TomiXRM/LEGEND_RCJ/MyRobots/MyRobots6.JPG

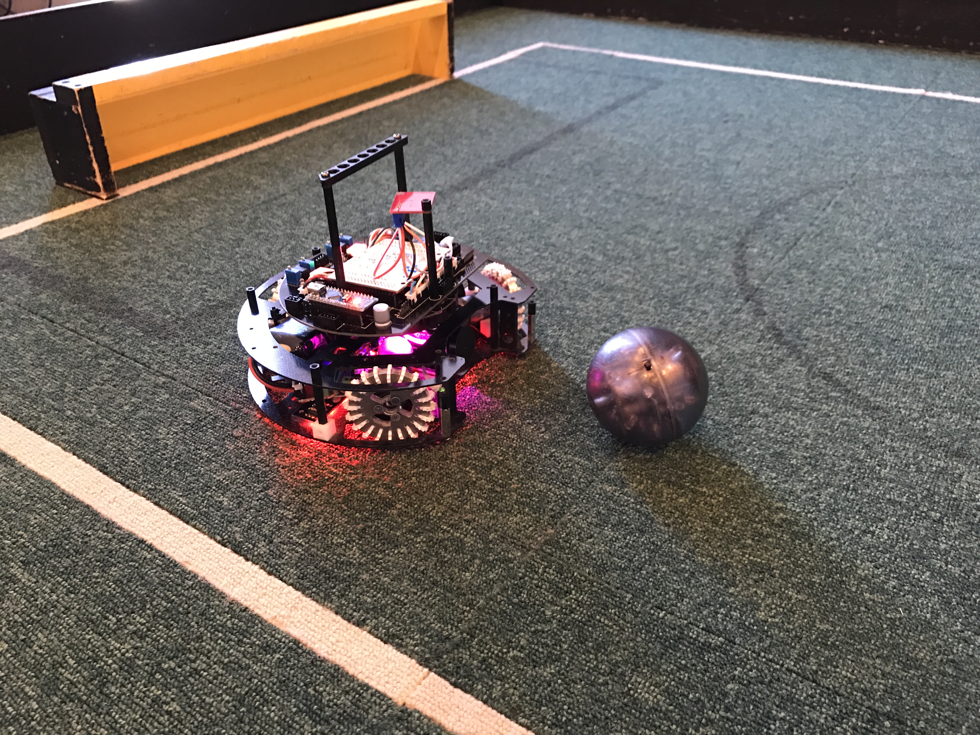
MyRobots/MyRobots6.JPG
