TomiXRM/LEGEND_RCJ/MyRobots/MyRobots5.jpg

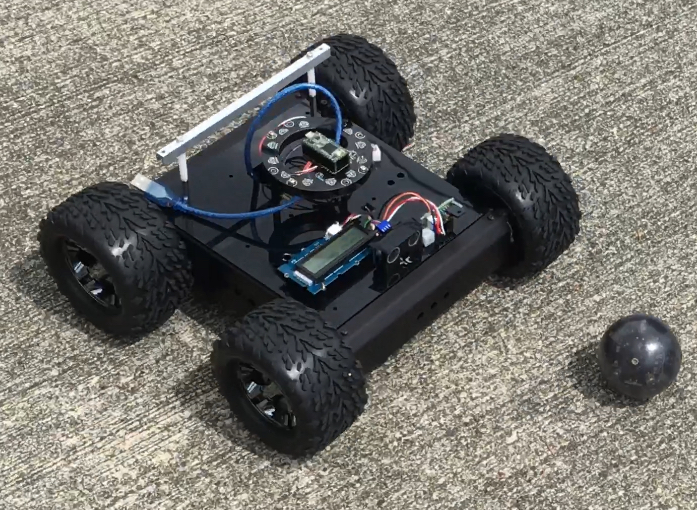
MyRobots/MyRobots5.jpg
