TomiXRM/LEGEND_RCJ/MyRobots/IMG_3049.jpg

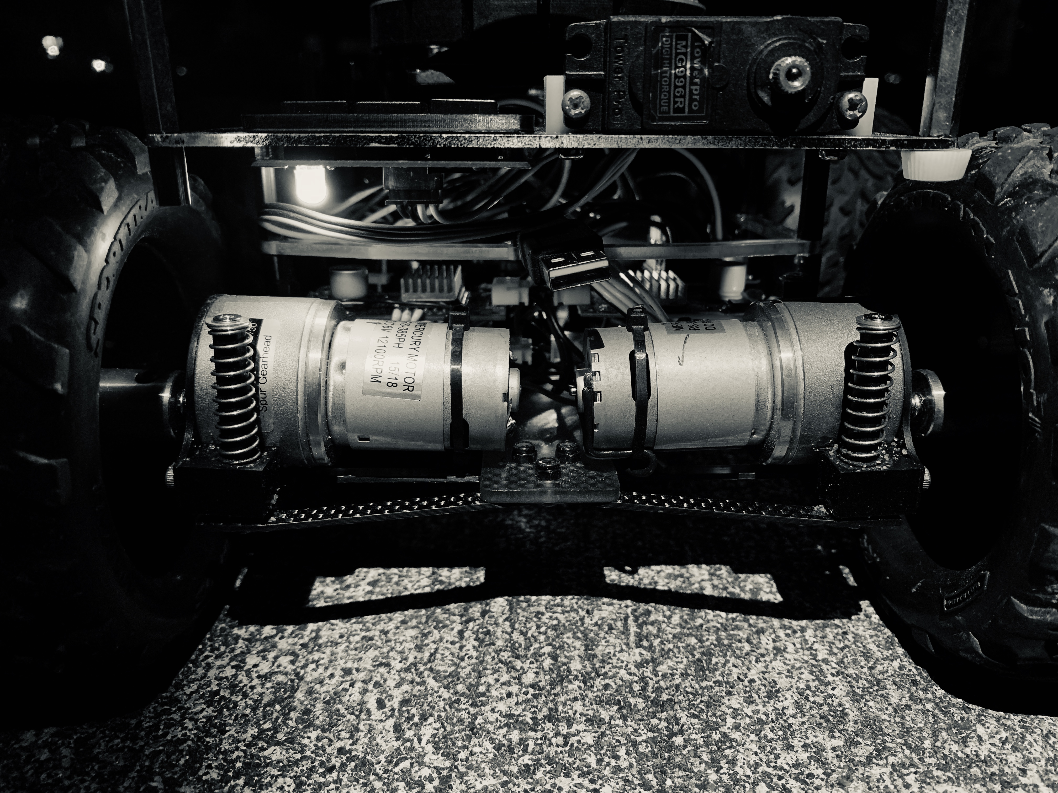
MyRobots/IMG_3049.jpg
