TomiXRM/LEGEND_RCJ/MyRobots/MyRobots3.JPG

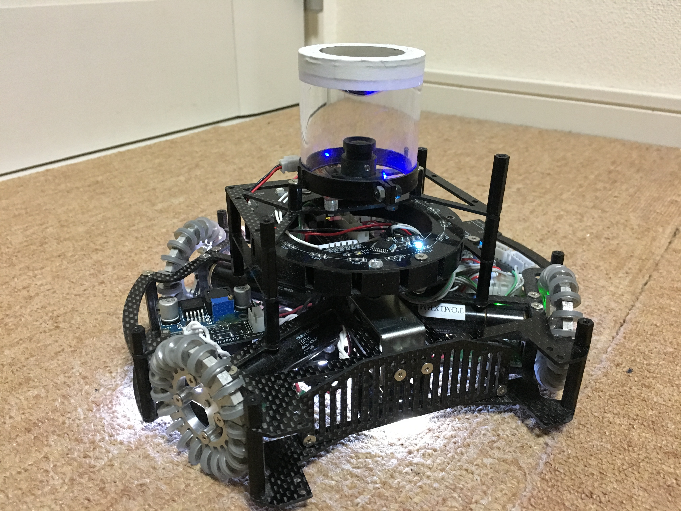
MyRobots/MyRobots3.JPG
