TomiXRM/LEGEND_RCJ/MyRobots/MyRobots7.jpg

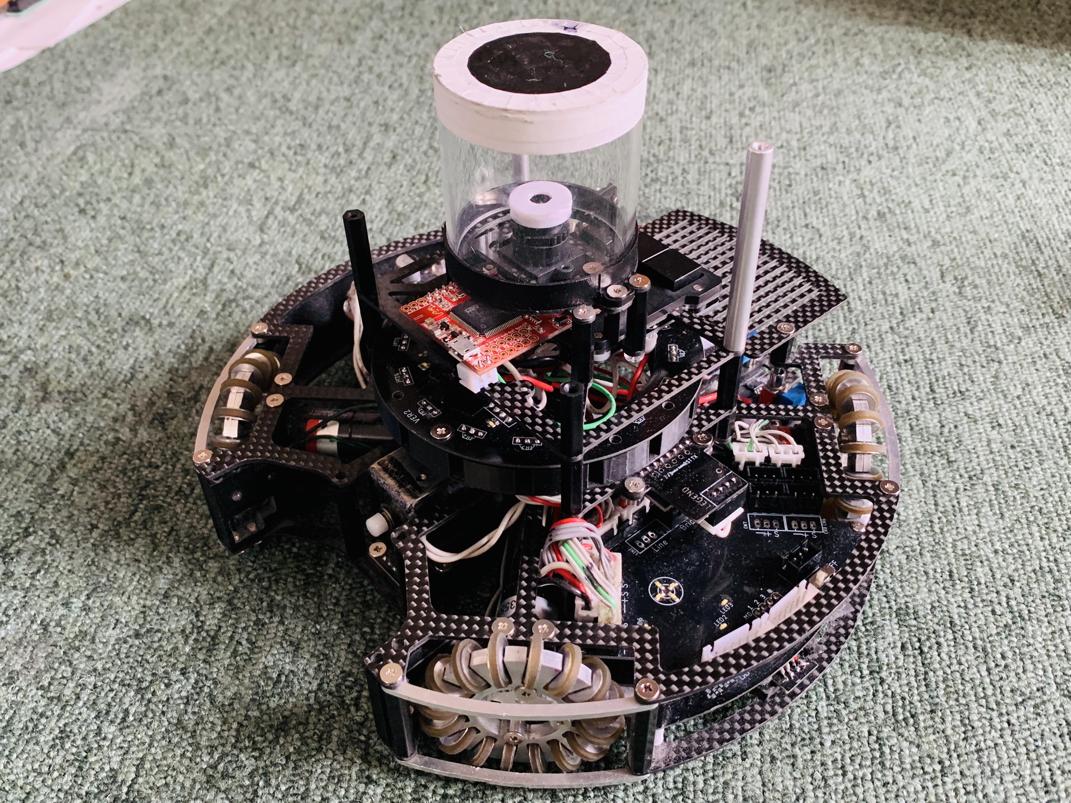
MyRobots/MyRobots7.jpg
