TomiXRM/LEGEND_RCJ/MyRobots/MyRobots9.JPG

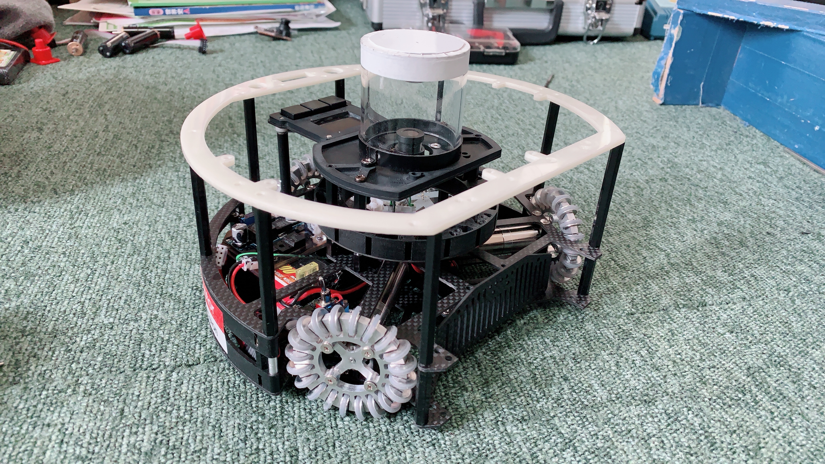
MyRobots/MyRobots9.JPG
