TomiXRM/LEGEND_RCJ/MyRobots/MyRobots10.jpg

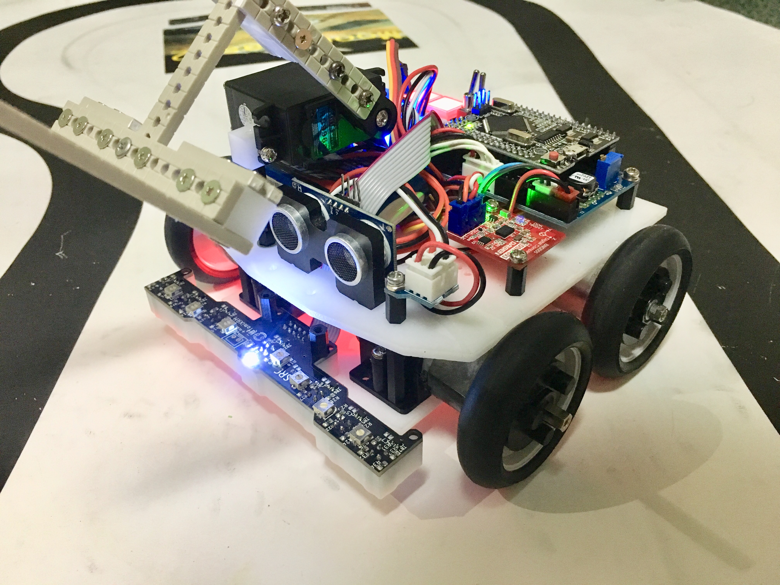
MyRobots/MyRobots10.jpg
