TomiXRM/LEGEND_RCJ/RoboCup2022 SSL/Hardware2021/うち歯車キャリア/加工経路リスト.png

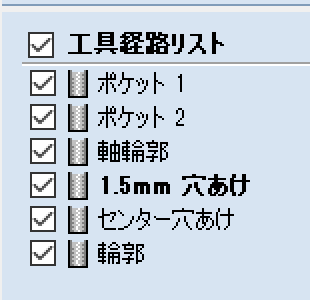
RoboCup2022 SSL/Hardware2021/うち歯車キャリア/加工経路リスト.png
