TomiXRM/LEGEND_RCJ/RoboCup-LEGEND2021/circuit/LEGEND2022/main.dxf

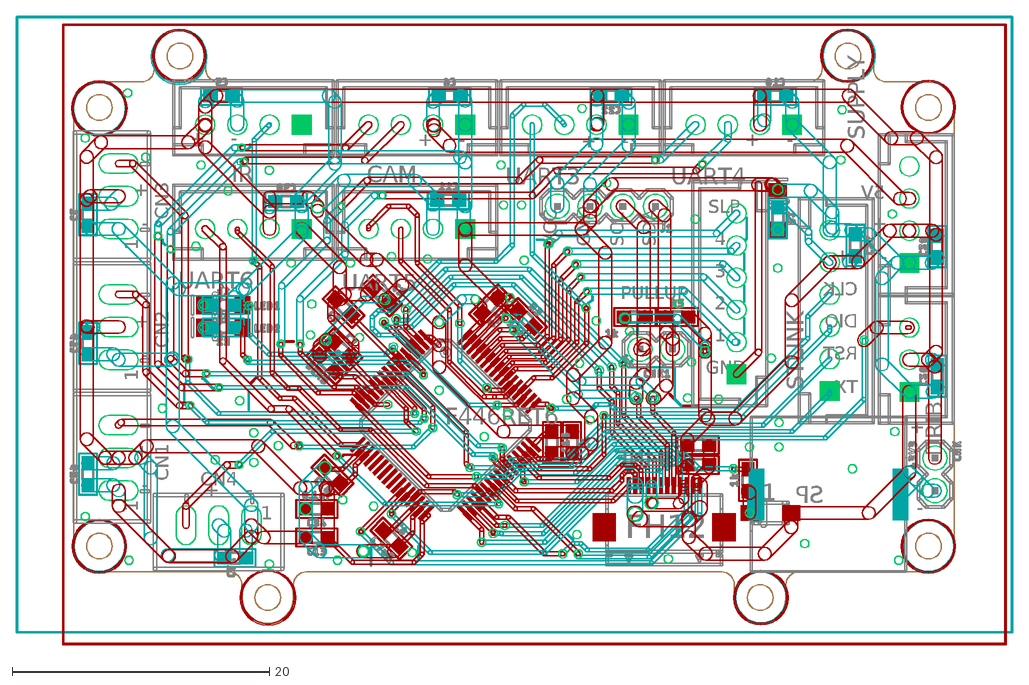
[picture p10: CAD file, 2023-12-11]
RoboCup-LEGEND2021/circuit/LEGEND2022/main.dxf
FH12
VCC
GND
SCL
SDA
+
-
5V
CLK
DIO
RST
TX
SLP
4
3
2
1
PULLUP
CAM
CN1
CN2
CN3
CN4
D1
DRIB
IR
LINE
F446RET6
SP
STLINK
SUPPLY
UART3
UART4
UART5
UART6
UI
