TomiXRM/LEGEND_RCJ/RoboCup2019_Optimized/mechanical design/MAIN2019.dxf

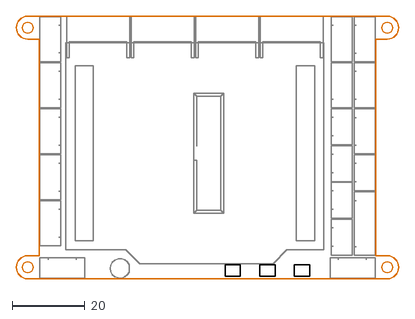
[picture p11: CAD file, 2023-12-11]
RoboCup2019_Optimized/mechanical design/MAIN2019.dxf
105.4 x 72.4
