TomiXRM/LEGEND_RCJ/RoboCup2019_Optimized/mechanical design/DCX固定台Ri-oneNano.dxf

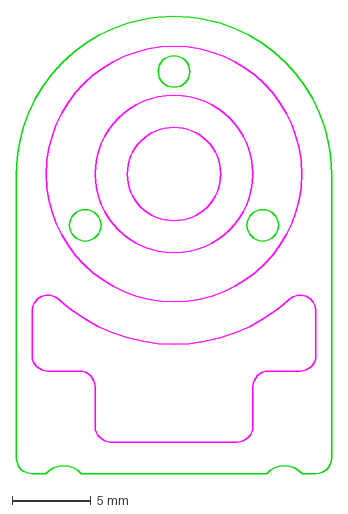
[picture p12: CAD file, 2023-12-11]
RoboCup2019_Optimized/mechanical design/DCX固定台Ri-oneNano.dxf
20.0 x 29.0 mm
