TomiXRM/LEGEND_RCJ/RoboCup2019_Optimized/mechanical design/TomiXRMⅢ/3号機十字.dxf

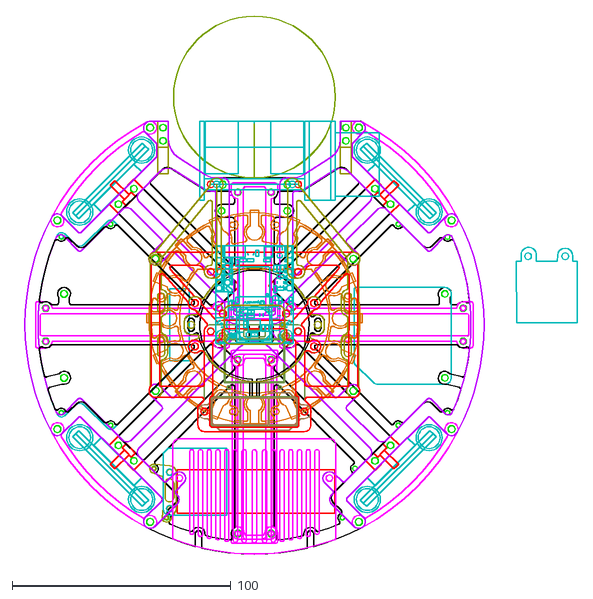
[picture p13: CAD file, 2023-12-11]
RoboCup2019_Optimized/mechanical design/TomiXRMⅢ/3号機十字.dxf
256.6 x 248.2
