TomiXRM/LEGEND_RCJ/RoboCup2020/mechanical design/CNCBox/CNCBox1.dxf

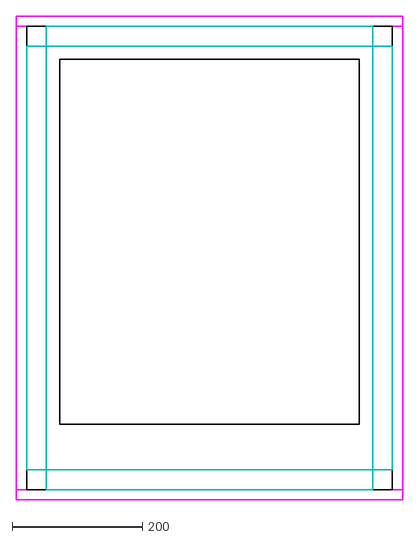
[picture p14: CAD file, 2023-12-11]
RoboCup2020/mechanical design/CNCBox/CNCBox1.dxf
592.0 x 742.0
