TomiXRM/LEGEND_RCJ/RoboCup2020/mechanical design/Japan/3輪バージョン.dxf

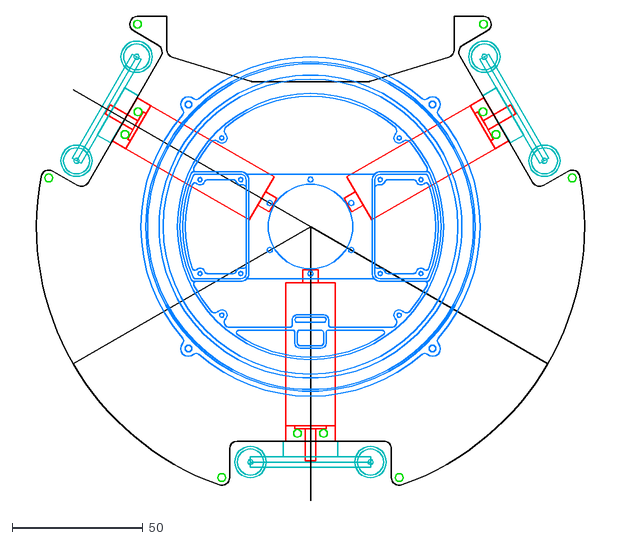
[picture p15: CAD file, 2023-12-11]
RoboCup2020/mechanical design/Japan/3輪バージョン.dxf
225.4 x 185.5
