TomiXRM/LEGEND_RCJ/RoboCup2020/mechanical design/シャーシ横.dxf

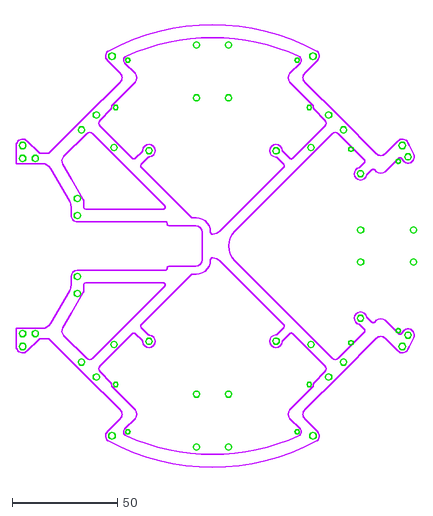
[picture p16: CAD file, 2023-12-11]
RoboCup2020/mechanical design/シャーシ横.dxf
190.1 x 218.1
