TomiXRM/LEGEND_RCJ/RoboCup2020/mechanical design/基板切削/hogokairo.dxf

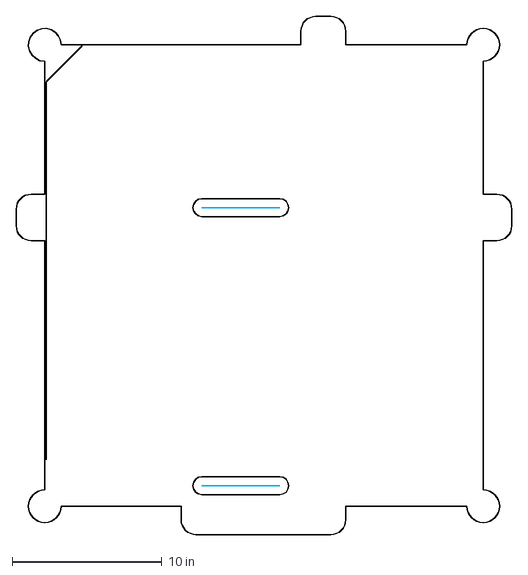
[picture p17: CAD file, 2023-12-11]
RoboCup2020/mechanical design/基板切削/hogokairo.dxf
33.1 x 34.7 in
