TomiXRM/LEGEND_RCJ/RoboCup2022 SSL/Hardware2021_/omni/工作センター/8:2/ピニオンギア.step

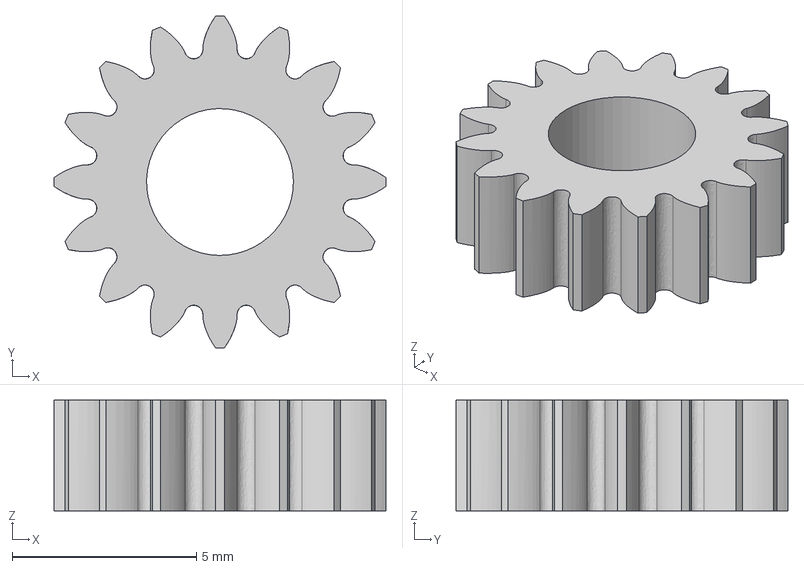
[picture p18: CAD file, 2023-12-11]
RoboCup2022 SSL/Hardware2021_/omni/工作センター/8:2/ピニオンギア.step
9.00 x 9.00 x 3.00 mm
