TomiXRM/LEGEND_RCJ/RoboCup2022 SSL/Hardware2021_/モーターマウント/内歯車キャリア.dxf

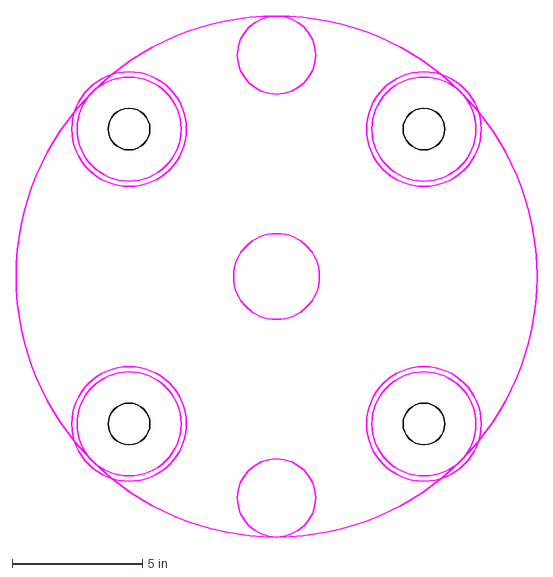
[picture p19: CAD file, 2023-12-11]
RoboCup2022 SSL/Hardware2021_/モーターマウント/内歯車キャリア.dxf
20.0 x 20.0 in
