TomiXRM/LEGEND_RCJ/RoboCup2022 SSL/Planetary gear/内歯車1.step

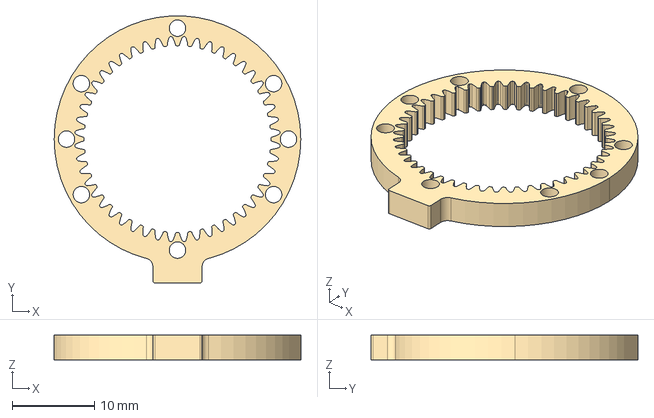
[picture p20: CAD file, 2023-12-11]
RoboCup2022 SSL/Planetary gear/内歯車1.step
30.0 x 32.5 x 3.00 mm
