TomiXRM/LEGEND_RCJ/RoboCup2019_Optimized/mechanical design/ミラーの方をプレスするやつ.dxf

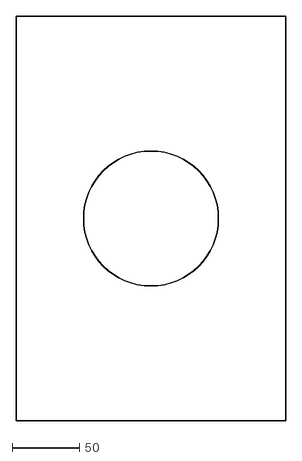
[picture p21: CAD file, 2023-12-11]
RoboCup2019_Optimized/mechanical design/ミラーの方をプレスするやつ.dxf
200.0 x 300.0
