TomiXRM/LEGEND_RCJ/RoboCup2020/mechanical design/基板切削/MDカバー.dxf

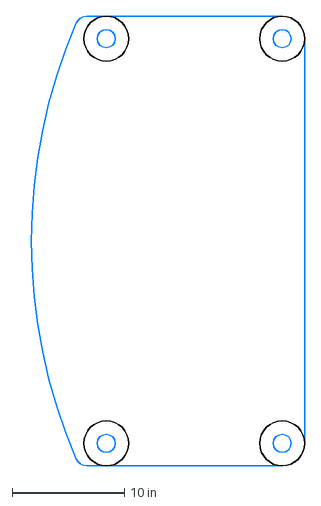
[picture p22: CAD file, 2023-12-11]
RoboCup2020/mechanical design/基板切削/MDカバー.dxf
25.7 x 40.0 in
