TomiXRM/LEGEND_RCJ/RoboCup2022 SSL/Hardware2021/omni/testcut_POM.dxf

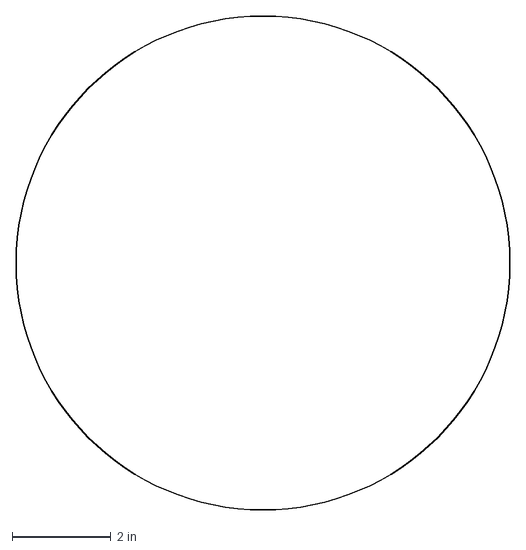
[picture p23: CAD file, 2023-12-11]
RoboCup2022 SSL/Hardware2021/omni/testcut_POM.dxf
10.0 x 10.0 in
