TomiXRM/LEGEND_RCJ/RoboCup2022 SSL/Hardware2021/omniwheel.dxf

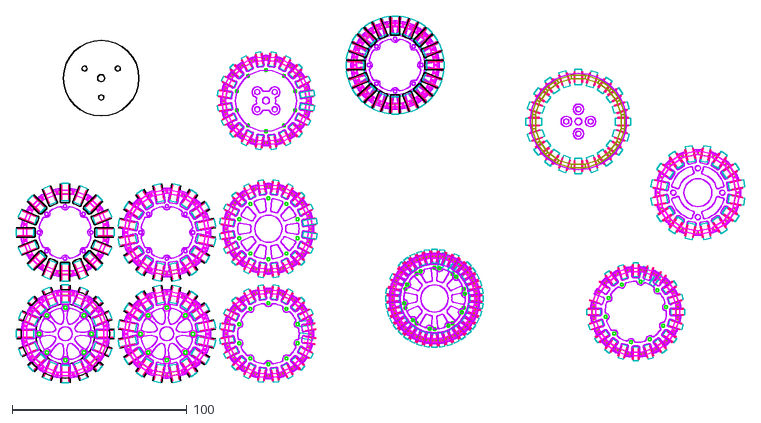
[picture p24: CAD file, 2023-12-11]
RoboCup2022 SSL/Hardware2021/omniwheel.dxf
416.7 x 209.7
