TomiXRM/LEGEND_RCJ/RoboCup2022 SSL/Hardware2021_/omni/工作センター/8:2/遊星ギア.step

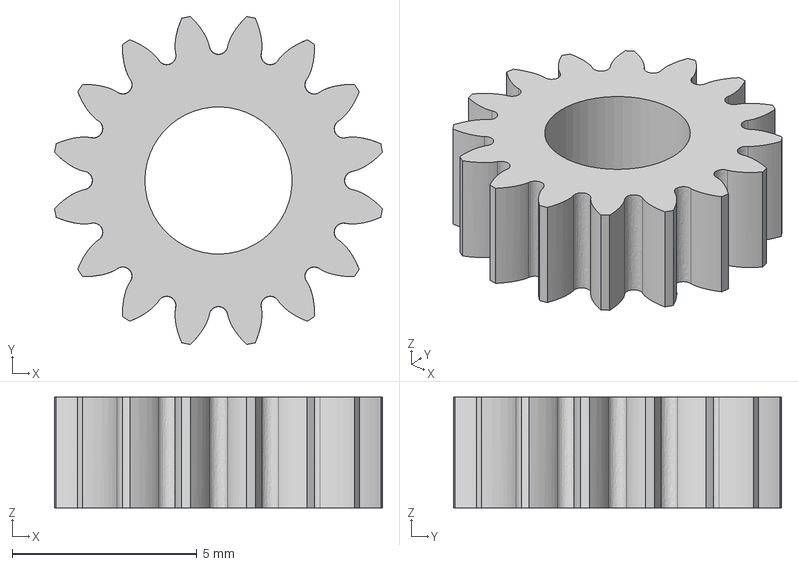
[picture p25: CAD file, 2023-12-11]
RoboCup2022 SSL/Hardware2021_/omni/工作センター/8:2/遊星ギア.step
8.87 x 8.87 x 3.00 mm
