TomiXRM/LEGEND_RCJ/RoboCup2022 SSL/Hardware2021_/robot1.dxf

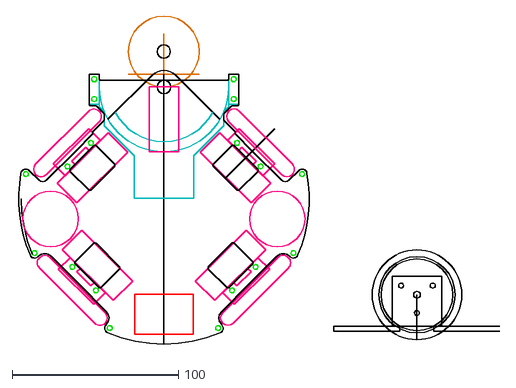
[picture p26: CAD file, 2023-12-11]
RoboCup2022 SSL/Hardware2021_/robot1.dxf
291.5 x 199.8
