TomiXRM/LEGEND_RCJ/RoboCup2019_Optimized/mechanical design/TomiXRMⅢ/2段目外形.dxf

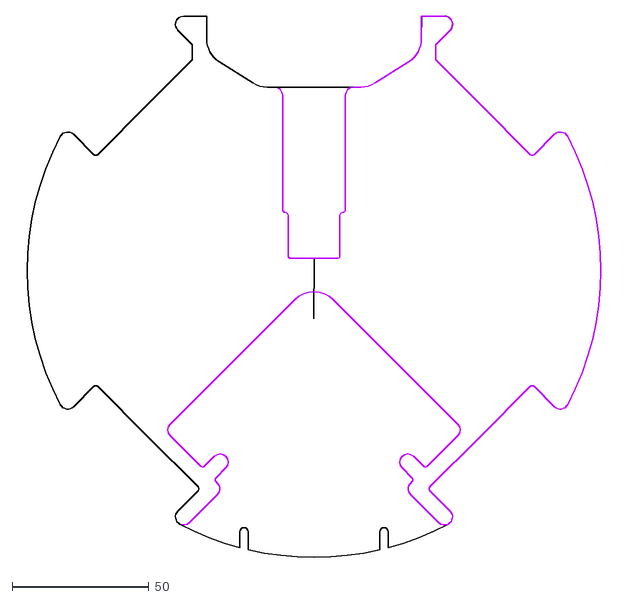
[picture p27: CAD file, 2023-12-11]
RoboCup2019_Optimized/mechanical design/TomiXRMⅢ/2段目外形.dxf
218.1 x 199.1
