TomiXRM/LEGEND_RCJ/RoboCup2019_Optimized/mechanical design/World2019/ドリブラーのハブ.dxf

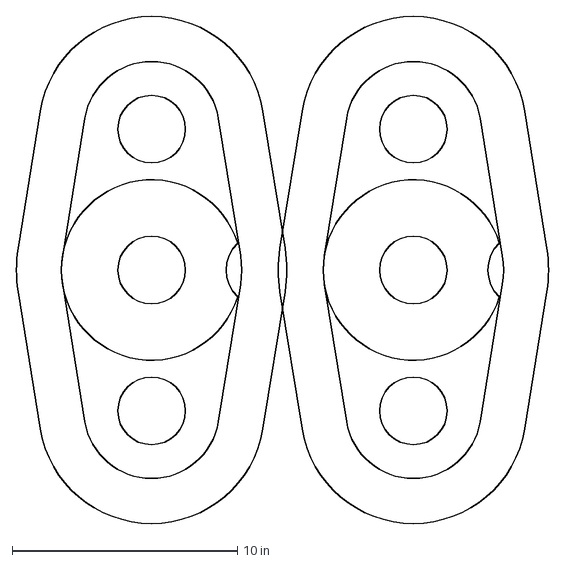
[picture p28: CAD file, 2023-12-11]
RoboCup2019_Optimized/mechanical design/World2019/ドリブラーのハブ.dxf
23.6 x 22.5 in
