TomiXRM/LEGEND_RCJ/RoboCup2022 SSL/Hardware2021/omni/inner Spacer.dxf

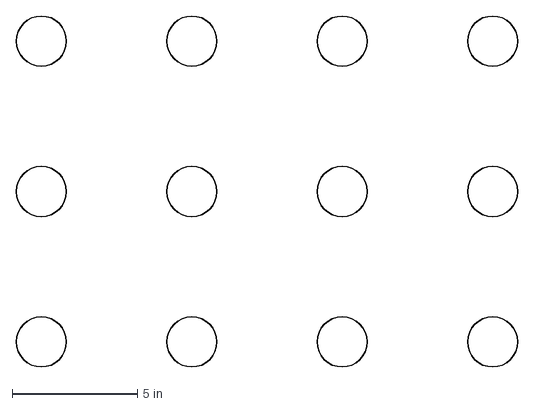
[picture p29: CAD file, 2023-12-11]
RoboCup2022 SSL/Hardware2021/omni/inner Spacer.dxf
20.0 x 14.0 in
