TomiXRM/LEGEND_RCJ/RoboCup2022 SSL/Hardware2021_/omni/工作センター/8:2/遊星ギア固定具.step

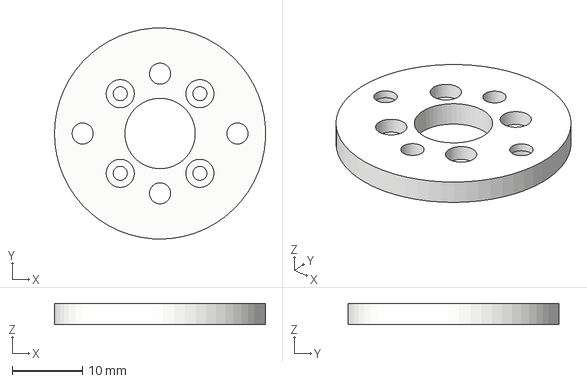
[picture p30: CAD file, 2023-12-11]
RoboCup2022 SSL/Hardware2021_/omni/工作センター/8:2/遊星ギア固定具.step
30.0 x 30.0 x 3.00 mm
