TomiXRM/LEGEND_RCJ/RoboCup2019_Optimized/mechanical design/TomiXRMⅢ/キーパー2.dxf

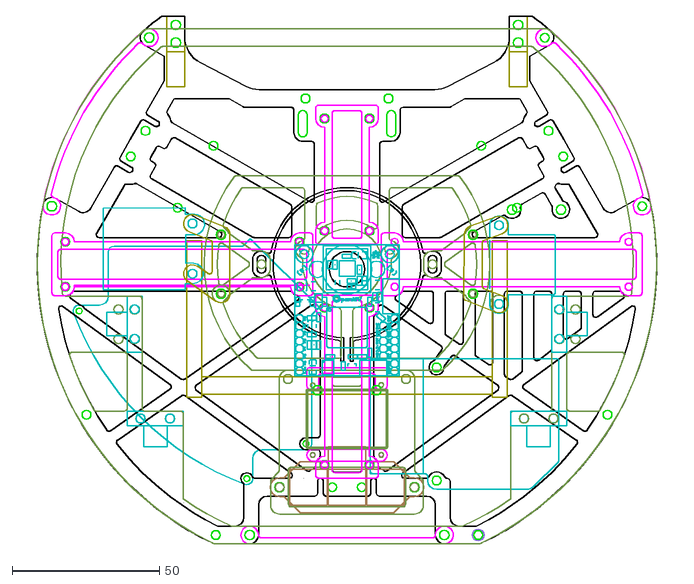
[picture p31: CAD file, 2023-12-11]
RoboCup2019_Optimized/mechanical design/TomiXRMⅢ/キーパー2.dxf
224.5 x 178.9
