TomiXRM/LEGEND_RCJ/RoboCup2022 SSL/Hardware2021_/omni/outer Spacer.dxf

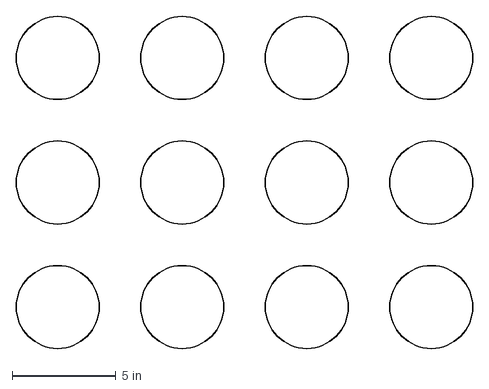
[picture p32: CAD file, 2023-12-11]
RoboCup2022 SSL/Hardware2021_/omni/outer Spacer.dxf
22.0 x 16.0 in
