TomiXRM/LEGEND_RCJ/RoboCup2022 SSL/Hardware2021_/omni/工作センター/8:2/内歯車 v2.step

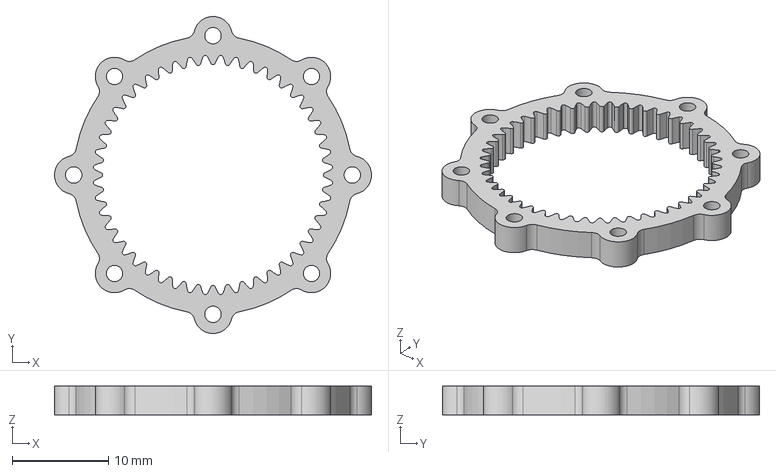
[picture p33: CAD file, 2023-12-11]
RoboCup2022 SSL/Hardware2021_/omni/工作センター/8:2/内歯車 v2.step
33.0 x 33.0 x 3.00 mm
