TomiXRM/LEGEND_RCJ/RoboCup2019_Optimized/mechanical design/World2019/モーター固定台 インホイール型.dxf

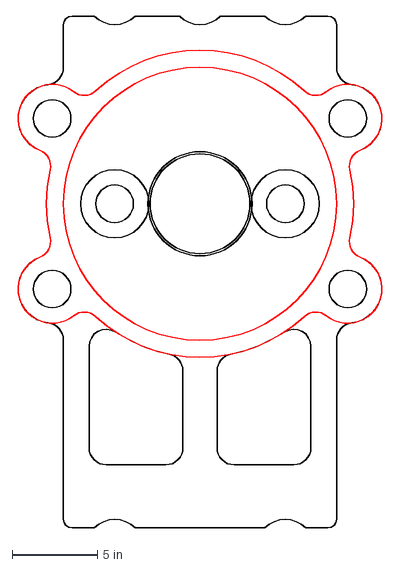
[picture p34: CAD file, 2023-12-11]
RoboCup2019_Optimized/mechanical design/World2019/モーター固定台 インホイール型.dxf
21.5 x 30.0 in
