TomiXRM/LEGEND_RCJ/RoboCup2020/mechanical design/オムニハブ.dxf

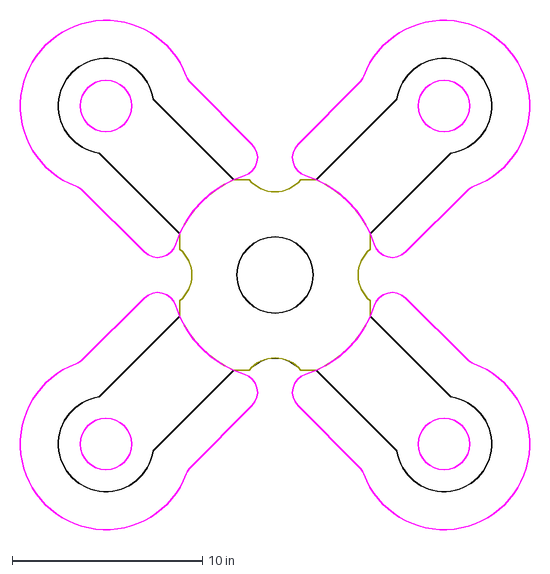
[picture p35: CAD file, 2023-12-11]
RoboCup2020/mechanical design/オムニハブ.dxf
27.2 x 27.2 in
