TomiXRM/LEGEND_RCJ/RoboCup2019_Optimized/mechanical design/LEGEND 後期/3号機.dxf

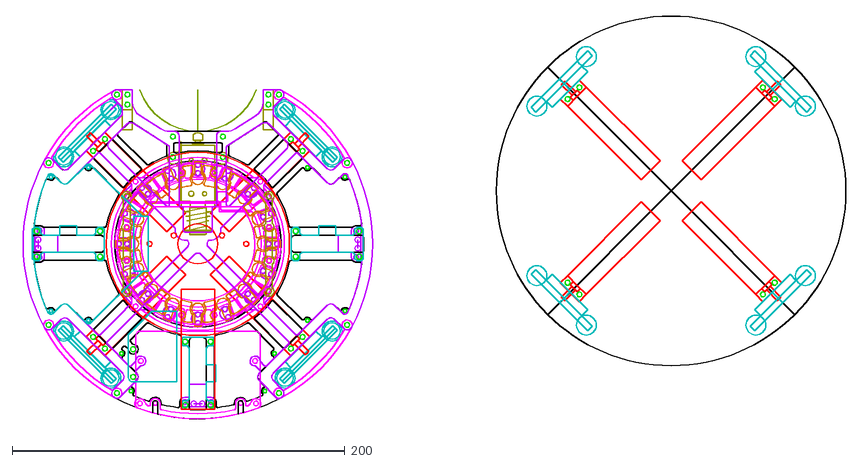
[picture p36: CAD file, 2023-12-11]
RoboCup2019_Optimized/mechanical design/LEGEND 後期/3号機.dxf
498.5 x 245.0
