TomiXRM/LEGEND_RCJ/RoboCup2019_Optimized/mechanical design/ヒートプレスの枠.dxf

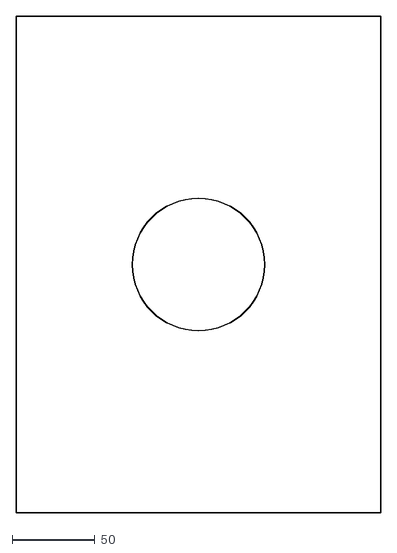
[picture p37: CAD file, 2023-12-11]
RoboCup2019_Optimized/mechanical design/ヒートプレスの枠.dxf
220.0 x 300.0
