TomiXRM/LEGEND_RCJ/RoboCup2019_Optimized/mechanical design/LEGEND 後期/部室.dxf

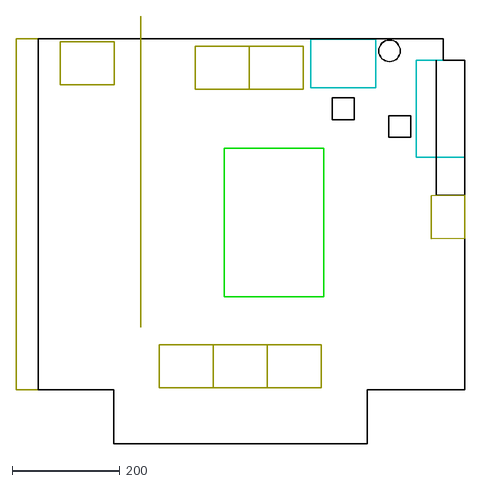
[picture p38: CAD file, 2023-12-11]
RoboCup2019_Optimized/mechanical design/LEGEND 後期/部室.dxf
830.0 x 791.0
