TomiXRM/LEGEND_RCJ/RoboCup2019_Optimized/mechanical design/LEGEND 後期/MD固定.dxf

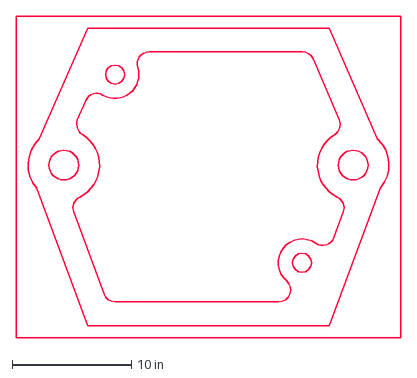
[picture p39: CAD file, 2023-12-11]
RoboCup2019_Optimized/mechanical design/LEGEND 後期/MD固定.dxf
32.3 x 27.0 in
