TomiXRM/LEGEND_RCJ/RoboCup2020/mechanical design/sideWheel_vertical300.dxf

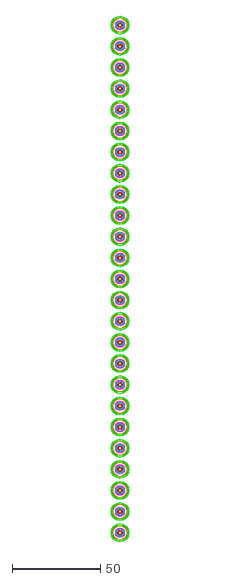
[picture p40: CAD file, 2023-12-11]
RoboCup2020/mechanical design/sideWheel_vertical300.dxf
10.0 x 298.2
