TomiXRM/LEGEND_RCJ/RoboCup2019_Optimized/mechanical design/LEGEND 後期/LEGEND.dxf

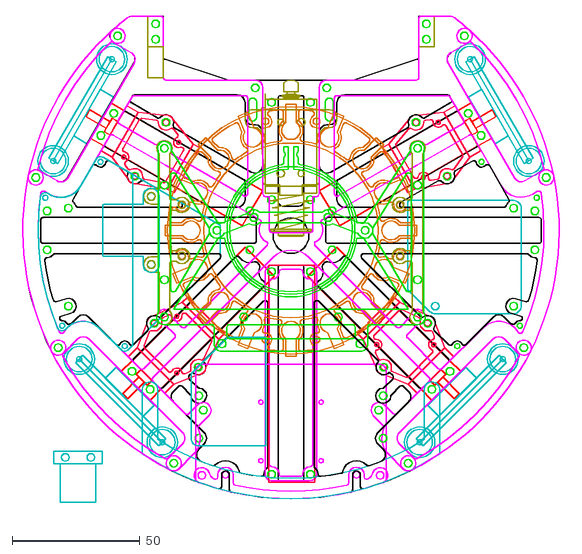
[picture p41: CAD file, 2023-12-11]
RoboCup2019_Optimized/mechanical design/LEGEND 後期/LEGEND.dxf
215.2 x 194.7
