TomiXRM/LEGEND_RCJ/RoboCup2020/mechanical design/ドリブラヒンジ.dxf

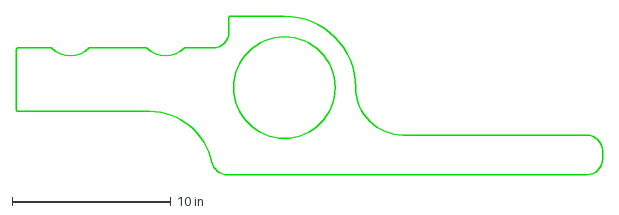
[picture p42: CAD file, 2023-12-11]
RoboCup2020/mechanical design/ドリブラヒンジ.dxf
37.0 x 10.0 in
