TomiXRM/LEGEND_RCJ/RoboCup2019_Optimized/mechanical design/M2スペーサー.dxf

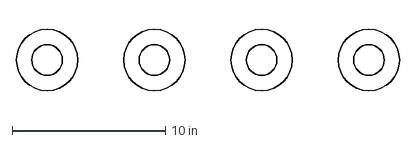
[picture p43: CAD file, 2023-12-11]
RoboCup2019_Optimized/mechanical design/M2スペーサー.dxf
25.0 x 4.00 in
