TomiXRM/LEGEND_RCJ/RoboCup2020/mechanical design/切削ABS3mm.dxf

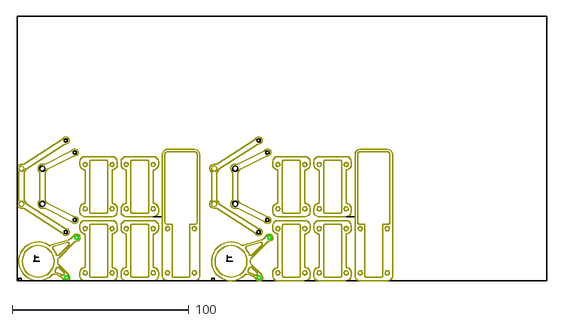
[picture p44: CAD file, 2023-12-11]
RoboCup2020/mechanical design/切削ABS3mm.dxf
300.3 x 151.1
