TomiXRM/LEGEND_RCJ/RoboCup2019_Optimized/mechanical design/TomiXRMⅢ/メイン基盤固定道具.dxf

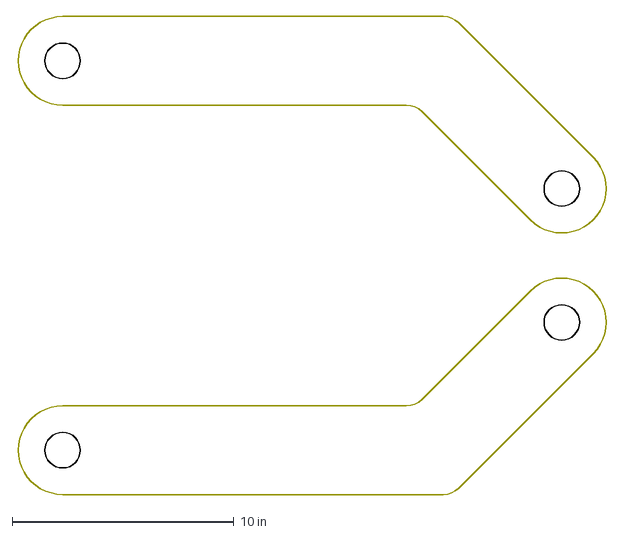
[picture p45: CAD file, 2023-12-11]
RoboCup2019_Optimized/mechanical design/TomiXRMⅢ/メイン基盤固定道具.dxf
26.7 x 21.6 in
