TomiXRM/LEGEND_RCJ/RoboCup2019_Optimized/mechanical design/World2019/キーパーworld.dxf

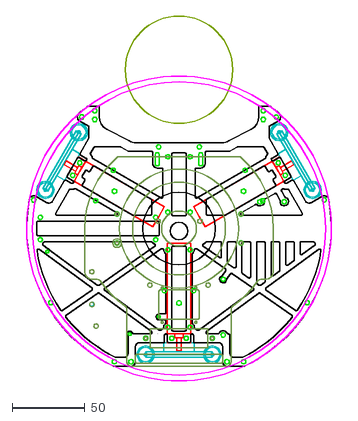
[picture p46: CAD file, 2023-12-11]
RoboCup2019_Optimized/mechanical design/World2019/キーパーworld.dxf
224.5 x 251.4
