TomiXRM/LEGEND_RCJ/RoboCup2019_Optimized/mechanical design/サイドホイール.dxf

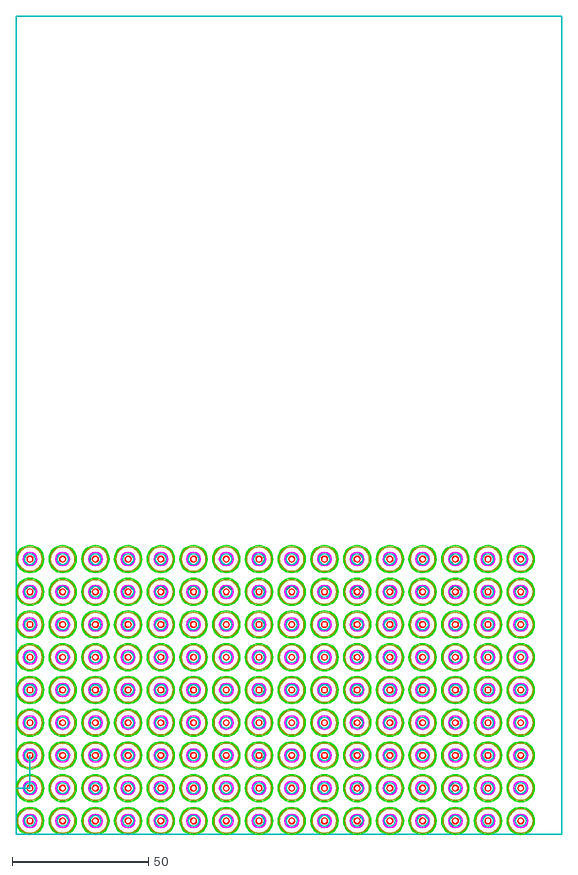
[picture p47: CAD file, 2023-12-11]
RoboCup2019_Optimized/mechanical design/サイドホイール.dxf
200.0 x 300.0
