TomiXRM/LEGEND_RCJ/RoboCup2019_Optimized/mechanical design/World2019/ドリブラーヒンジ.dxf

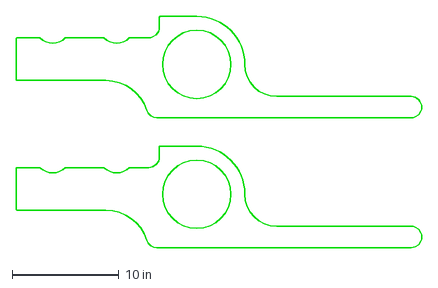
[picture p48: CAD file, 2023-12-11]
RoboCup2019_Optimized/mechanical design/World2019/ドリブラーヒンジ.dxf
38.0 x 21.7 in
