TomiXRM/LEGEND_RCJ/RoboCup2019_Optimized/mechanical design/ハブ(52mm用).dxf

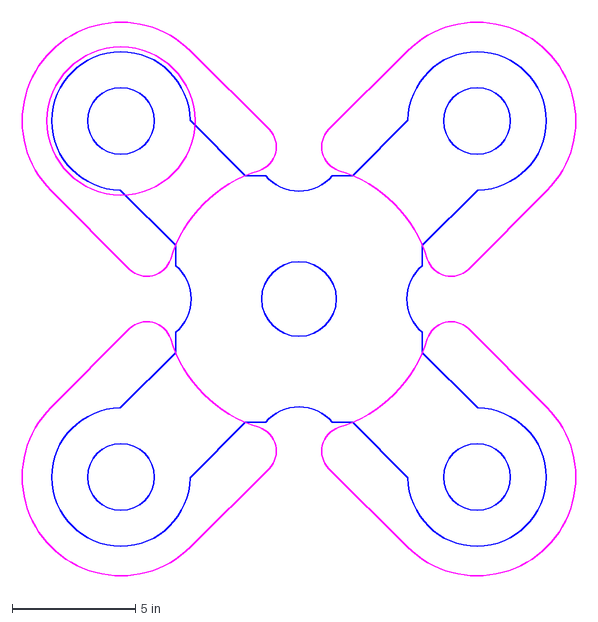
[picture p49: CAD file, 2023-12-11]
RoboCup2019_Optimized/mechanical design/ハブ(52mm用).dxf
22.9 x 22.9 in
