TomiXRM/LEGEND_RCJ/RoboCup2020/mechanical design/保護回路.dxf

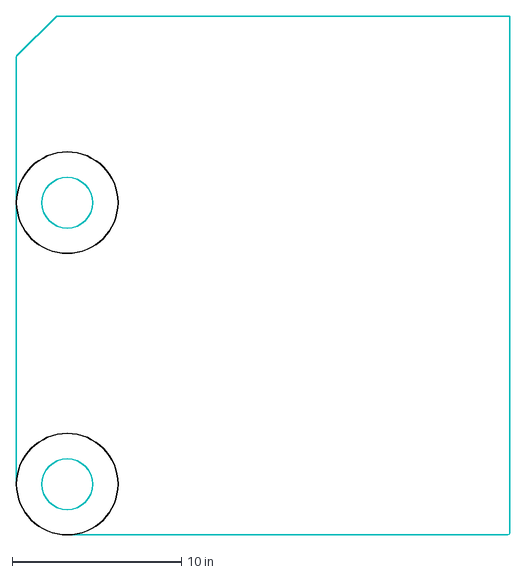
[picture p50: CAD file, 2023-12-11]
RoboCup2020/mechanical design/保護回路.dxf
29.1 x 30.7 in
