TomiXRM/LEGEND_RCJ/RoboCup2019_Optimized/mechanical design/World2019/3号機十字World.dxf

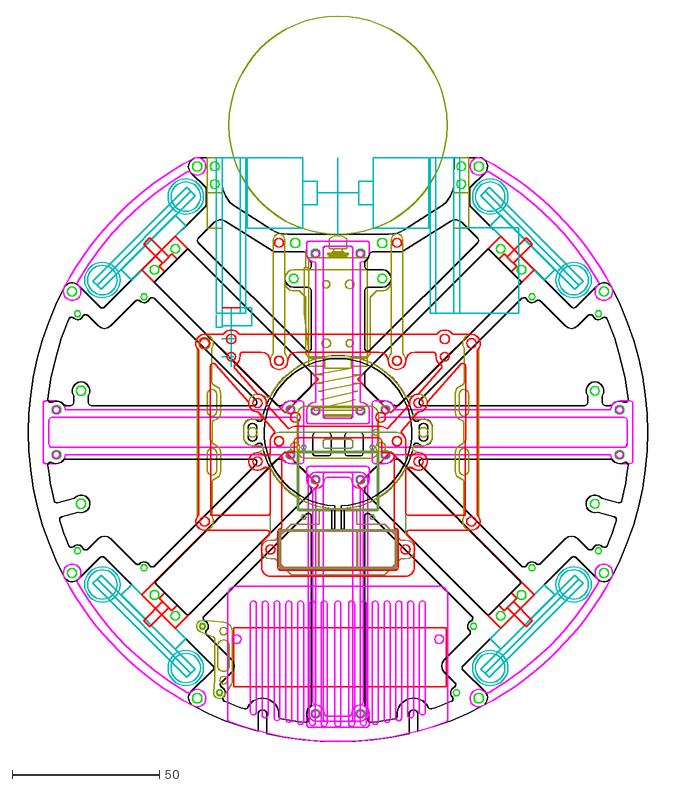
[picture p51: CAD file, 2023-12-11]
RoboCup2019_Optimized/mechanical design/World2019/3号機十字World.dxf
218.1 x 248.2
