TomiXRM/LEGEND_RCJ/RoboCup2019_Optimized/mechanical design/LEGEND 後期/LEGENDエンジェルラインセンサバージョン.dxf

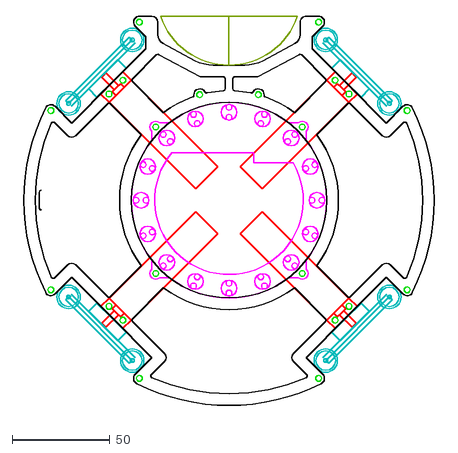
[picture p52: CAD file, 2023-12-11]
RoboCup2019_Optimized/mechanical design/LEGEND 後期/LEGENDエンジェルラインセンサバージョン.dxf
217.5 x 202.8
