TomiXRM/LEGEND_RCJ/RoboCup2020/mechanical design/TSSP58038.dxf

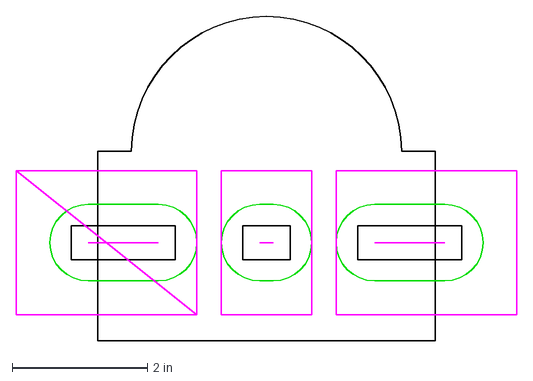
[picture p53: CAD file, 2023-12-11]
RoboCup2020/mechanical design/TSSP58038.dxf
7.42 x 4.80 in
