TomiXRM/LEGEND_RCJ/RoboCup2019_Optimized/mechanical design/LEGEND 後期/四輪工藤.dxf

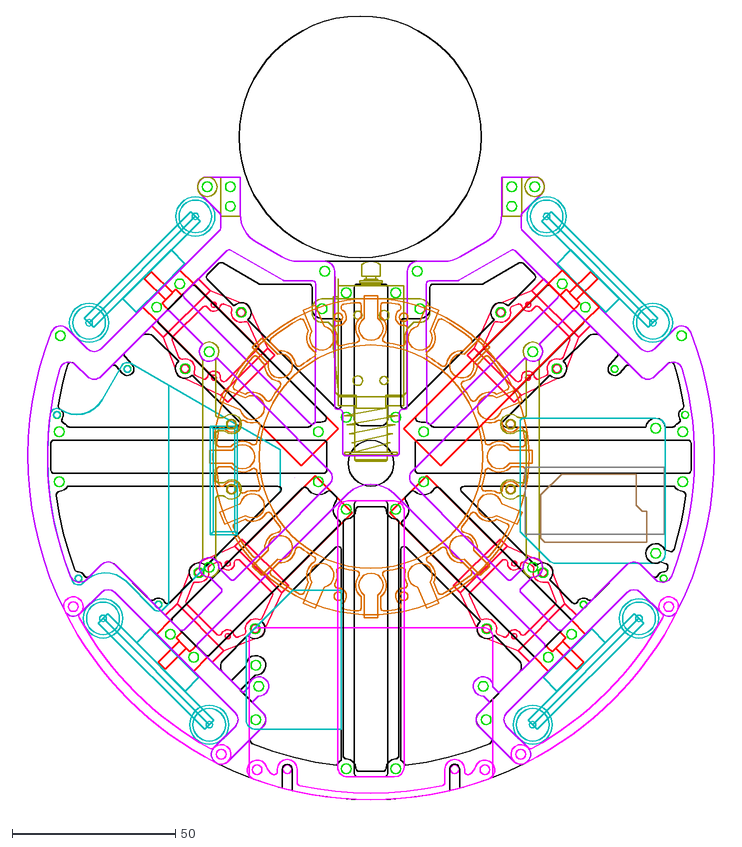
[picture p54: CAD file, 2023-12-11]
RoboCup2019_Optimized/mechanical design/LEGEND 後期/四輪工藤.dxf
217.3 x 242.1
