TomiXRM/LEGEND_RCJ/RoboCup2019_Optimized/mechanical design/TomiXRMⅢ/3号機.dxf

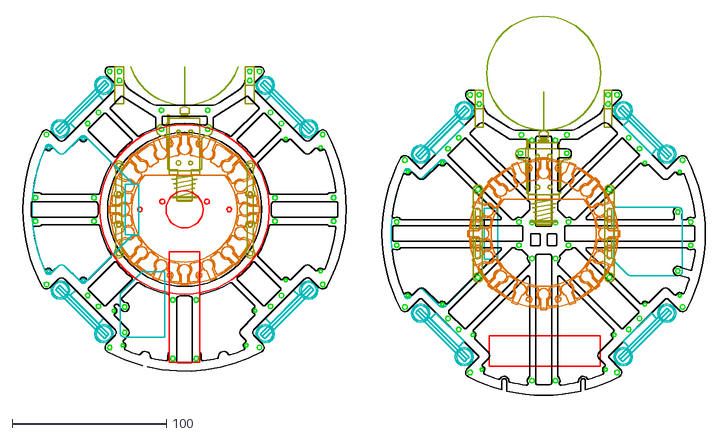
[picture p55: CAD file, 2023-12-11]
RoboCup2019_Optimized/mechanical design/TomiXRMⅢ/3号機.dxf
451.5 x 247.1
