TomiXRM/LEGEND_RCJ/RoboCup2020/mechanical design/Robot2020_World2019仕様.dxf

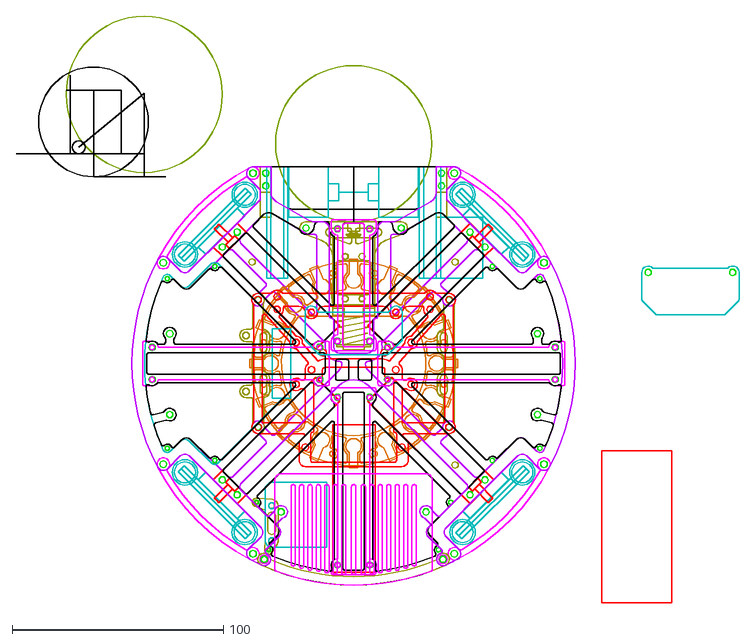
[picture p56: CAD file, 2023-12-11]
RoboCup2020/mechanical design/Robot2020_World2019仕様.dxf
342.5 x 277.8
