TomiXRM/LEGEND_RCJ/RoboCup2019_Optimized/mechanical design/LEGEND 後期/3段目(エンジェル).dxf

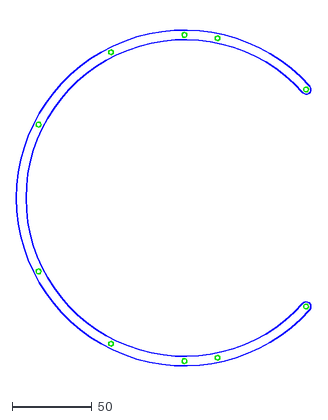
[picture p57: CAD file, 2023-12-11]
RoboCup2019_Optimized/mechanical design/LEGEND 後期/3段目(エンジェル).dxf
184.5 x 227.3
