TomiXRM/LEGEND_RCJ/RoboCup2019_Optimized/mechanical design/TomiXRMⅢ/LCDの固定具.dxf

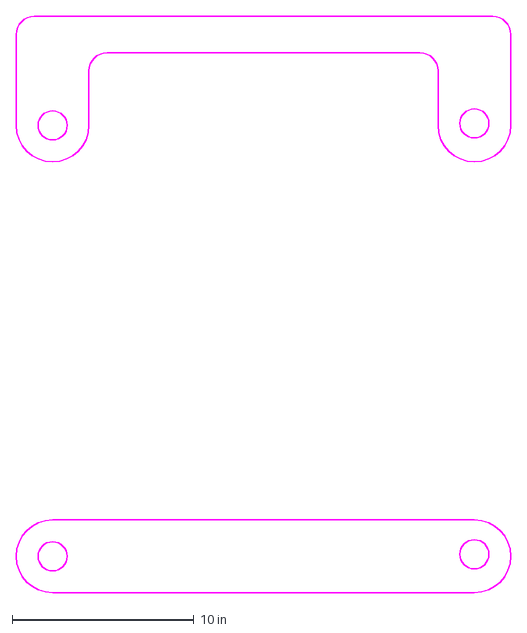
[picture p58: CAD file, 2023-12-11]
RoboCup2019_Optimized/mechanical design/TomiXRMⅢ/LCDの固定具.dxf
27.2 x 31.7 in
