TomiXRM/LEGEND_RCJ/RoboCup2019_Optimized/mechanical design/World2019/どりぶらープーリー.dxf

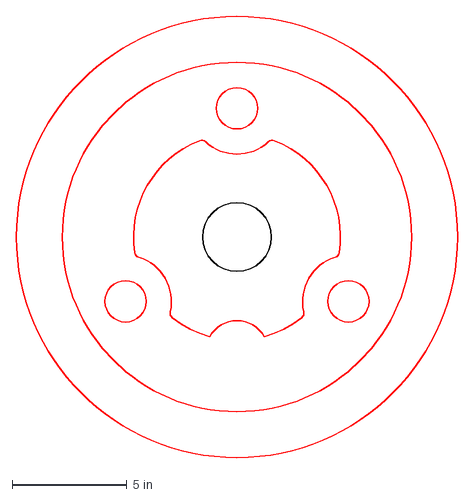
[picture p59: CAD file, 2023-12-11]
RoboCup2019_Optimized/mechanical design/World2019/どりぶらープーリー.dxf
19.2 x 19.2 in
