TomiXRM/LEGEND_RCJ/RoboCup2019_Optimized/mechanical design/キッカー板.dxf

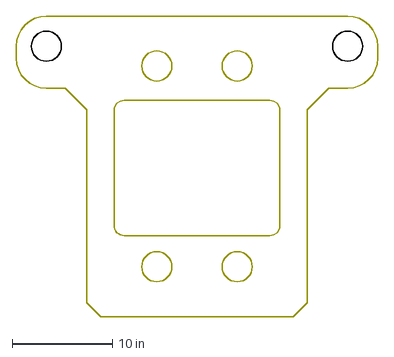
[picture p60: CAD file, 2023-12-11]
RoboCup2019_Optimized/mechanical design/キッカー板.dxf
36.0 x 30.0 in
