TomiXRM/LEGEND_RCJ/RoboCup2019_Optimized/mechanical design/DCX16.dxf

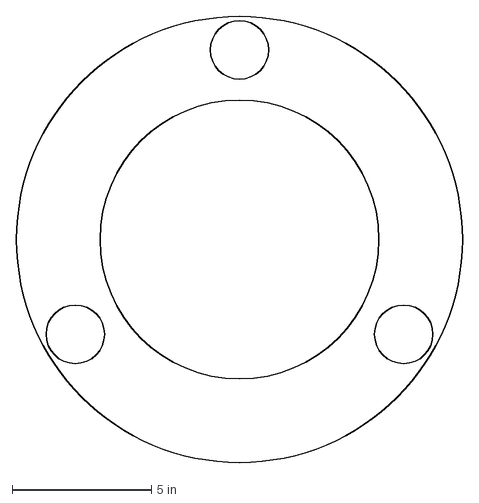
[picture p61: CAD file, 2023-12-11]
RoboCup2019_Optimized/mechanical design/DCX16.dxf
16.0 x 16.0 in
