TomiXRM/LEGEND_RCJ/RoboCup2019_Optimized/mechanical design/フォトセンサ基板.dxf

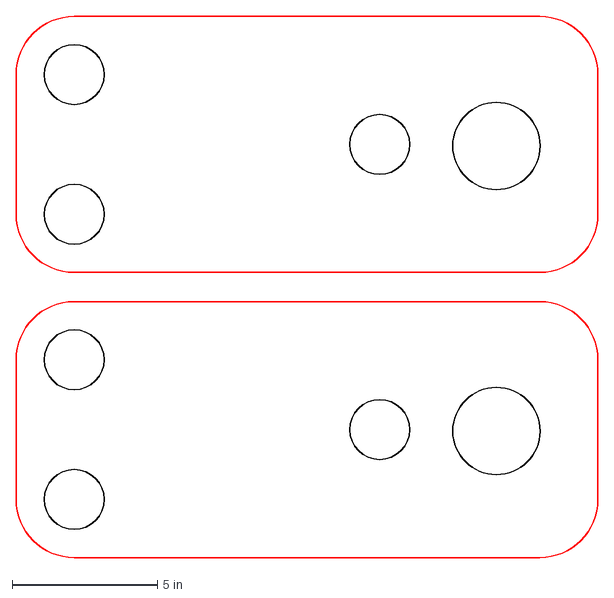
[picture p62: CAD file, 2023-12-11]
RoboCup2019_Optimized/mechanical design/フォトセンサ基板.dxf
20.0 x 18.6 in
