TomiXRM/LEGEND_RCJ/RoboCup2019_Optimized/mechanical design/テーブルフライス.dxf

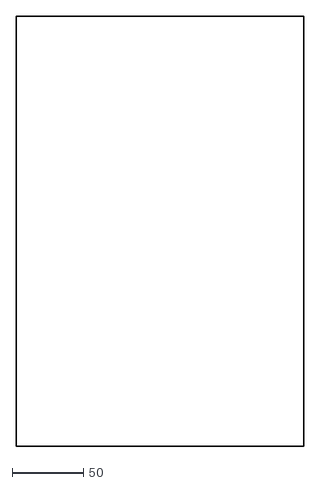
[picture p63: CAD file, 2023-12-11]
RoboCup2019_Optimized/mechanical design/テーブルフライス.dxf
202.0 x 302.0
