TomiXRM/LEGEND_RCJ/RoboCup2020/mechanical design/ドリブラー.dxf

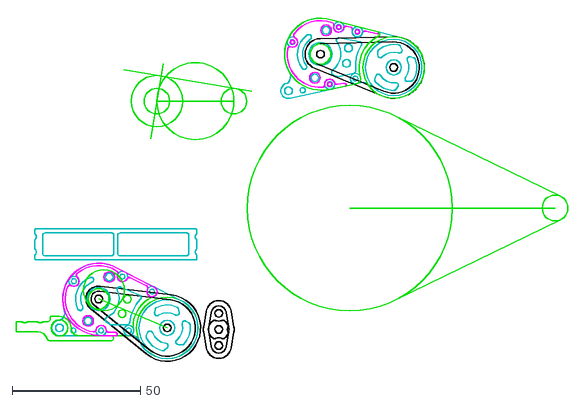
[picture p64: CAD file, 2023-12-11]
RoboCup2020/mechanical design/ドリブラー.dxf
215.1 x 135.4
