TomiXRM/LEGEND_RCJ/(list of files, cad)

Other CAD files:
RoboCup-LEGEND2021/circuit/LEGEND2022/main2.dxf
RoboCup2020/mechanical design/Main_V2.dxf
RoboCup2020/mechanical design/Main kotei.dxf
RoboCup-LEGEND2021/circuit/MD/MDCluster.dxf
RoboCup2019_Optimized/mechanical design/LEGEND 後期/MD.dxf
RoboCup2019_Optimized/mechanical design/World2019/UIcircuit.dxf
RoboCup2020/mechanical design/ドリブラー/POM8mm.dxf
RoboCup2022 SSL/Hardware2021/omni/omniwheel.dxf
RoboCup2022 SSL/Hardware2021/両面加工.dxf
RoboCup2022 SSL/Hardware2021_/omni/omniwheel.dxf
RoboCup2022 SSL/Hardware2021_/両面加工.dxf
RoboCup2019_Optimized/mechanical design/LEGEND 後期/基板たち.dxf
RoboCup2019_Optimized/mechanical design/TomiXRMⅢ/ドリブラのハブ.dxf
RoboCup2019_Optimized/mechanical design/World2019/ドリブラー.dxf
RoboCup2020/mechanical design/ドリブラー/カバー8mm.dxf
RoboCup2020/mechanical design/メイン基板(ジャパンオープン).dxf
RoboCup2019_Optimized/mechanical design/LEGEND 後期/オムニバンパー.dxf
RoboCup2019_Optimized/mechanical design/カメラのミラー固定板.dxf
RoboCup2020/mechanical design/2021.dxf
RoboCup2020/mechanical design/基板切削/IRsensor.dxf
RoboCup2022 SSL/Hardware2021_/omni/Omni54mm.dxf
RoboCup2019_Optimized/mechanical design/IR遮蔽3mmVER.dxf
RoboCup2019_Optimized/mechanical design/LEGEND 後期/SR04カバ.dxf
RoboCup2019_Optimized/mechanical design/World2019/ドリブラー板2mm.dxf
RoboCup2020/mechanical design/キッカー基板.dxf
RoboCup2022 SSL/Hardware2021/omni/top_1.5mm.dxf
RoboCup2019_Optimized/mechanical design/LEGEND 後期/オムニ54mm.dxf
RoboCup2019_Optimized/mechanical design/TomiXRMⅢ/キーパーオムニカバー後ろ.dxf
RoboCup2019_Optimized/mechanical design/モーター固定台8個.dxf
RoboCup2022 SSL/Hardware2021/omni/under_3mm.dxf
RoboCup2019_Optimized/mechanical design/TomiXRMⅢ/メイン基板.dxf
RoboCup2019_Optimized/mechanical design/World2019/UI基板.dxf
RoboCup2020/mechanical design/IR遮蔽NEW.dxf
RoboCup2022 SSL/Hardware2021_/omni/under_3mm.dxf
RoboCup2019_Optimized/mechanical design/TomiXRMⅢ/メイン基板固定.dxf
RoboCup2019_Optimized/mechanical design/World2019/GP2Y0A60SZLFカバー.dxf
RoboCup2019_Optimized/mechanical design/ラインセンサ基板.dxf
RoboCup2020/mechanical design/ABSセット.dxf
RoboCup2022 SSL/Hardware2021/omni/Omni54mm.dxf
RoboCup2022 SSL/Hardware2021_/omni/top_1.5mm.dxf
RoboCup2019_Optimized/mechanical design/IR遮蔽.dxf
RoboCup2019_Optimized/mechanical design/TomiXRMⅢ/4.22.切削.dxf
RoboCup2019_Optimized/mechanical design/World2019/Drawing1.dwg
RoboCup2022 SSL/Hardware2021_/omni/Omni54mm量産.dxf
RoboCup2019_Optimized/mechanical design/TomiXRMⅢ/スイッチ3つ.dxf
RoboCup2019_Optimized/mechanical design/World2019/LED RIng.dxf
RoboCup2019_Optimized/mechanical design/保護回路を保護するやつ.dxf
RoboCup2019_Optimized/mechanical design/LEGEND 後期/ボールセンサアダプタv2.dxf
RoboCup2019_Optimized/mechanical design/TomiXRMⅢ/ラインセンサ遮蔽(キーパー).dxf
RoboCup2019_Optimized/mechanical design/World2019/ボールセンサアダプタ.dxf
RoboCup2020/mechanical design/ハブ.dxf
RoboCup2019_Optimized/mechanical design/LEGEND 後期/キッカー板.dxf
RoboCup2019_Optimized/mechanical design/TomiXRMⅢ/ハンドル.dxf
RoboCup2019_Optimized/mechanical design/World2019/ドリブラーカバー.dxf
RoboCup2019_Optimized/mechanical design/背面カバー.dxf
RoboCup2019_Optimized/mechanical design/LEGEND 後期/三号機メイン基板.dxf
RoboCup2020/mechanical design/LineSensor_Cover.dxf
RoboCup2019_Optimized/mechanical design/LEGEND 後期/ハンドル.dxf
RoboCup2019_Optimized/mechanical design/TomiXRMⅢ/ドリブラの真ん中のプレート.dxf
RoboCup2019_Optimized/mechanical design/ball arrey.dxf
RoboCup2019_Optimized/mechanical design/LEGEND 後期/キッカーセット.dxf
RoboCup2019_Optimized/mechanical design/TomiXRMⅢ/キーパー3段目.dxf
RoboCup2020/mechanical design/DCX19 motor mount x4.dxf
RoboCup2019_Optimized/mechanical design/TomiXRMⅢ/ボールセンサ固定具.dxf
RoboCup2019_Optimized/mechanical design/World2019/キーパーIRセンサ取り付け部品.dxf
RoboCup2019_Optimized/mechanical design/ミラー固定台.dxf
RoboCup2019_Optimized/mechanical design/World2019/バッテリー天板.dxf
RoboCup2019_Optimized/mechanical design/ドリブラー 全国用 富岡.dwg
RoboCup2020/mechanical design/IR sensor cover.dxf
RoboCup2019_Optimized/mechanical design/LEGEND 後期/サブ基板.dxf
RoboCup2019_Optimized/mechanical design/TomiXRMⅢ/オムニガード.dxf
RoboCup2019_Optimized/mechanical design/World2019/3段目.dxf
RoboCup2020/mechanical design/omniWheel2.dxf
RoboCup2019_Optimized/mechanical design/LEGEND 後期/バッテリー天板2.dxf
RoboCup2019_Optimized/mechanical design/OpenMV 固定台1(アルミ).dxf
RoboCup2019_Optimized/mechanical design/TomiXRMⅢ/4段目UI.dxf
RoboCup2019_Optimized/mechanical design/World2019/ドリブラーあるミスティック.dxf
RoboCup2020/mechanical design/ER11.dxf.dxf
RoboCup2019_Optimized/mechanical design/LEGEND 後期/LEGEND_1_884435922_310ea031.sv$.dxf
RoboCup2019_Optimized/mechanical design/TomiXRMⅢ/3号機ボールセンサアダプタ.dxf
RoboCup2019_Optimized/mechanical design/World2019/3号機十字World_1_1053150250_14f99506.sv$.dxf
RoboCup2019_Optimized/mechanical design/フォトセンサ新作.dxf
RoboCup2020/mechanical design/NEWペットボトルカメラ.dxf
RoboCup2019_Optimized/mechanical design/LEGEND 後期/電源基板.dxf
RoboCup2019_Optimized/mechanical design/TomiXRMⅢ/3号機3段目.dxf
RoboCup2019_Optimized/mechanical design/LEGEND 後期/メイン基板1.dxf
RoboCup2019_Optimized/mechanical design/TomiXRMⅢ/ドリブラ切削.dxf
RoboCup2019_Optimized/mechanical design/LEGEND 後期/ラインセンサ基板.dxf
RoboCup2019_Optimized/mechanical design/omuni wheel 富岡.dwg
RoboCup2019_Optimized/mechanical design/Battery Cover2.dxf
RoboCup2019_Optimized/mechanical design/DCX16固定台.dxf
RoboCup2019_Optimized/mechanical design/DCXアダプタ.dxf
RoboCup2019_Optimized/mechanical design/G2モタドラ固定台.dxf
RoboCup2019_Optimized/mechanical design/LEGEND 後期/irセンサ基板.dxf
RoboCup2019_Optimized/mechanical design/LEGEND.dwg
RoboCup2019_Optimized/mechanical design/LEGEND.dxf
RoboCup2019_Optimized/mechanical design/LEGEND2018 2段目no.dxf
RoboCup2019_Optimized/mechanical design/OpenMV 固定台2(アルミ).dxf
RoboCup2019_Optimized/mechanical design/RCW-0001.dxf
RoboCup2019_Optimized/mechanical design/RCW0001の筒カバー.dxf
RoboCup2019_Optimized/mechanical design/SSD1306.dxf
RoboCup2019_Optimized/mechanical design/TomiXRMⅢ/3号機オムニバンパー.dxf
RoboCup2019_Optimized/mechanical design/TomiXRMⅢ/4段目(輪っか).dxf
RoboCup2019_Optimized/mechanical design/TomiXRMⅢ/4段目.dxf
RoboCup2019_Optimized/mechanical design/TomiXRMⅢ/52mm用モーター固定台.dxf
RoboCup2019_Optimized/mechanical design/TomiXRMⅢ/Angelラインセンサカバー.dxf
RoboCup2019_Optimized/mechanical design/TomiXRMⅢ/カメラ 台.dxf
RoboCup2019_Optimized/mechanical design/TomiXRMⅢ/カメラ台.dxf
RoboCup2019_Optimized/mechanical design/TomiXRMⅢ/キッカー基板.dxf
RoboCup2019_Optimized/mechanical design/TomiXRMⅢ/キッカー板.dxf
RoboCup2019_Optimized/mechanical design/TomiXRMⅢ/キーパー1.dxf
RoboCup2019_Optimized/mechanical design/TomiXRMⅢ/キーパー3.dxf
RoboCup2019_Optimized/mechanical design/TomiXRMⅢ/キーパーオムニカバー.dxf
RoboCup2019_Optimized/mechanical design/TomiXRMⅢ/キーパーバッテリーカバー.dxf
RoboCup2019_Optimized/mechanical design/TomiXRMⅢ/ドリブラ完全版1.dxf
RoboCup2019_Optimized/mechanical design/TomiXRMⅢ/バッテリーの台.dxf
RoboCup2019_Optimized/mechanical design/TomiXRMⅢ/ラインセンサ小中.dxf
RoboCup2019_Optimized/mechanical design/TomiXRMⅢ/保護回路を乗せるためのパーツ.dxf
RoboCup2019_Optimized/mechanical design/World2019/UIcircuit.dwg
RoboCup2019_Optimized/mechanical design/ゆう.dxf
RoboCup2019_Optimized/mechanical design/オムに.dxf
RoboCup2019_Optimized/mechanical design/オムニ2.dwg
RoboCup2019_Optimized/mechanical design/オムニ52mm.dxf
RoboCup2019_Optimized/mechanical design/オムニ52mm4輪分.dxf
RoboCup2019_Optimized/mechanical design/オムニホイール (3x12).dxf
RoboCup2019_Optimized/mechanical design/オムニホイールハブ.dxf
RoboCup2019_Optimized/mechanical design/オムニホイールハブ2個.dxf
RoboCup2019_Optimized/mechanical design/オムニホイール片面15個.dxf
RoboCup2019_Optimized/mechanical design/オムニ比較.dxf
RoboCup2019_Optimized/mechanical design/カメラのキャップ.dxf
RoboCup2019_Optimized/mechanical design/サイドホイール縦にいっぱい.dxf
RoboCup2019_Optimized/mechanical design/サブ基板.dwg
RoboCup2019_Optimized/mechanical design/サブ基板.dxf
RoboCup2019_Optimized/mechanical design/ソレノイドの改造1.dxf
RoboCup2019_Optimized/mechanical design/ドリブラ-.dxf
RoboCup2019_Optimized/mechanical design/ドリブラ.dxf
RoboCup2019_Optimized/mechanical design/ドリブラ2019.dxf
RoboCup2019_Optimized/mechanical design/ドリブラー_バレル1.dwg
RoboCup2019_Optimized/mechanical design/ハブ52mm用.dxf
RoboCup2019_Optimized/mechanical design/ハブのジグ.dxf
RoboCup2019_Optimized/mechanical design/ハンドル＋カメラの台.dxf
RoboCup2019_Optimized/mechanical design/バッテリー天板.dxf
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
