TomiXRM/LEGEND_RCJ/RoboCup2022 SSL/Hardware2021_/omni/工作センター/8:2/ピニオンギア.pdf

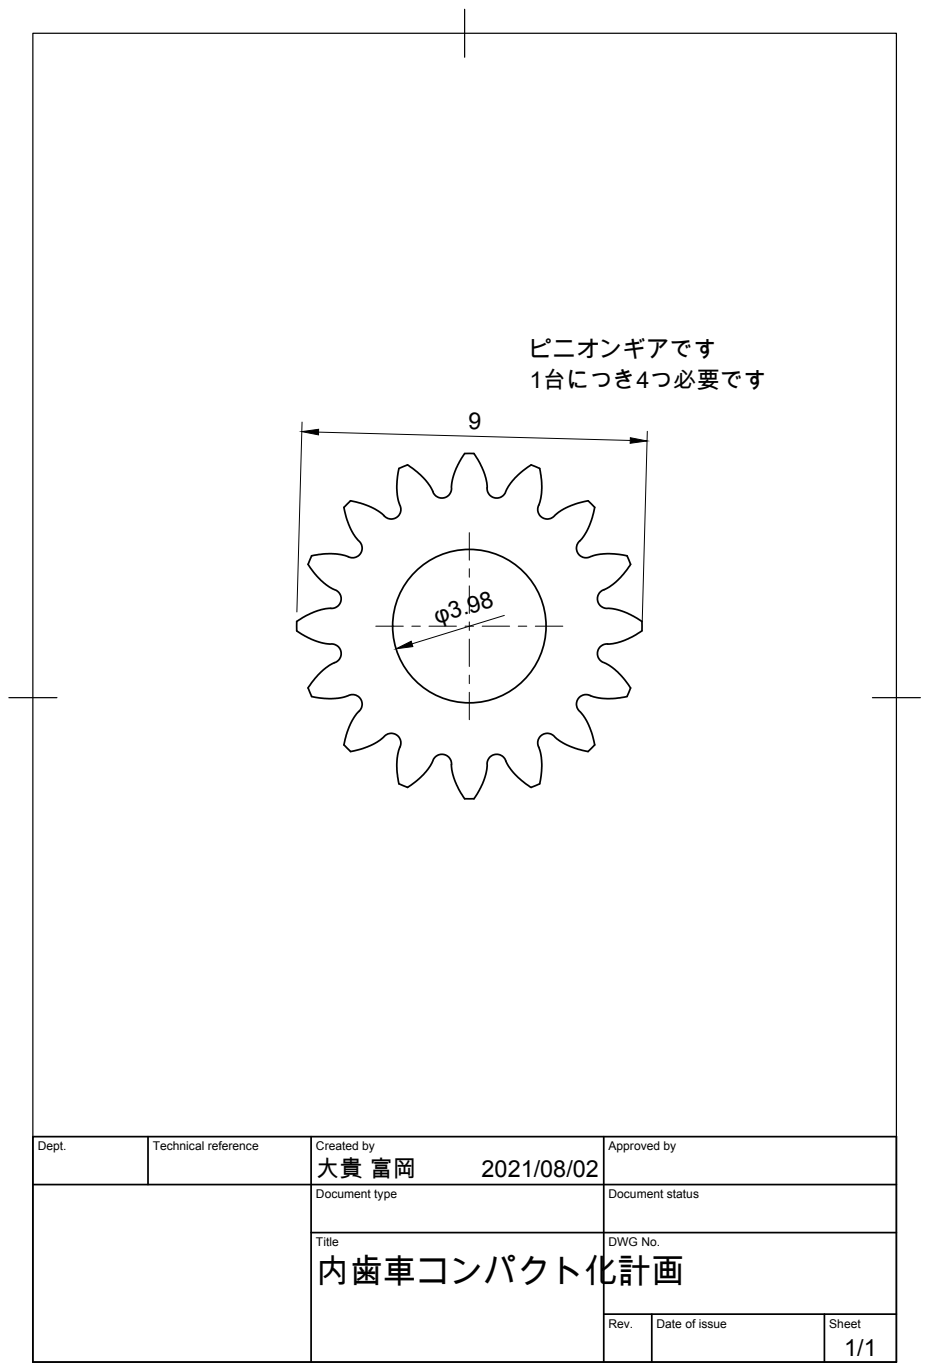
[picture p66: page 1]

Dept. | Technical reference | Created by 大貴 富岡 2021/08/02 | Approved by

Document type | Document status

Title 内歯車コンパクト化計画 | DWG No.

Rev. | Date of issue | Sheet 1/1
