TomiXRM/LEGEND_RCJ/RoboCup-LEGEND2021/circuit/MD/MD.brd

## EAGLE design RoboCup-LEGEND2021/circuit/MD/MD.brd (2023-12-11)

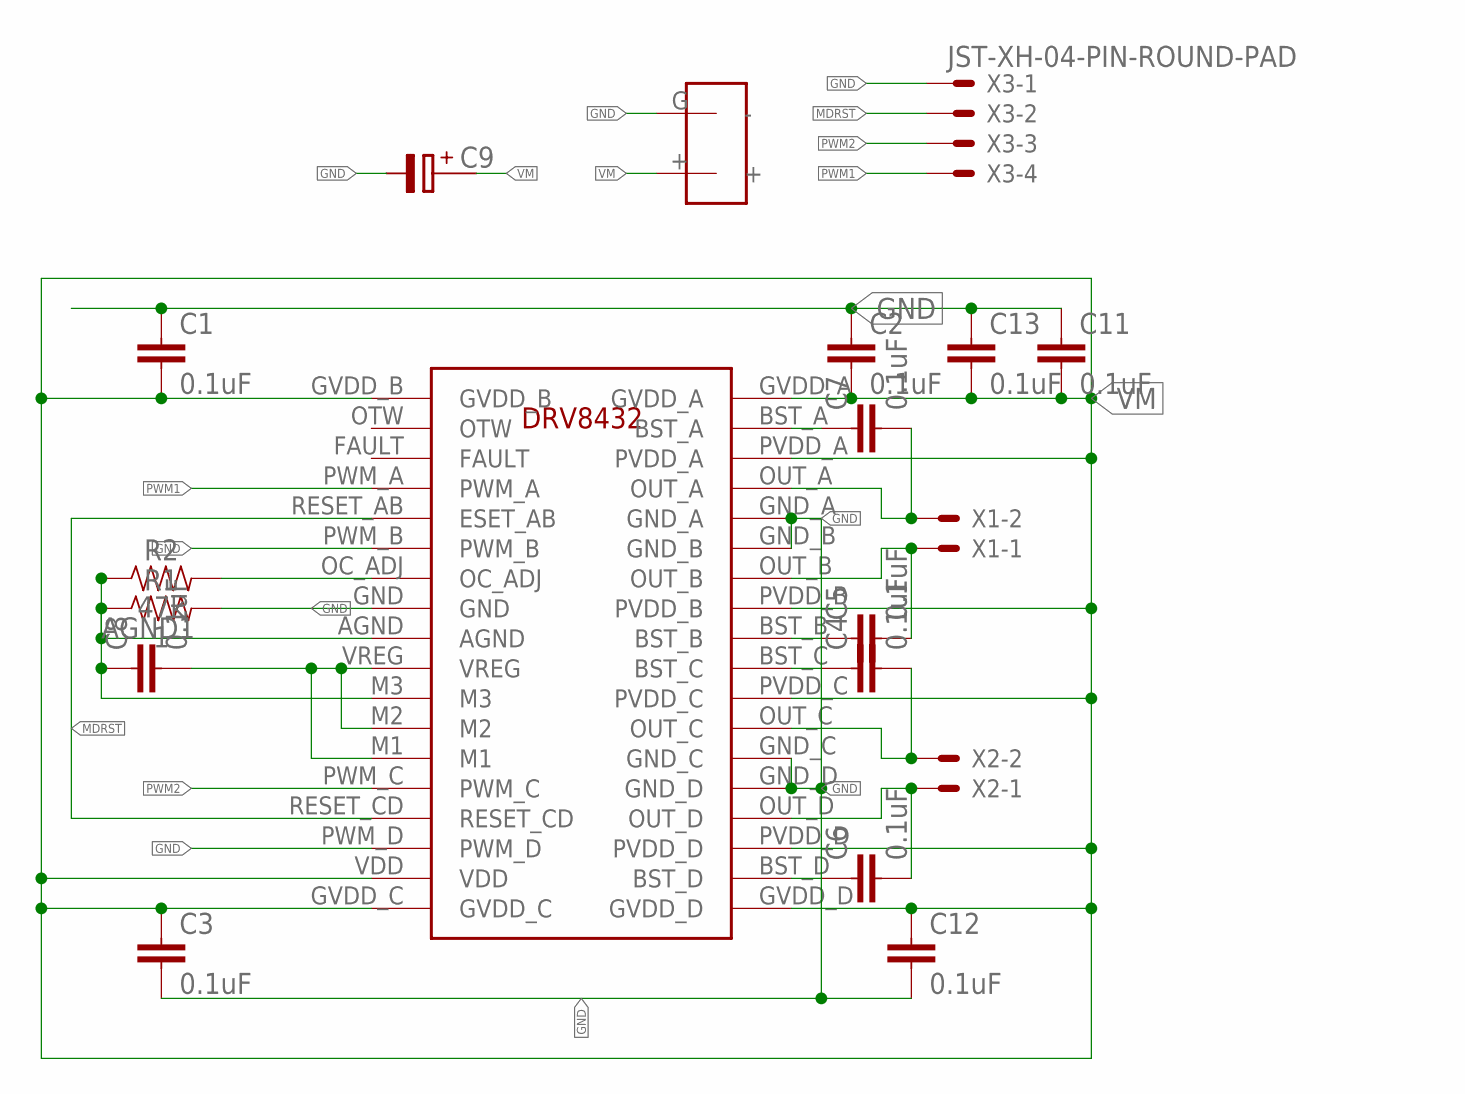
[picture p68: schematic MD.sch]

Parts:
C1, C2, C3, C4, C5, C6, C7, C8, C11, C12, C13: 0.1uF; 0603
C9: C-PR-3,5X8; E3,5-8
R1: 1; 0603
R2: 47k; 0603
U$1: DRV8432DKDR; HSSOP-36
U$2: BAT
X1, X2: JST-XH-02-PIN-LONG-PAD; JST-XH-02-PACKAGE-LONG-PAD
X3: JST-XH-04-PIN-ROUND-PAD; JST-XH-04-PACKAGE-ROUND-PAD

Connections:
AGND1: C8.1, R1.1, R2.1, U$1.AGND, U$1.M3
GND: C1.1, C2.1, C3.2, C9.-, C11.1, C12.2, C13.1, R1.2, U$1.GND, U$1.GND_A, U$1.GND_B, U$1.GND_C, U$1.GND_D, U$1.PWM_B, U$1.PWM_D, U$2.G (-), X3.1
M1_1: C7.2, U$1.OUT_A, X1.2
M1_2: C5.2, U$1.OUT_B, X1.1
M2_1: C4.2, U$1.OUT_C, X2.2
M2_2: C6.2, U$1.OUT_D, X2.1
MDRST: U$1.RESET_AB (ESET_AB), U$1.RESET_CD, X3.2
unnamed: C6.1, U$1.BST_D
unnamed: C4.1, U$1.BST_C
unnamed: C5.1, U$1.BST_B
unnamed: C7.1, U$1.BST_A
unnamed: R2.2, U$1.OC_ADJ
PWM1: U$1.PWM_A, X3.4
PWM2: U$1.PWM_C, X3.3
VM: C1.2, C2.2, C3.1, C9.+, C11.2, C12.1, C13.2, U$1.GVDD_A, U$1.GVDD_B, U$1.GVDD_C, U$1.GVDD_D, U$1.PVDD_A, U$1.PVDD_B, U$1.PVDD_C, U$1.PVDD_D, U$1.VDD, U$2.+
VREG1: C8.2, U$1.M1, U$1.M2, U$1.VREG

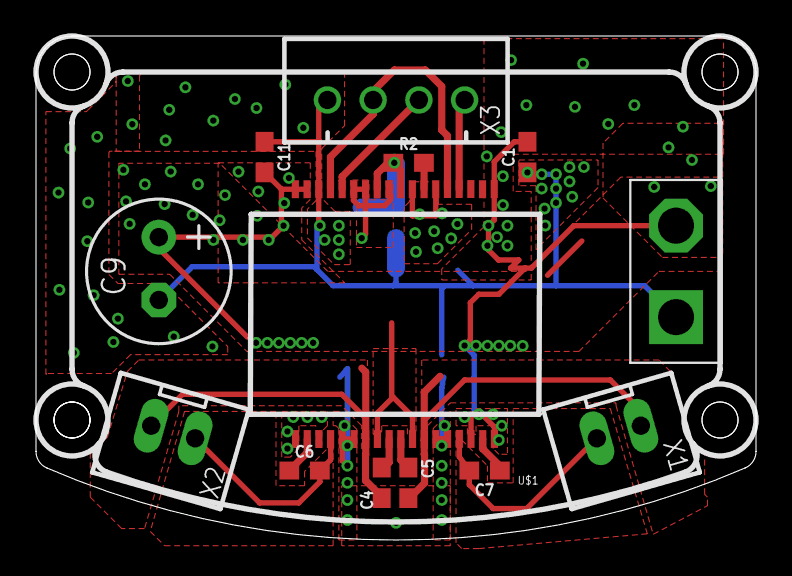
[picture p69: board MD.brd from above]

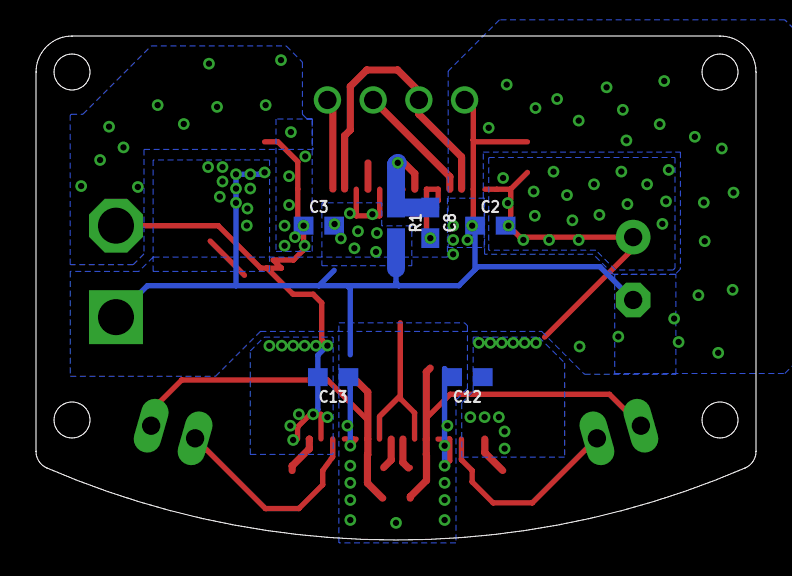
[picture p70: board MD.brd from below]

Board: 2 copper layers, 40.0 x 28.0 mm, 19 parts (6 on the bottom side), 16 nets.
