TomiXRM/LEGEND_RCJ/RoboCup-LEGEND2021/circuit/KickerBoost/KickerBoost.brd

## EAGLE design RoboCup-LEGEND2021/circuit/KickerBoost/KickerBoost.brd (2023-12-11)

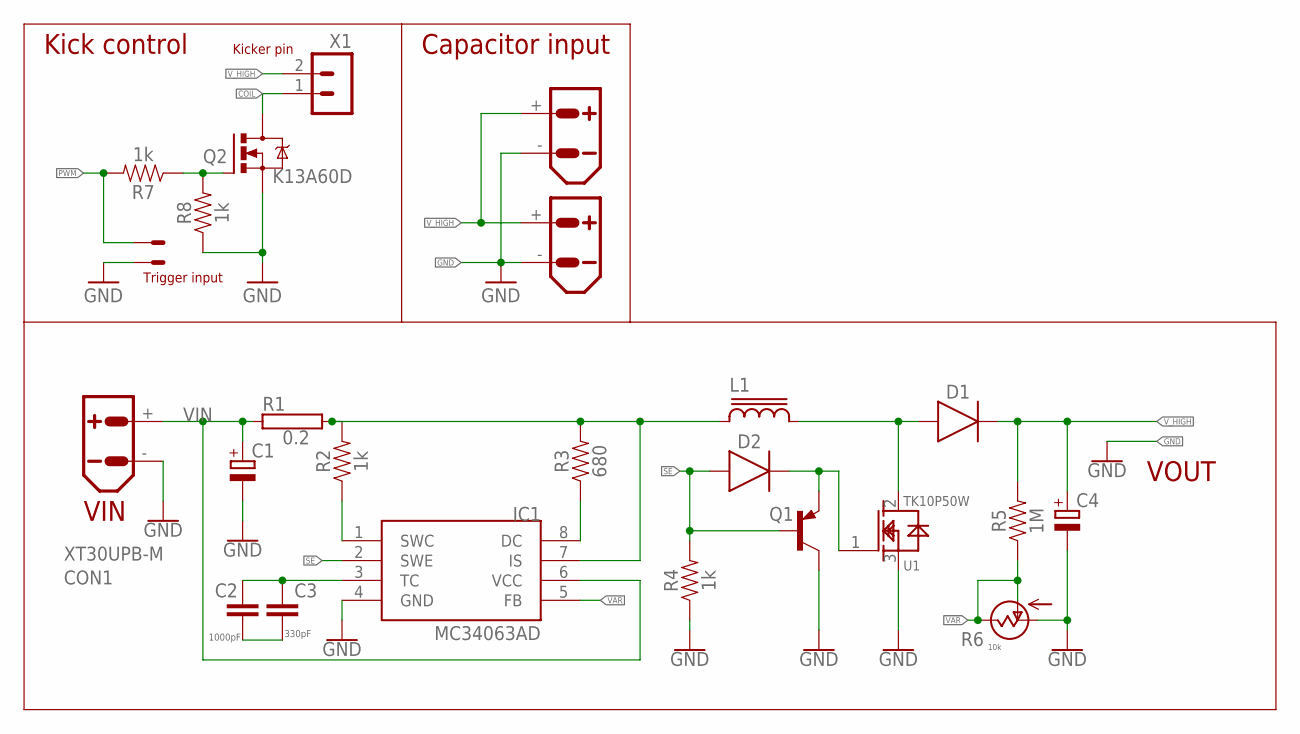
[picture p71: schematic KickerBoost.sch]

Parts:
C1: CPOL-EUE5-8.5; E5-8,5
C2: 1000pF; 0603
C3: 330pF; 0603
C4: CPOL-EUE5-10.5; E5-10,5
CON1, CON4, CON5: XT30UPB-M
D1, D2: MRA4007T3G; DIOM5226X290N
IC1: MC34063AD; SOIC8
L1: CDRH127/LD
Q1: BCX71SMD; SOT23
Q2: K13A60D; TO220BV
R1: 0.2; KH208-8
R2, R4, R7, R8: 1k; 0603
R3: 680; 0603
R5: 1M; 0603
R6: 10K; S64W
U1: TK10P50W
X1: VH2; B2P-VH-FB-B
X2: HX2; JST-XH-02-PACKAGE-LONG-PAD

Connections:
COIL: Q2.D, X1.1
GND: C1.-, C4.-, CON1.-, CON4.-, CON5.-, IC1.4 (GND), Q1.3 (C), Q2.S, R4.1, R6.A (VDD), R8.1, U1.3 (SOURCE), X2.2
unnamed: C2.2, C3.2
unnamed: Q2.G, R7.1, R8.2
unnamed: D2.1 (C), Q1.2 (E), U1.1 (GATE)
unnamed: C2.1, C3.1, IC1.3 (TC)
unnamed: IC1.1 (SWC), R2.1
unnamed: IC1.8 (DC), R3.1
PWM: R7.2, X2.1
SE: D2.2 (A), IC1.2 (SWE), Q1.1 (B), R4.2
V$4: IC1.7 (IS), L1.1, R1.2, R2.2, R3.2
V$5: D1.2 (A), L1.2, U1.2 (DRAIN)
VAR: IC1.5 (FB), R5.1, R6.E (VSS), R6.S (OUT)
VIN: C1.+, CON1.+, IC1.6 (VCC), R1.1
V_HIGH: C4.+, CON4.+, CON5.+, D1.1 (C), R5.2, X1.2

Notes on the sheet:
10k
Kicker pin
VIN
VOUT
Capacitor input
Kick control
Trigger input

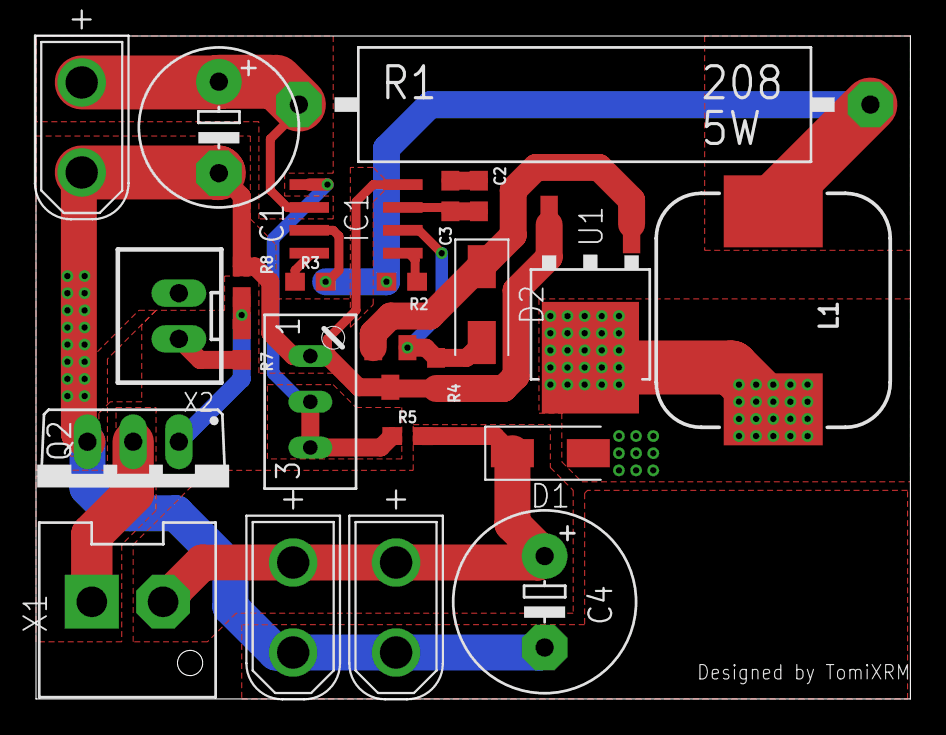
[picture p72: board KickerBoost.brd from above]

Board: 2 copper layers, 48.6 x 36.8 mm, 24 parts (0 on the bottom side), 15 nets.
