TomiXRM/LEGEND_RCJ/RoboCup-LEGEND2021/circuit/LEGEND2022/main.brd

## EAGLE design RoboCup-LEGEND2021/circuit/LEGEND2022/main.brd (2023-12-11)

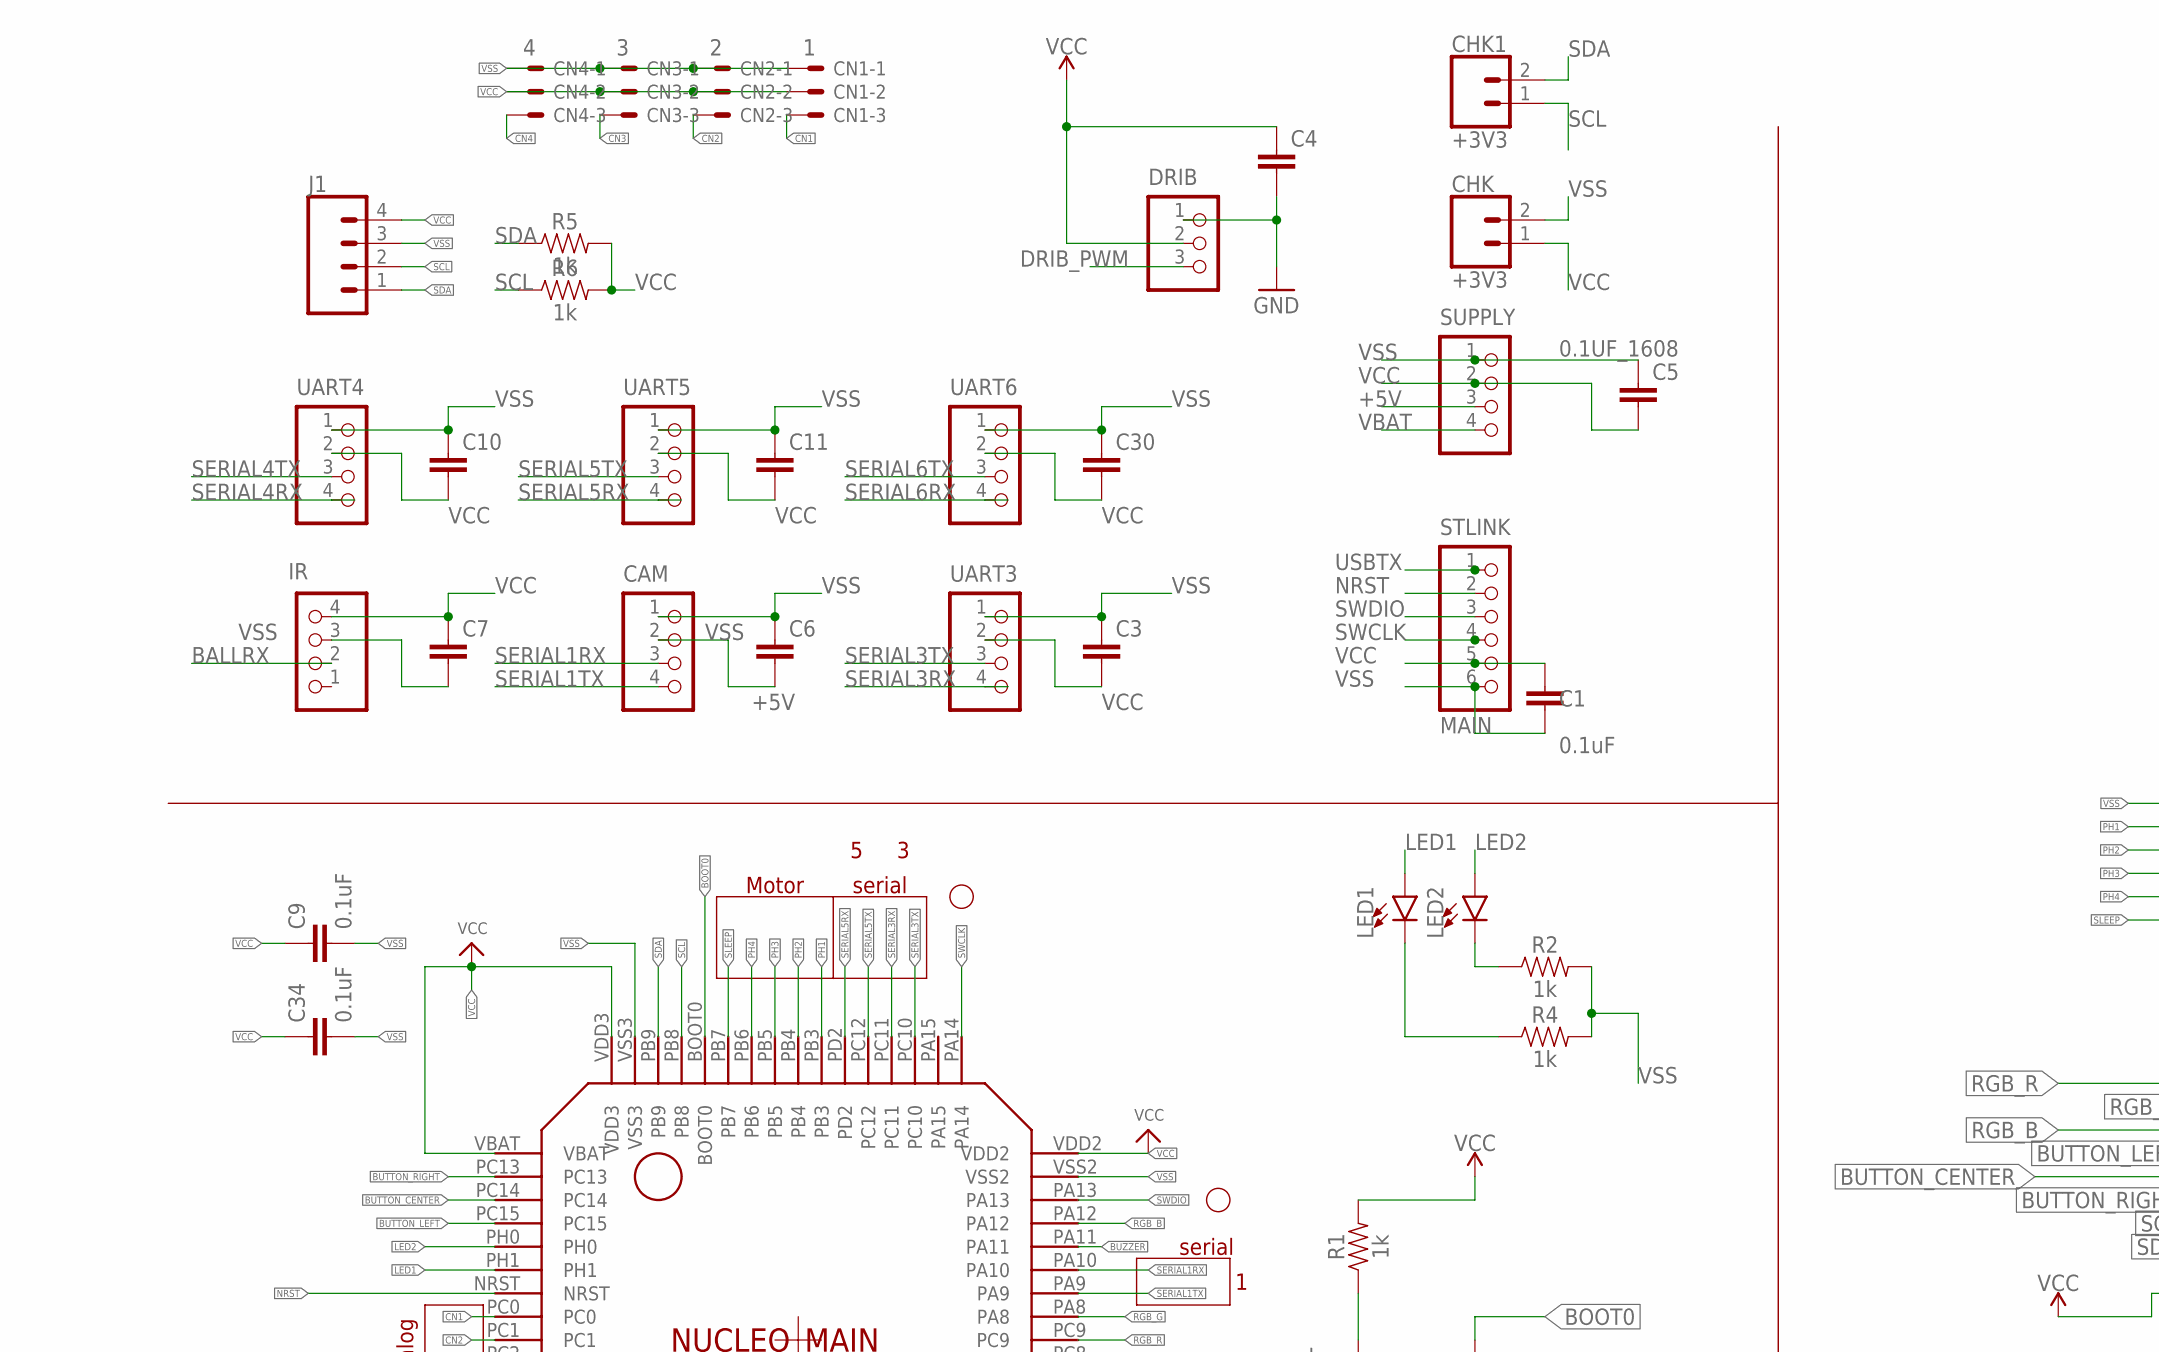
[picture p73: schematic main.sch, part in row 1, column 1]

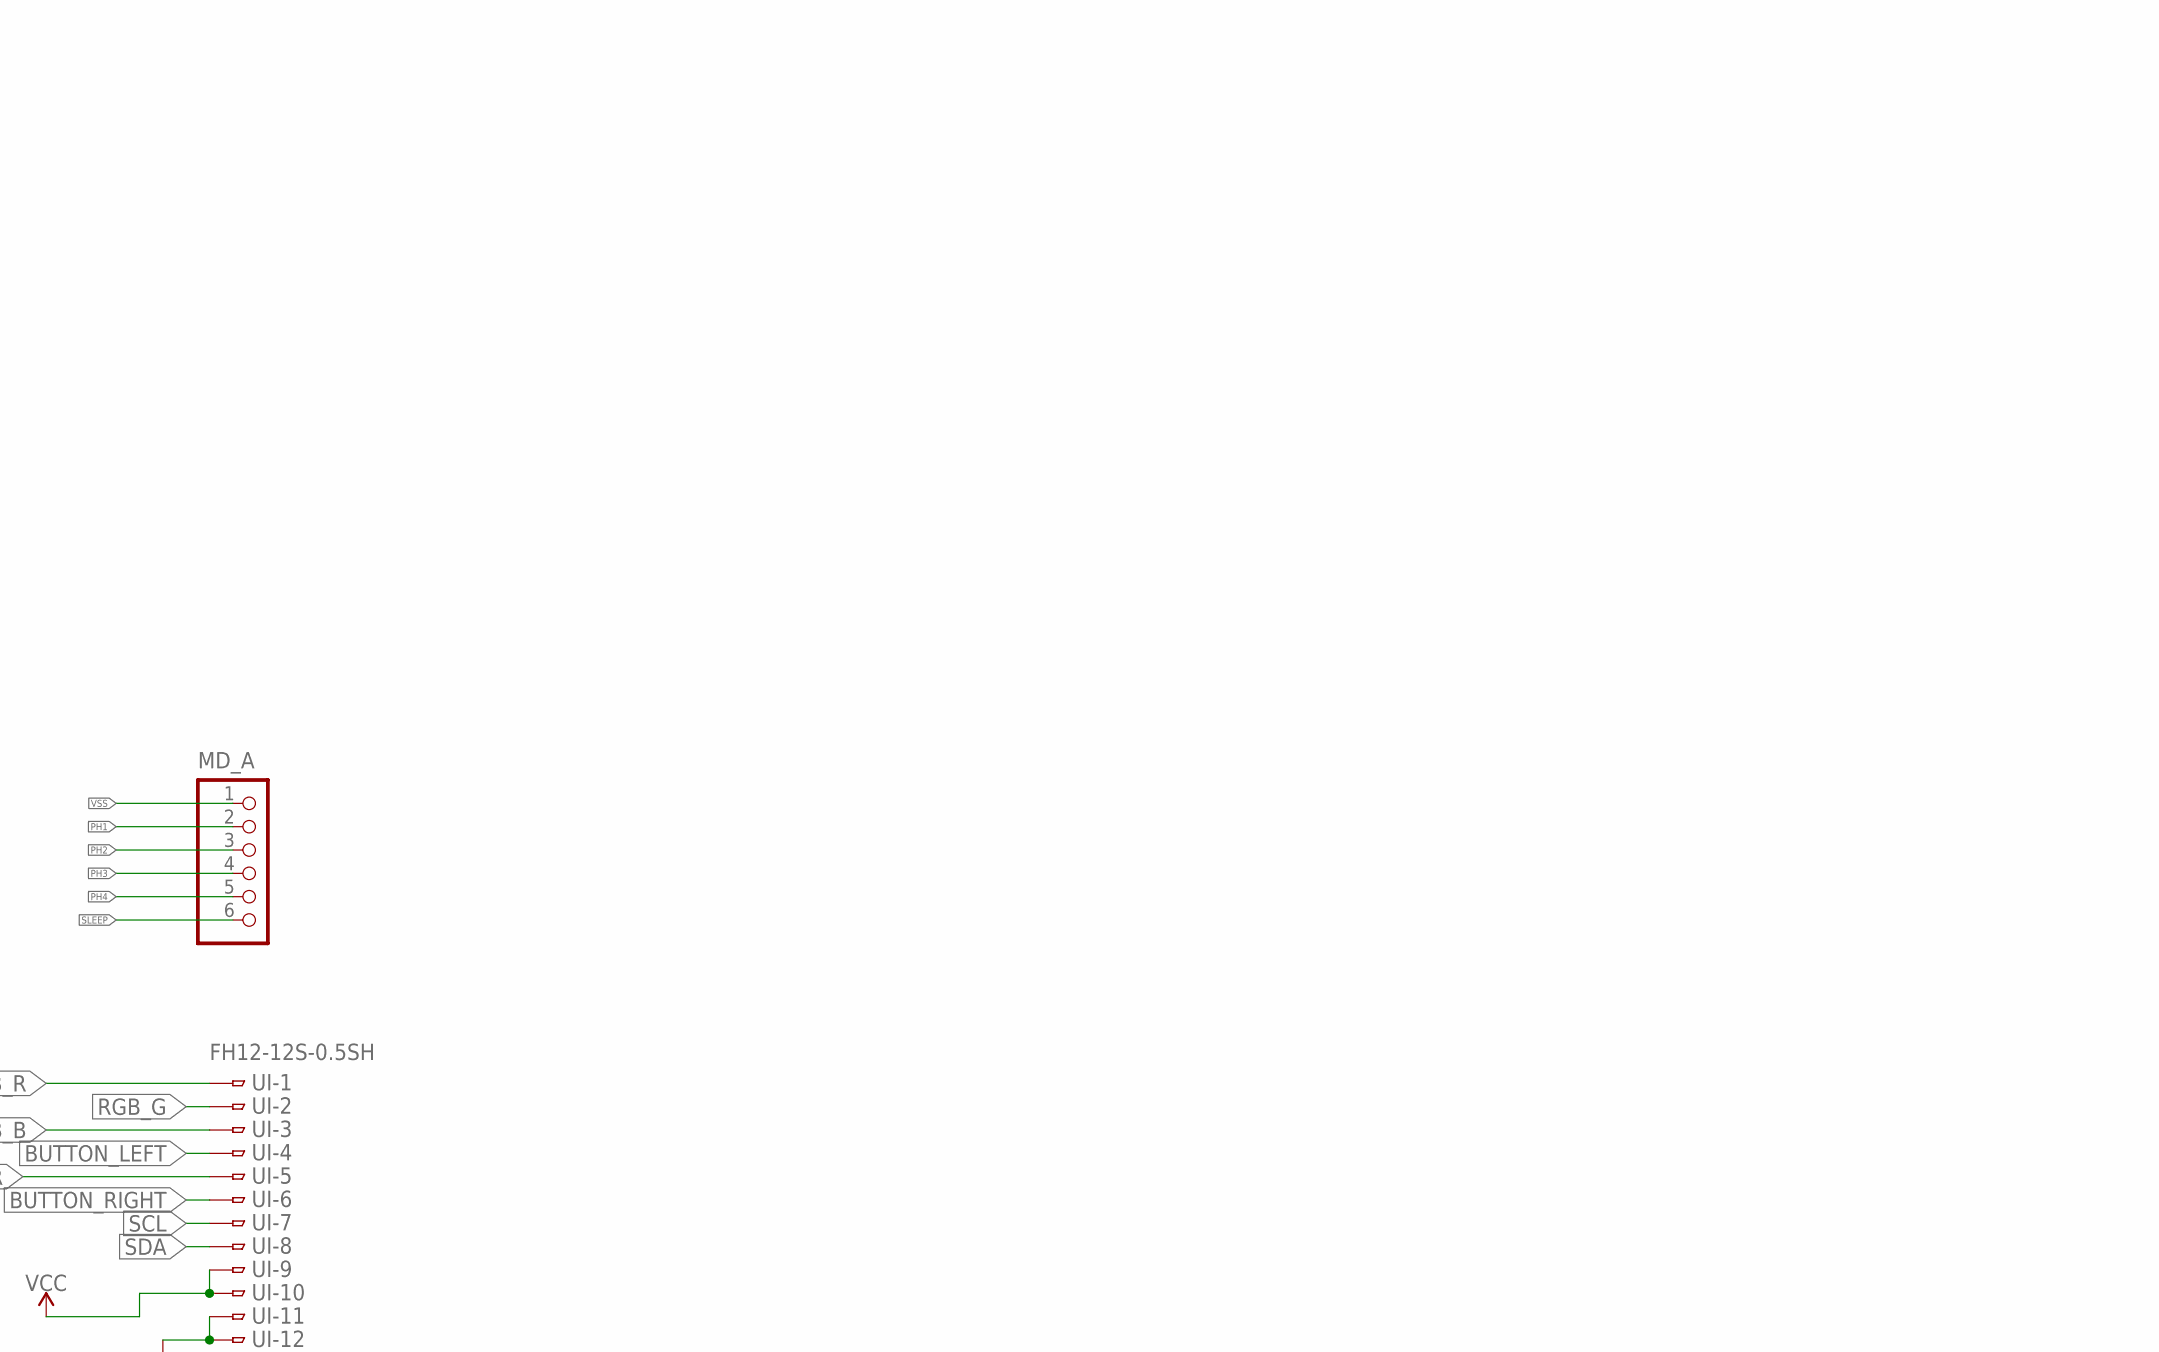
[picture p74: schematic main.sch, part in row 1, column 2]

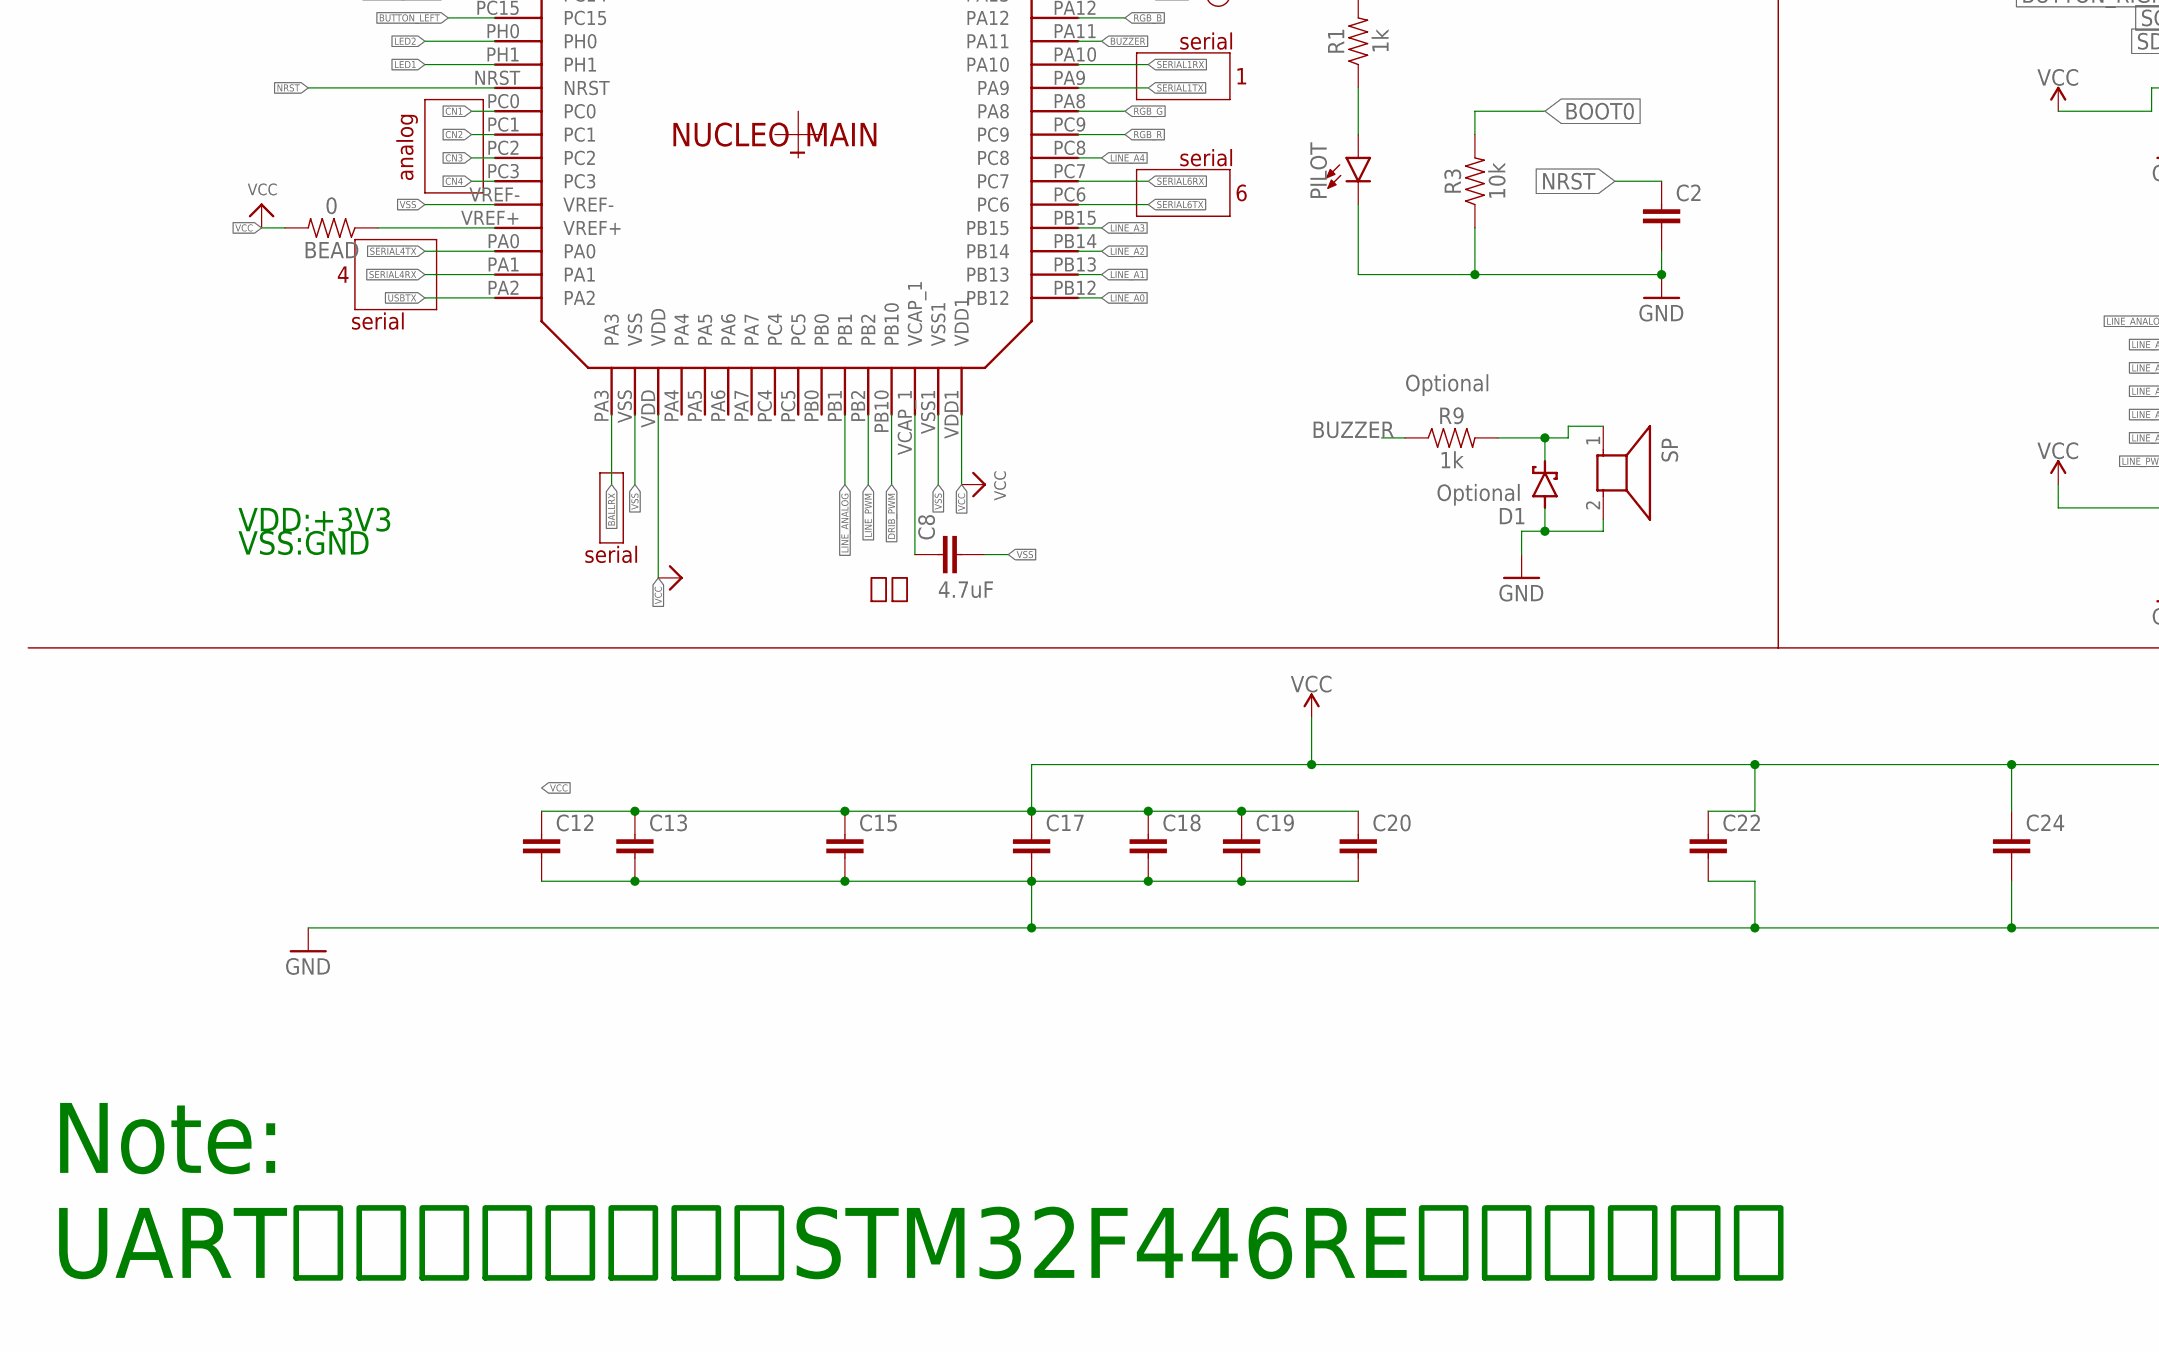
[picture p75: schematic main.sch, part in row 2, column 1]

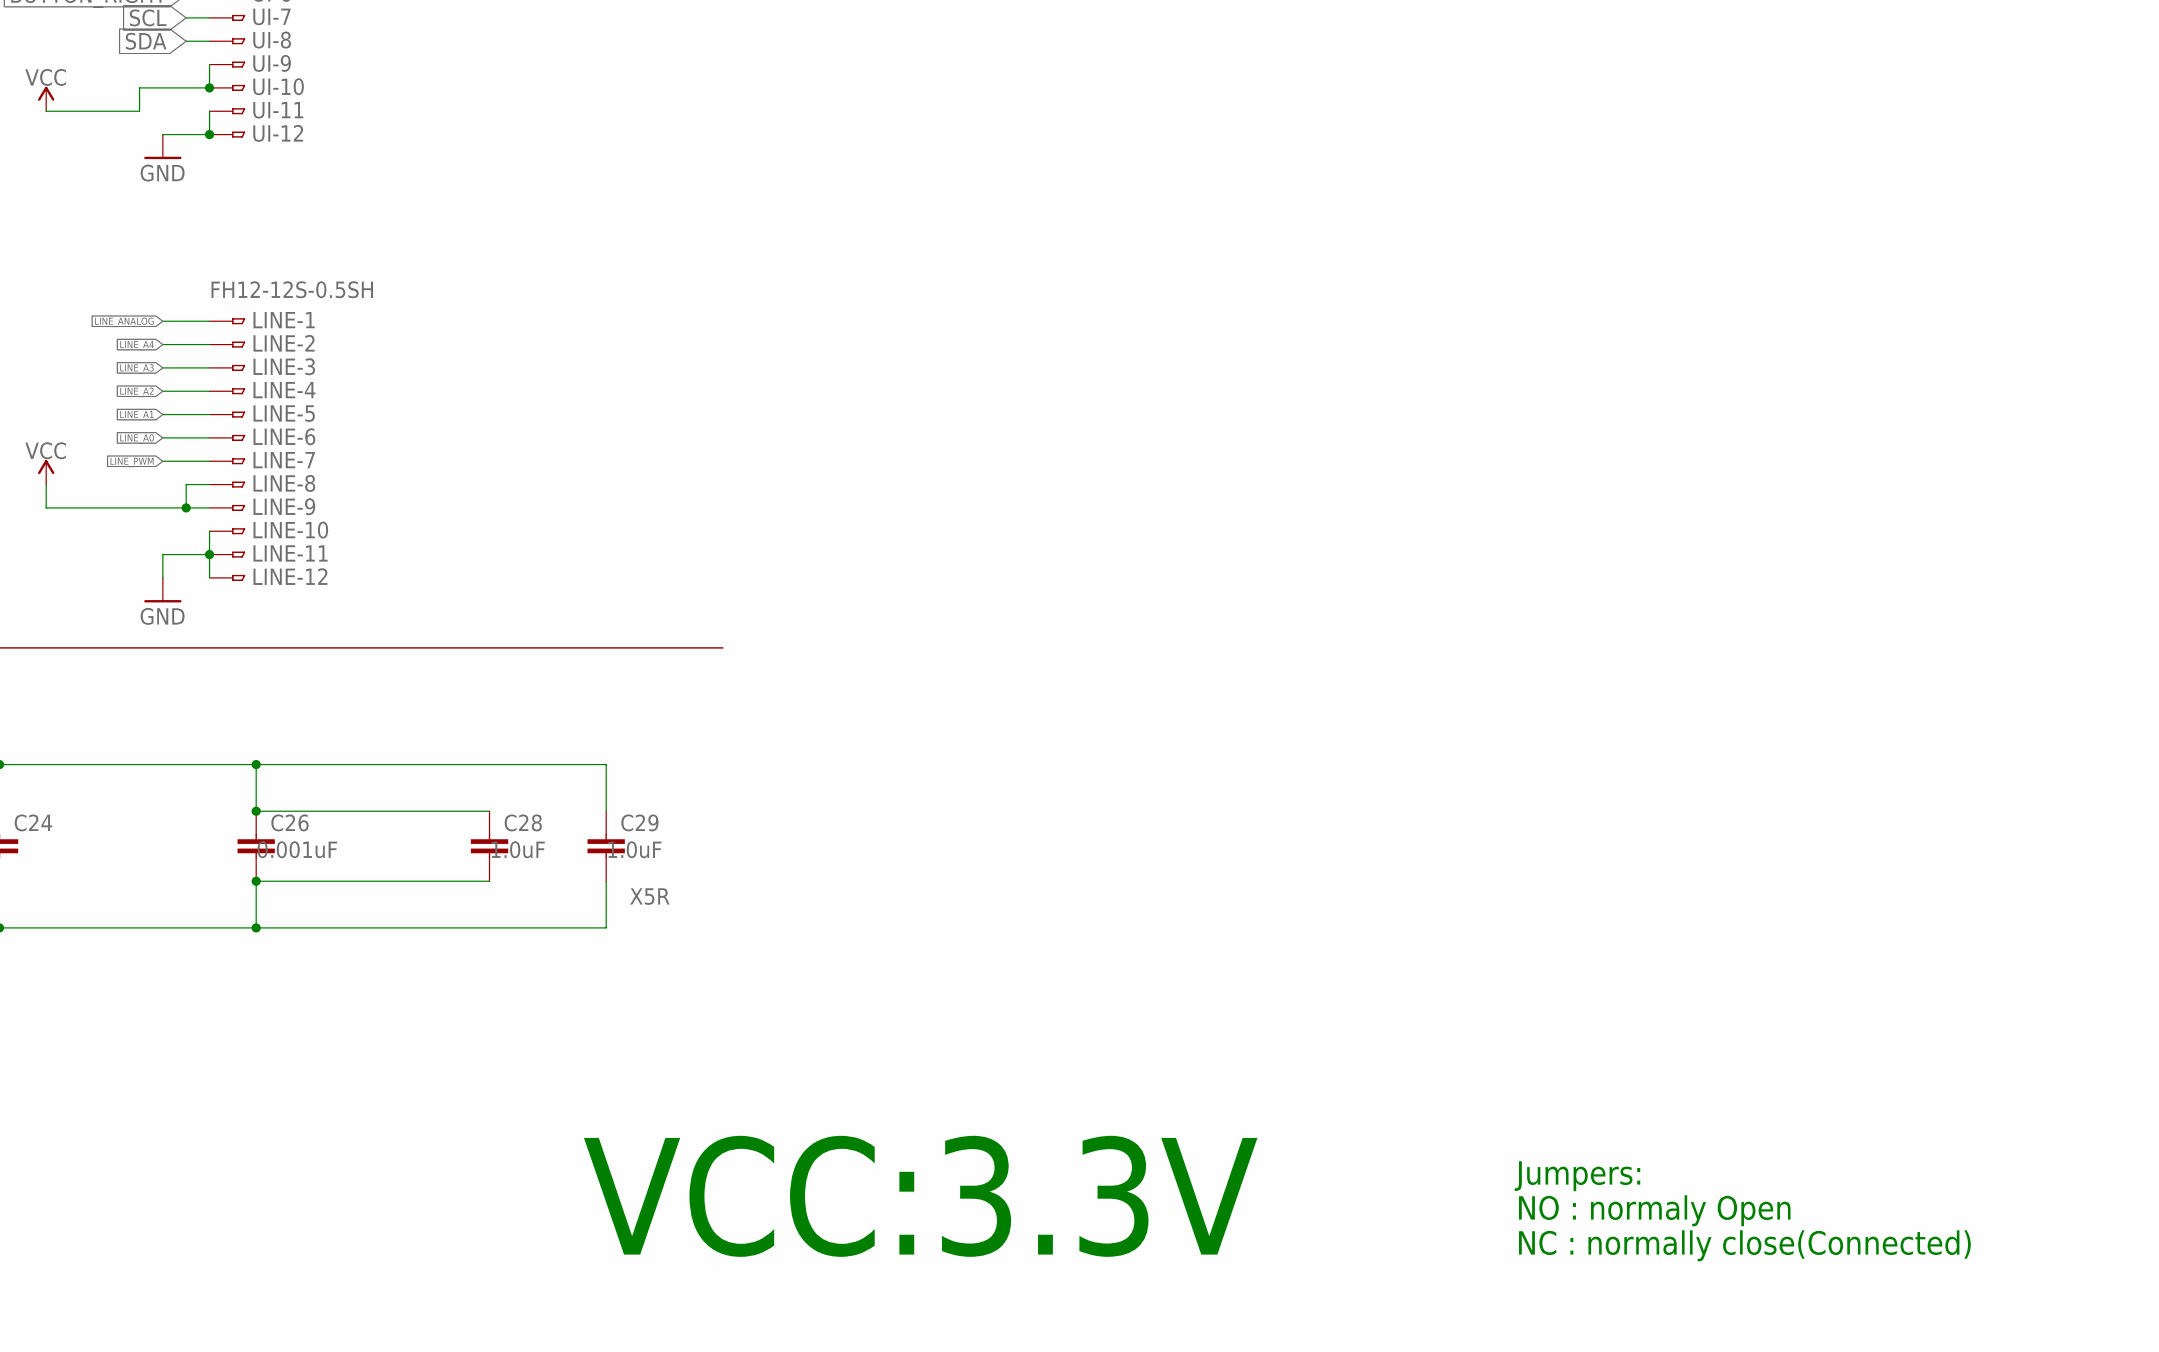
[picture p76: schematic main.sch, part in row 2, column 2]

Parts:
BEAD: 0; 0603
C1: 0.1uF; 1608
C2, C3, C4, C5, C6, C7, C10, C11, C12, C13, C15, C17, C18, C19, C20, C22, C24, C30: 0.1UF_1608; 1608
C8: 4.7uF; 0603
C9, C34: 0.1uF; 0603
C26: 0.001UF_1608; 1608
C28, C29: 1.0UF_1608; 1608
CAM: cam; B4B-XH-A
CHK, CHK1: +3V3; 1X02
CN1: 1; JST-XH-03-PACKAGE-LONG-PAD
CN2: 2; JST-XH-03-PACKAGE-LONG-PAD
CN3: 3; JST-XH-03-PACKAGE-LONG-PAD
CN4: 4; JST-XH-03-PACKAGE-LONG-PAD
D1: DIODE-SS2040LFL; SOD123FL
DRIB: B3B-XH-A
IR: IR; B4B-XH-A
J1: CONN_04; 1X04
LED1, LED2: LED-SMD; LED-1206
LINE: FH12-12S-0.5SH
MD_A: B6B-XH-A
NUCLEO_MAIN: F446RET6; STM32F446RET6
PILOT: LED-SMD; LED-1206
R1, R2, R4, R5, R6, R9: 1k; R0603
R3: 10k; R0603
SP: PKLCS1212E4001
STLINK: MAIN; B6B-XH-A
SUPPLY: B4B-XH-A
UART3, UART4, UART5, UART6: IMU; B4B-XH-A
UI: FH12-12S-0.5SH

Connections:
+5V: C6.2, CAM.2, SUPPLY.3
BALLRX: IR.2, NUCLEO_MAIN.PA3
BOOT0: NUCLEO_MAIN.BOOT0, R3.2
BUTTON_CENTER: NUCLEO_MAIN.PC14, UI.5
BUTTON_LEFT: NUCLEO_MAIN.PC15, UI.4
BUTTON_RIGHT: NUCLEO_MAIN.PC13, UI.6
BUZZER: NUCLEO_MAIN.PA11, R9.1
CN1: CN1.3, NUCLEO_MAIN.PC0
CN2: CN2.3, NUCLEO_MAIN.PC1
CN3: CN3.3, NUCLEO_MAIN.PC2
CN4: CN4.3, NUCLEO_MAIN.PC3
DRIB_PWM: DRIB.3, NUCLEO_MAIN.PB10
LED1: LED1.A, NUCLEO_MAIN.PH1
LED2: LED2.A, NUCLEO_MAIN.PH0
LINE_A0: LINE.6, NUCLEO_MAIN.PB12
LINE_A1: LINE.5, NUCLEO_MAIN.PB13
LINE_A2: LINE.4, NUCLEO_MAIN.PB14
LINE_A3: LINE.3, NUCLEO_MAIN.PB15
LINE_A4: LINE.2, NUCLEO_MAIN.PC8
LINE_ANALOG: LINE.1, NUCLEO_MAIN.PB1
LINE_PWM: LINE.7, NUCLEO_MAIN.PB2
unnamed: LED2.C, R2.1
unnamed: LED1.C, R4.1
NRST: C2.1, NUCLEO_MAIN.NRST, STLINK.2
PH1: MD_A.2, NUCLEO_MAIN.PB3
PH2: MD_A.3, NUCLEO_MAIN.PB4
PH3: MD_A.4, NUCLEO_MAIN.PB5
PH4: MD_A.5, NUCLEO_MAIN.PB6
POWERLED_RESISTOR: PILOT.A, R1.1
RGB_B: NUCLEO_MAIN.PA12, UI.3
RGB_G: NUCLEO_MAIN.PA8, UI.2
RGB_R: NUCLEO_MAIN.PC9, UI.1
SCL: CHK1.1, J1.2, NUCLEO_MAIN.PB8, R6.1, UI.7
SDA: CHK1.2, J1.1, NUCLEO_MAIN.PB9, R5.1, UI.8
SERIAL1RX: CAM.3, NUCLEO_MAIN.PA10
SERIAL1TX: CAM.4, NUCLEO_MAIN.PA9
SERIAL3RX: NUCLEO_MAIN.PC11, UART3.4
SERIAL3TX: NUCLEO_MAIN.PC10, UART3.3
SERIAL4RX: NUCLEO_MAIN.PA1, UART4.4
SERIAL4TX: NUCLEO_MAIN.PA0, UART4.3
SERIAL5RX: NUCLEO_MAIN.PD2, UART5.4
SERIAL5TX: NUCLEO_MAIN.PC12, UART5.3
SERIAL6RX: NUCLEO_MAIN.PC7, UART6.4
SERIAL6TX: NUCLEO_MAIN.PC6, UART6.3
SLEEP: MD_A.6, NUCLEO_MAIN.PB7
SP: D1.C, R9.2, SP.1
SWCLK: NUCLEO_MAIN.PA14, STLINK.4
SWDIO: NUCLEO_MAIN.PA13, STLINK.3
USBTX: NUCLEO_MAIN.PA2, STLINK.1
VBAT: SUPPLY.4
VCAP: C8.1, NUCLEO_MAIN.VCAP_1
VCC: BEAD.2, C1.1, C3.2, C4.1, C5.2, C7.1, C9.1, C10.2, C11.2, C12.1, C13.1, C15.1, C17.1, C18.1, C19.1, C20.1, C22.1, C24.1, C26.1, C28.1, C29.1, C30.2, C34.1, CHK.1, CN1.2, CN2.2, CN3.2, CN4.2, DRIB.2, IR.4, J1.4, LINE.8, LINE.9, NUCLEO_MAIN.VBAT, NUCLEO_MAIN.VDD, NUCLEO_MAIN.VDD1, NUCLEO_MAIN.VDD2, NUCLEO_MAIN.VDD3, R1.2, R5.2, R6.2, STLINK.5, SUPPLY.2, UART3.2, UART4.2, UART5.2, UART6.2, UI.9, UI.10
VDDA: BEAD.1, NUCLEO_MAIN.VREF+
VSS: C1.2, C2.2, C3.1, C4.2, C5.1, C6.1, C7.2, C8.2, C9.2, C10.1, C11.1, C12.2, C13.2, C15.2, C17.2, C18.2, C19.2, C20.2, C22.2, C24.2, C26.2, C28.2, C29.2, C30.1, C34.2, CAM.1, CHK.2, CN1.1, CN2.1, CN3.1, CN4.1, D1.A, DRIB.1, IR.3, J1.3, LINE.10, LINE.11, LINE.12, MD_A.1, NUCLEO_MAIN.VREF-, NUCLEO_MAIN.VSS, NUCLEO_MAIN.VSS1, NUCLEO_MAIN.VSS2, NUCLEO_MAIN.VSS3, PILOT.C, R2.2, R3.1, R4.2, SP.2, STLINK.6, SUPPLY.1, UART3.1, UART4.1, UART5.1, UART6.1, UI.11, UI.12

Notes on the sheet:
Note: UARTピンの名称は全てSTM32F446REからみた名称
VCC:3.3V
Jumpers: NO : normaly Open NC : normally close(Connected)
VDD:+3V3
VSS:GND
Motor
serial
analog

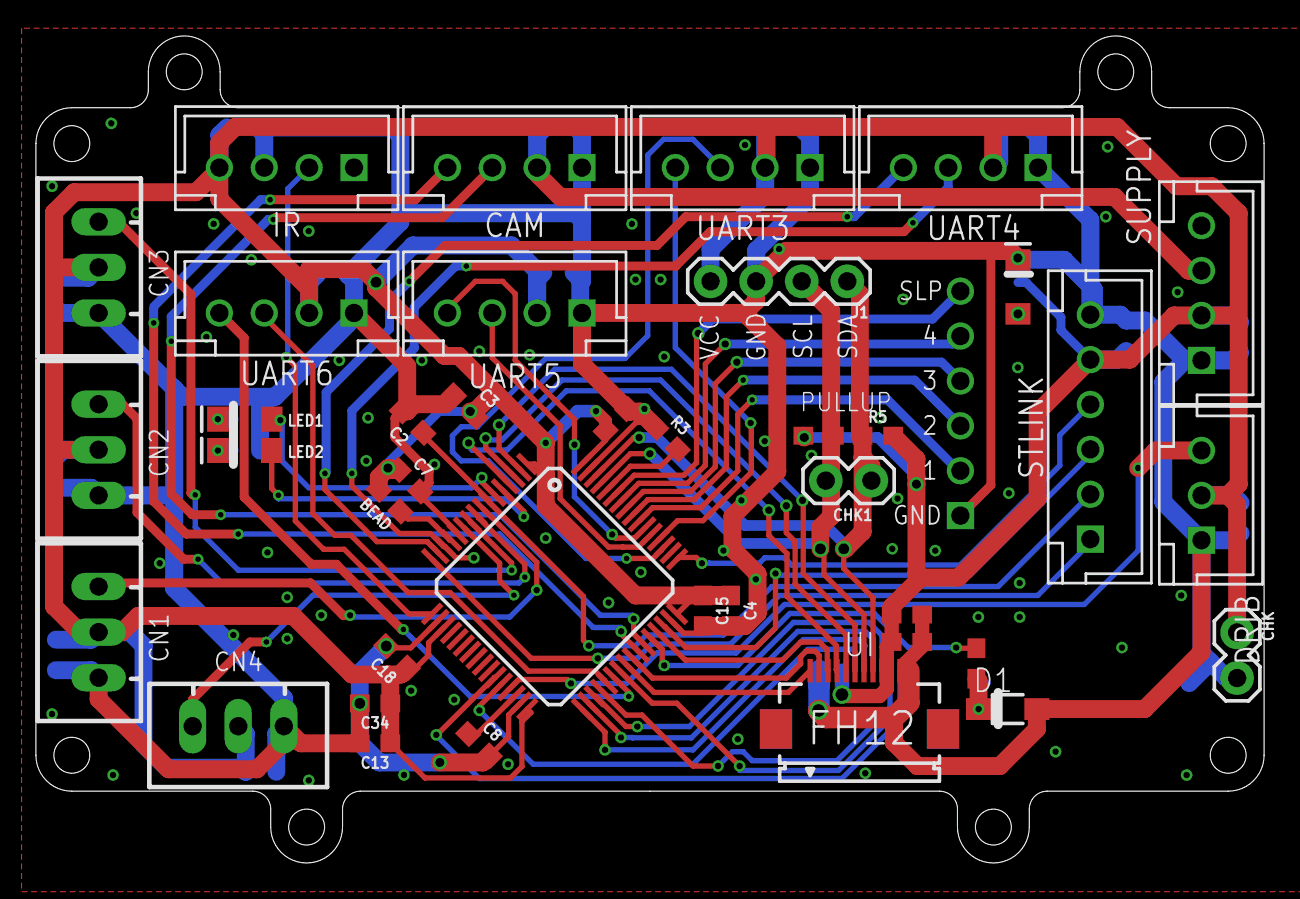
[picture p77: board main.brd from above]

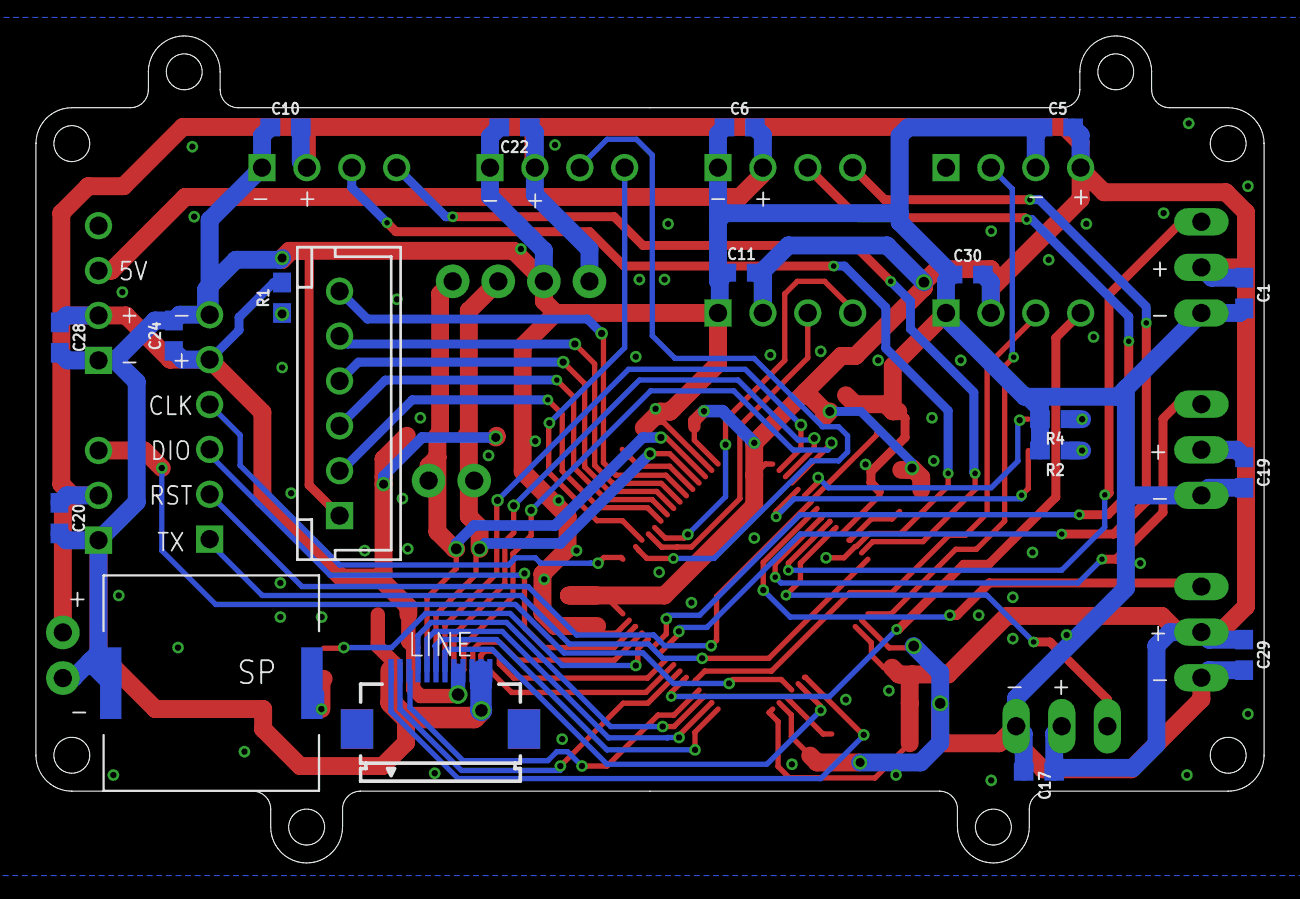
[picture p78: board main.brd from below]

Board: 2 copper layers, 68.4 x 46.1 mm, 58 parts (19 on the bottom side), 53 nets.
