TomiXRM/LEGEND_RCJ/RoboCup-LEGEND2021/circuit/MD/MDCluster.brd

## EAGLE design RoboCup-LEGEND2021/circuit/MD/MDCluster.brd (2023-12-11)

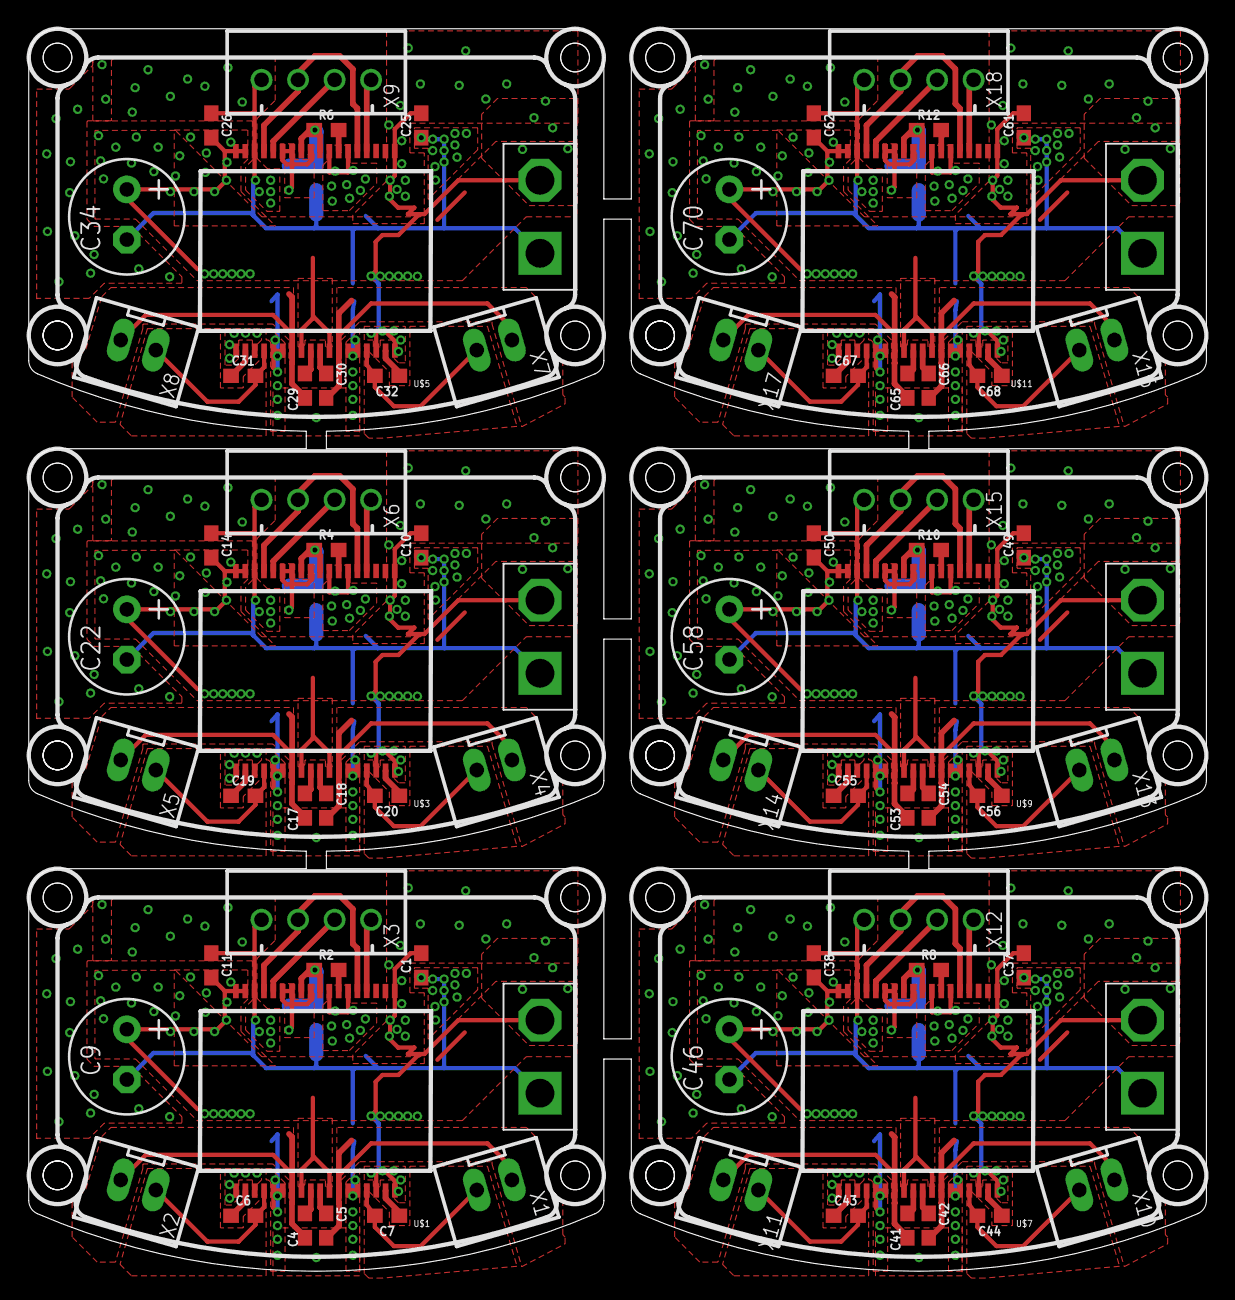
[picture p79: board MDCluster.brd from above]

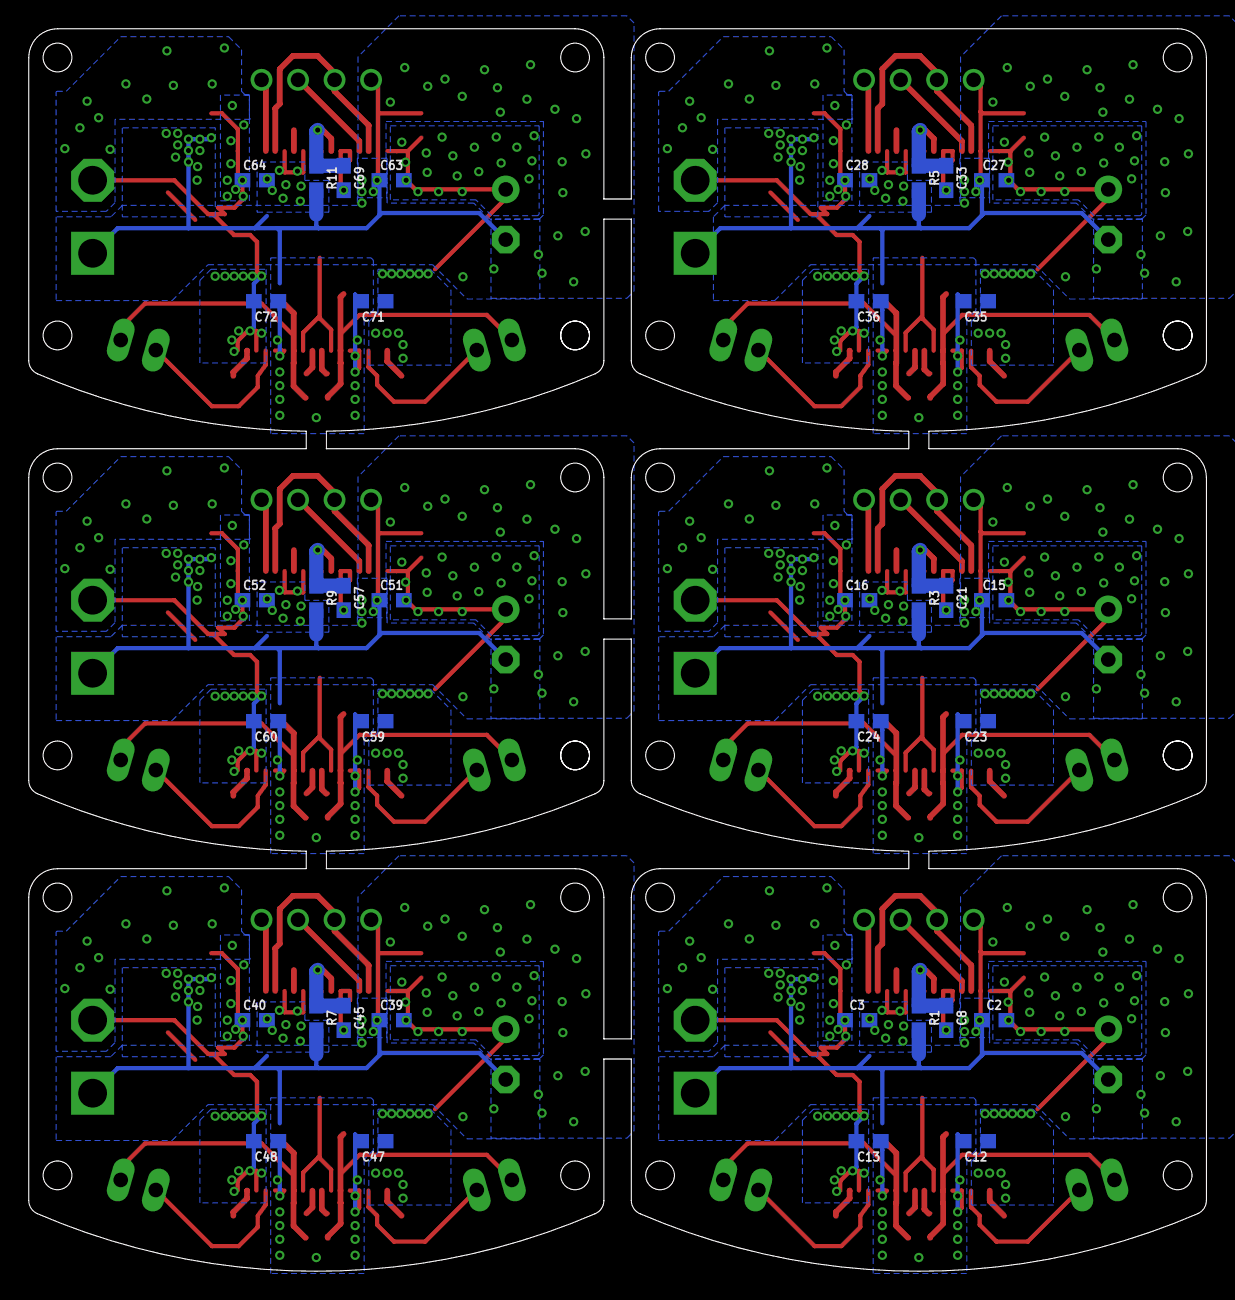
[picture p80: board MDCluster.brd from below]

Board: 2 copper layers, 81.9 x 86.4 mm, 114 parts (36 on the bottom side), 96 nets.

Parts:
C1, C2, C3, C4, C5, C6, C7, C8, C10, C11, C12, C13, C14, C15, C16, C17, C18, C19, C20, C21, C23, C24, C25, C26, C27, C28, C29, C30, C31, C32, C33, C35, C36, C37, C38, C39, C40, C41, C42, C43, C44, C45, C47, C48, C49, C50, C51, C52, C53, C54, C55, C56, C57, C59, C60, C61, C62, C63, C64, C65, C66, C67, C68, C69, C71, C72: 0.1uF; 0603
C9, C22, C34, C46, C58, C70: E3,5-8
R1, R3, R5, R7, R9, R11: 1; 0603
R2, R4, R6, R8, R10, R12: 47k; 0603
U$1, U$3, U$5, U$7, U$9, U$11: DRV8432DKDR; HSSOP-36
U$2, U$4, U$6, U$8, U$10, U$12: BAT
X1, X2, X4, X5, X7, X8, X10, X11, X13, X14, X16, X17: JST-XH-02-PIN-LONG-PAD; JST-XH-02-PACKAGE-LONG-PAD
X3, X6, X9, X12, X15, X18: JST-XH-04-PIN-ROUND-PAD; JST-XH-04-PACKAGE-ROUND-PAD

Connections:
AGND1: C8.1, R1.1, R2.1, U$1.AGND, U$1.M3
AGND2: C21.1, R3.1, R4.1, U$3.AGND, U$3.M3
AGND3: C33.1, R5.1, R6.1, U$5.AGND, U$5.M3
AGND4: C45.1, R7.1, R8.1, U$7.AGND, U$7.M3
AGND5: C57.1, R9.1, R10.1, U$9.AGND, U$9.M3
AGND6: C69.1, R11.1, R12.1, U$11.AGND, U$11.M3
GND: C1.1, C2.1, C3.2, C9.-, C11.1, C12.2, C13.1, R1.2, U$1.GND, U$1.GND_A, U$1.GND_B, U$1.GND_C, U$1.GND_D, U$1.PWM_B, U$1.PWM_D, U$2.G, X3.1
GND1: C10.1, C14.1, C15.1, C16.2, C22.-, C23.2, C24.1, R3.2, U$3.GND, U$3.GND_A, U$3.GND_B, U$3.GND_C, U$3.GND_D, U$3.PWM_B, U$3.PWM_D, U$4.G, X6.1
GND2: C25.1, C26.1, C27.1, C28.2, C34.-, C35.2, C36.1, R5.2, U$5.GND, U$5.GND_A, U$5.GND_B, U$5.GND_C, U$5.GND_D, U$5.PWM_B, U$5.PWM_D, U$6.G, X9.1
GND3: C37.1, C38.1, C39.1, C40.2, C46.-, C47.2, C48.1, R7.2, U$7.GND, U$7.GND_A, U$7.GND_B, U$7.GND_C, U$7.GND_D, U$7.PWM_B, U$7.PWM_D, U$8.G, X12.1
GND4: C49.1, C50.1, C51.1, C52.2, C58.-, C59.2, C60.1, R9.2, U$9.GND, U$9.GND_A, U$9.GND_B, U$9.GND_C, U$9.GND_D, U$9.PWM_B, U$9.PWM_D, U$10.G, X15.1
GND5: C61.1, C62.1, C63.1, C64.2, C70.-, C71.2, C72.1, R11.2, U$11.GND, U$11.GND_A, U$11.GND_B, U$11.GND_C, U$11.GND_D, U$11.PWM_B, U$11.PWM_D, U$12.G, X18.1
M1_1: C7.2, U$1.OUT_A, X1.2
M1_2: C5.2, U$1.OUT_B, X1.1
M1_3: C18.2, U$3.OUT_B, X4.1
M1_4: C20.2, U$3.OUT_A, X4.2
M1_5: C30.2, U$5.OUT_B, X7.1
M1_6: C32.2, U$5.OUT_A, X7.2
M1_7: C42.2, U$7.OUT_B, X10.1
M1_8: C44.2, U$7.OUT_A, X10.2
M1_9: C54.2, U$9.OUT_B, X13.1
M1_10: C56.2, U$9.OUT_A, X13.2
M1_11: C66.2, U$11.OUT_B, X16.1
M1_12: C68.2, U$11.OUT_A, X16.2
M2_1: C4.2, U$1.OUT_C, X2.2
M2_2: C6.2, U$1.OUT_D, X2.1
M2_3: C19.2, U$3.OUT_D, X5.1
M2_4: C17.2, U$3.OUT_C, X5.2
M2_5: C31.2, U$5.OUT_D, X8.1
M2_6: C29.2, U$5.OUT_C, X8.2
M2_7: C43.2, U$7.OUT_D, X11.1
M2_8: C41.2, U$7.OUT_C, X11.2
M2_9: C55.2, U$9.OUT_D, X14.1
M2_10: C53.2, U$9.OUT_C, X14.2
M2_11: C67.2, U$11.OUT_D, X17.1
M2_12: C65.2, U$11.OUT_C, X17.2
MDRST: U$1.RESET_AB, U$1.RESET_CD, X3.2
MDRST1: U$3.RESET_AB, U$3.RESET_CD, X6.2
MDRST2: U$5.RESET_AB, U$5.RESET_CD, X9.2
MDRST3: U$7.RESET_AB, U$7.RESET_CD, X12.2
MDRST4: U$9.RESET_AB, U$9.RESET_CD, X15.2
MDRST5: U$11.RESET_AB, U$11.RESET_CD, X18.2
unnamed: C19.1, U$3.BST_D
unnamed: C17.1, U$3.BST_C
unnamed: C18.1, U$3.BST_B
unnamed: C20.1, U$3.BST_A
unnamed: C6.1, U$1.BST_D
unnamed: C4.1, U$1.BST_C
unnamed: C5.1, U$1.BST_B
unnamed: C7.1, U$1.BST_A
unnamed: R4.2, U$3.OC_ADJ
unnamed: C31.1, U$5.BST_D
unnamed: C29.1, U$5.BST_C
unnamed: R2.2, U$1.OC_ADJ
unnamed: C30.1, U$5.BST_B
unnamed: C32.1, U$5.BST_A
unnamed: R6.2, U$5.OC_ADJ
unnamed: C43.1, U$7.BST_D
unnamed: C41.1, U$7.BST_C
unnamed: C42.1, U$7.BST_B
unnamed: C44.1, U$7.BST_A
unnamed: R8.2, U$7.OC_ADJ
unnamed: C55.1, U$9.BST_D
unnamed: C53.1, U$9.BST_C
unnamed: C54.1, U$9.BST_B
unnamed: C56.1, U$9.BST_A
unnamed: R10.2, U$9.OC_ADJ
unnamed: C67.1, U$11.BST_D
unnamed: C65.1, U$11.BST_C
unnamed: C66.1, U$11.BST_B
unnamed: C68.1, U$11.BST_A
unnamed: R12.2, U$11.OC_ADJ
PWM1: U$1.PWM_A, X3.4
PWM2: U$1.PWM_C, X3.3
PWM3: U$3.PWM_C, X6.3
PWM4: U$3.PWM_A, X6.4
PWM5: U$5.PWM_C, X9.3
PWM6: U$5.PWM_A, X9.4
PWM7: U$7.PWM_C, X12.3
PWM8: U$7.PWM_A, X12.4
PWM9: U$9.PWM_C, X15.3
PWM10: U$9.PWM_A, X15.4
PWM11: U$11.PWM_C, X18.3
PWM12: U$11.PWM_A, X18.4
VM: C1.2, C2.2, C3.1, C9.+, C11.2, C12.1, C13.2, U$1.GVDD_A, U$1.GVDD_B, U$1.GVDD_C, U$1.GVDD_D, U$1.PVDD_A, U$1.PVDD_B, U$1.PVDD_C, U$1.PVDD_D, U$1.VDD, U$2.+
VM1: C10.2, C14.2, C15.2, C16.1, C22.+, C23.1, C24.2, U$3.GVDD_A, U$3.GVDD_B, U$3.GVDD_C, U$3.GVDD_D, U$3.PVDD_A, U$3.PVDD_B, U$3.PVDD_C, U$3.PVDD_D, U$3.VDD, U$4.+
VM2: C25.2, C26.2, C27.2, C28.1, C34.+, C35.1, C36.2, U$5.GVDD_A, U$5.GVDD_B, U$5.GVDD_C, U$5.GVDD_D, U$5.PVDD_A, U$5.PVDD_B, U$5.PVDD_C, U$5.PVDD_D, U$5.VDD, U$6.+
VM3: C37.2, C38.2, C39.2, C40.1, C46.+, C47.1, C48.2, U$7.GVDD_A, U$7.GVDD_B, U$7.GVDD_C, U$7.GVDD_D, U$7.PVDD_A, U$7.PVDD_B, U$7.PVDD_C, U$7.PVDD_D, U$7.VDD, U$8.+
VM4: C49.2, C50.2, C51.2, C52.1, C58.+, C59.1, C60.2, U$9.GVDD_A, U$9.GVDD_B, U$9.GVDD_C, U$9.GVDD_D, U$9.PVDD_A, U$9.PVDD_B, U$9.PVDD_C, U$9.PVDD_D, U$9.VDD, U$10.+
VM5: C61.2, C62.2, C63.2, C64.1, C70.+, C71.1, C72.2, U$11.GVDD_A, U$11.GVDD_B, U$11.GVDD_C, U$11.GVDD_D, U$11.PVDD_A, U$11.PVDD_B, U$11.PVDD_C, U$11.PVDD_D, U$11.VDD, U$12.+
VREG1: C8.2, U$1.M1, U$1.M2, U$1.VREG
VREG2: C21.2, U$3.M1, U$3.M2, U$3.VREG
VREG3: C33.2, U$5.M1, U$5.M2, U$5.VREG
VREG4: C45.2, U$7.M1, U$7.M2, U$7.VREG
VREG5: C57.2, U$9.M1, U$9.M2, U$9.VREG
VREG6: C69.2, U$11.M1, U$11.M2, U$11.VREG
