TomiXRM/LEGEND_RCJ/RoboCup-LEGEND2021/circuit/LEGEND2022/main2.brd

## EAGLE design RoboCup-LEGEND2021/circuit/LEGEND2022/main2.brd (2023-12-11)

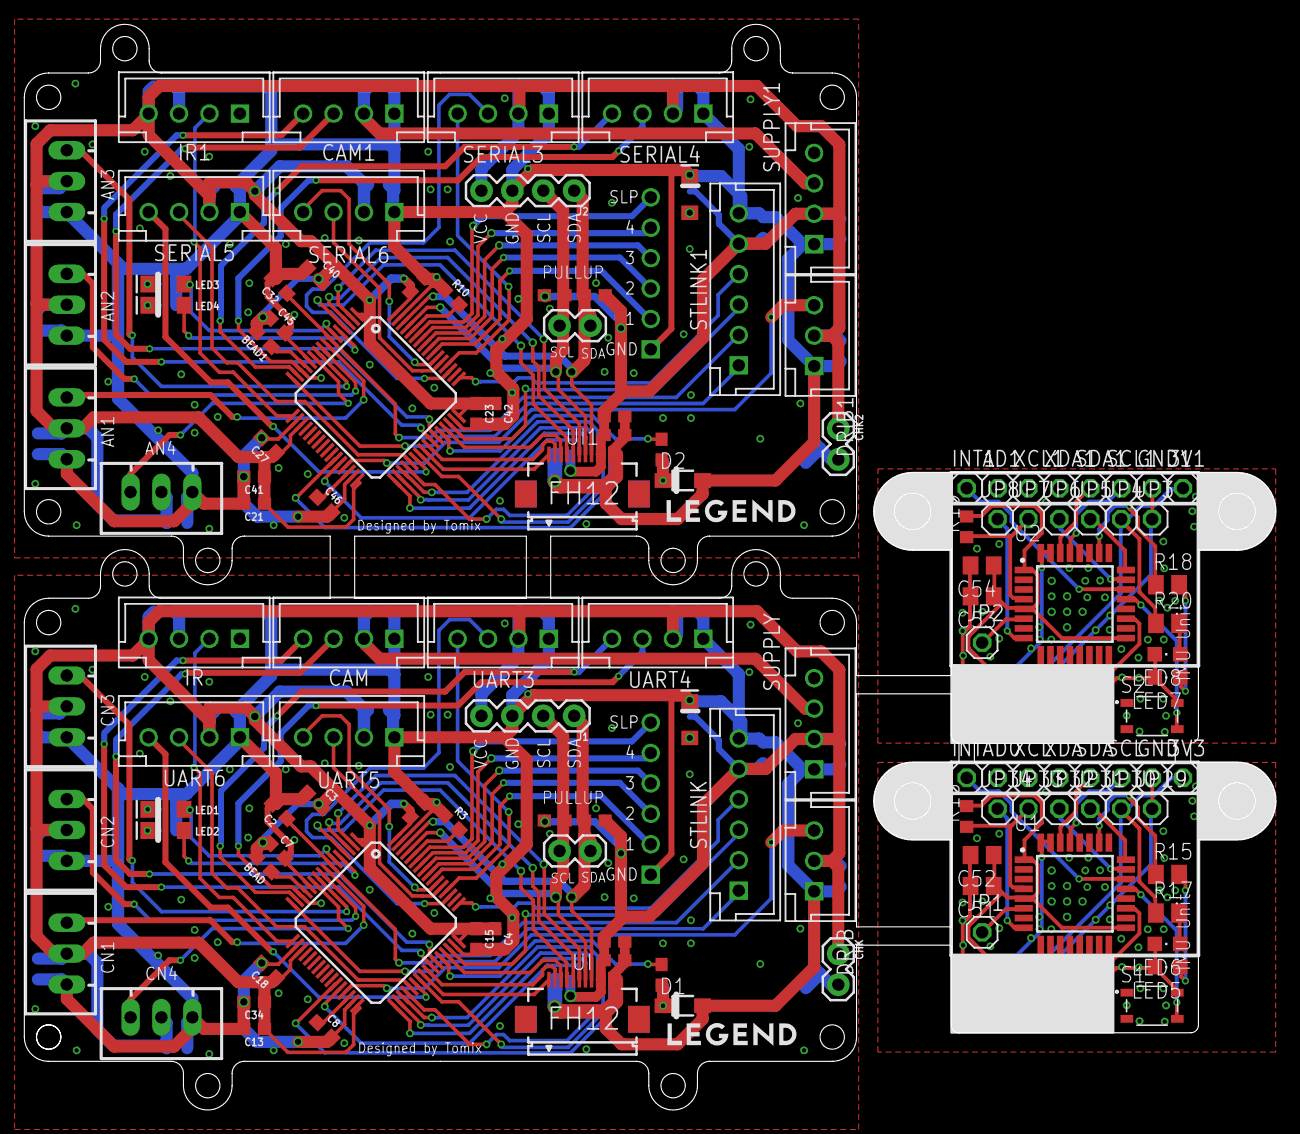
[picture p81: board main2.brd from above]

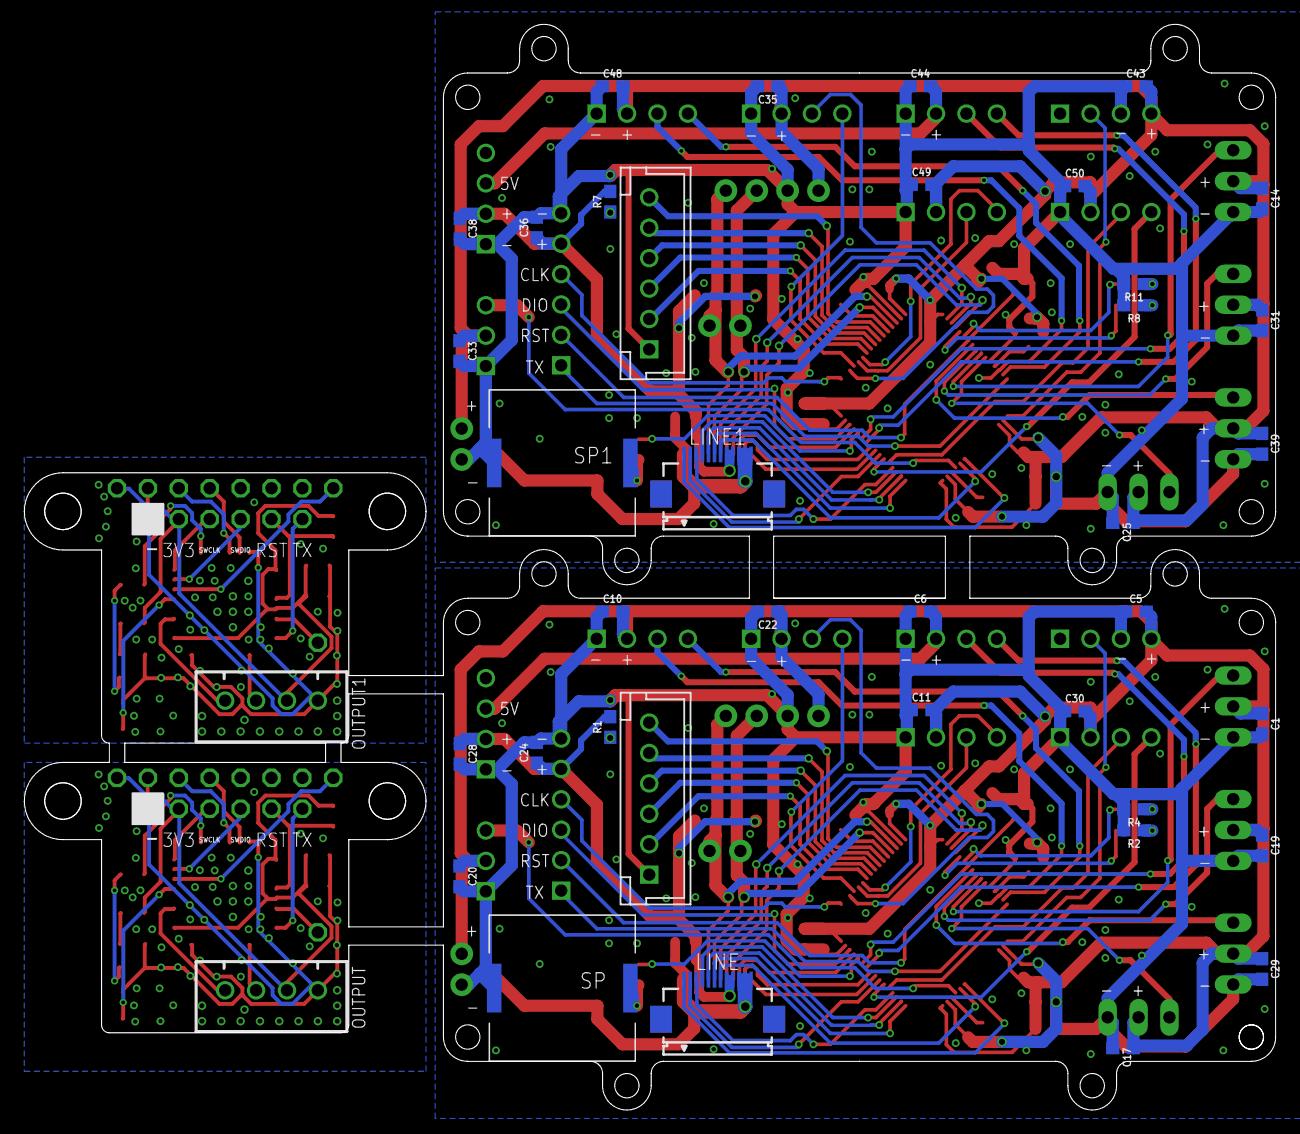
[picture p82: board main2.brd from below]

Board: 2 copper layers, 102.9 x 89.3 mm, 166 parts (40 on the bottom side), 136 nets.

Parts:
3V1, 3V3: 1X01
AD0, AD1: 1X01
AN1: 1; JST-XH-03-PACKAGE-LONG-PAD
AN2: 2; JST-XH-03-PACKAGE-LONG-PAD
AN3: 3; JST-XH-03-PACKAGE-LONG-PAD
AN4: 4; JST-XH-03-PACKAGE-LONG-PAD
BEAD, BEAD1: 0; 0603
C1, C14: 0.1uF; 1608
C2, C3, C4, C5, C6, C7, C10, C11, C12, C13, C15, C16, C17, C18, C19, C20, C21, C22, C23, C24, C25, C27, C30, C31, C32, C33, C35, C36, C40, C42, C43, C44, C45, C48, C49, C50: 0.1UF_1608; 1608
C8, C46: 4.7uF; 0603
C9, C34, C41, C47: 0.1uF; 0603
C26, C37: 0.001UF_1608; 1608
C28, C29, C38, C39: 1.0UF_1608; 1608
C51, C52, C53, C54: 0.1u; C0805
CAM, CAM1: cam; B4B-XH-A
CHK, CHK1, CHK2, CHK3: +3V3; 1X02
CN1: 1; JST-XH-03-PACKAGE-LONG-PAD
CN2: 2; JST-XH-03-PACKAGE-LONG-PAD
CN3: 3; JST-XH-03-PACKAGE-LONG-PAD
CN4: 4; JST-XH-03-PACKAGE-LONG-PAD
D1, D2: DIODE-SS2040LFL; SOD123FL
DRIB, DRIB1: B3B-XH-A
GND, GND1: 1X01
INT, INT1: 1X01
IR, IR1: IR; B4B-XH-A
J1, J2: 1X04
JP1, JP2, JP3, JP4, JP5, JP6, JP7, JP8, JP29, JP30, JP31, JP32, JP33, JP34: 1X01
LED1, LED2, LED3, LED4: LED-1206
LED5, LED6, LED7, LED8: CHIPLED_0805
LINE, LINE1: FH12-12S-0.5SH
MD_A, MD_A1: B6B-XH-A
NUCLEO_MAIN, NUCLEO_MAIN1: F446RET6; STM32F446RET6
OUTPUT, OUTPUT1: JST-XH-04-PIN-ROUND-PAD; JST-XH-04-PACKAGE-ROUND-PAD
PILOT, PILOT1: LED-1206
R1, R2, R4, R5, R6, R7, R8, R9, R11, R12, R13, R14: 1k; R0603
R3, R10, R16, R19: 10k; R0603
R15, R17, R18, R20: 1k; M0805
S1, S2: SKRPACE010; SW_SKRPACE010
SCL, SCL1: 1X01
SDA, SDA1: 1X01
SERIAL3, SERIAL4, SERIAL5, SERIAL6: IMU; B4B-XH-A
SP, SP1: PKLCS1212E4001
STLINK, STLINK1: MAIN; B6B-XH-A
SUPPLY, SUPPLY1: B4B-XH-A
U1, U2: STM32F303K8T6; QFP80P900X900X160-32N
UART3, UART4, UART5, UART6: IMU; B4B-XH-A
UI, UI1: FH12-12S-0.5SH
XCL, XCL1: 1X01
XDA, XDA1: 1X01

Connections:
+3V1: 3V1.1, C53.1, C54.1, JP4.1, OUTPUT1.2, R19.2, R20.1, U2.1, U2.5, U2.17
+3V3: 3V3.1, C51.1, C52.1, JP30.1, OUTPUT.2, R16.2, R17.1, U1.1, U1.5, U1.17
+5V: C6.2, CAM.2, SUPPLY.3
+5V1: C44.2, CAM1.2, SUPPLY1.3
A0: JP1.1, U1.6
A9: JP2.1, U2.6
ANALOG: OUTPUT.3, U1.10
ANALOG1: OUTPUT1.3, U2.10
BALLRX: IR.2, NUCLEO_MAIN.PA3
BALLRX1: IR1.2, NUCLEO_MAIN1.PA3
BOOT0: NUCLEO_MAIN.BOOT0, R3.2
BOOT1: NUCLEO_MAIN1.BOOT0, R10.2
BUTTON_CENTER: NUCLEO_MAIN.PC14, UI.5
BUTTON_CENTER1: NUCLEO_MAIN1.PC14, UI1.5
BUTTON_LEFT: NUCLEO_MAIN.PC15, UI.4
BUTTON_LEFT1: NUCLEO_MAIN1.PC15, UI1.4
BUTTON_RIGHT: NUCLEO_MAIN.PC13, UI.6
BUTTON_RIGHT1: NUCLEO_MAIN1.PC13, UI1.6
BUZZER: NUCLEO_MAIN.PA11, R9.1
BUZZER1: NUCLEO_MAIN1.PA11, R12.1
CN1: CN1.3, NUCLEO_MAIN.PC0
CN2: CN2.3, NUCLEO_MAIN.PC1
CN3: CN3.3, NUCLEO_MAIN.PC2
CN4: CN4.3, NUCLEO_MAIN.PC3
CN5: AN1.3, NUCLEO_MAIN1.PC0
CN6: AN2.3, NUCLEO_MAIN1.PC1
CN7: AN3.3, NUCLEO_MAIN1.PC2
CN8: AN4.3, NUCLEO_MAIN1.PC3
D5: R18.1, U2.26
D13: R15.1, U1.26
DRIB_PWM: DRIB.3, NUCLEO_MAIN.PB10
DRIB_PWM1: DRIB1.3, NUCLEO_MAIN1.PB10
GND: C51.2, C52.2, GND.1, JP29.1, LED5.C, LED6.C, OUTPUT.1, S1.2, U1.16, U1.31, U1.32
GND1: C53.2, C54.2, GND1.1, JP3.1, LED7.C, LED8.C, OUTPUT1.1, S2.2, U2.16, U2.31, U2.32
INT: INT.1, U1.22
INT1: INT1.1, U2.22
LED1: LED1.A, NUCLEO_MAIN.PH1
LED2: LED2.A, NUCLEO_MAIN.PH0
LED3: LED4.A, NUCLEO_MAIN1.PH0
LED4: LED3.A, NUCLEO_MAIN1.PH1
LINE_A0: LINE.6, NUCLEO_MAIN.PB12
LINE_A1: LINE.5, NUCLEO_MAIN.PB13
LINE_A2: LINE.4, NUCLEO_MAIN.PB14
LINE_A3: LINE.3, NUCLEO_MAIN.PB15
LINE_A4: LINE.2, NUCLEO_MAIN.PC8
LINE_A5: LINE1.2, NUCLEO_MAIN1.PC8
LINE_A6: LINE1.3, NUCLEO_MAIN1.PB15
LINE_A7: LINE1.4, NUCLEO_MAIN1.PB14
LINE_A8: LINE1.5, NUCLEO_MAIN1.PB13
LINE_A9: LINE1.6, NUCLEO_MAIN1.PB12
LINE_ANALOG: LINE.1, NUCLEO_MAIN.PB1
LINE_ANALOG1: LINE1.1, NUCLEO_MAIN1.PB1
LINE_PWM: LINE.7, NUCLEO_MAIN.PB2
LINE_PWM1: LINE1.7, NUCLEO_MAIN1.PB2
unnamed: LED2.C, R2.1
unnamed: LED1.C, R4.1
unnamed: LED4.C, R8.1
unnamed: LED3.C, R11.1
unnamed: LED5.A, R15.2
unnamed: LED6.A, R17.2
unnamed: LED7.A, R18.2
unnamed: LED8.A, R20.2
NRST: C2.1, NUCLEO_MAIN.NRST, STLINK.2
NRST1: C32.1, NUCLEO_MAIN1.NRST, STLINK1.2
PH1: MD_A.2, NUCLEO_MAIN.PB3
PH2: MD_A.3, NUCLEO_MAIN.PB4
PH3: MD_A.4, NUCLEO_MAIN.PB5
PH4: MD_A.5, NUCLEO_MAIN.PB6
PH5: MD_A1.4, NUCLEO_MAIN1.PB5
PH6: MD_A1.3, NUCLEO_MAIN1.PB4
PH7: MD_A1.2, NUCLEO_MAIN1.PB3
PH8: MD_A1.5, NUCLEO_MAIN1.PB6
POWERLED_RESISTOR: PILOT.A, R1.1
POWERLED_RESISTOR1: PILOT1.A, R7.1
RESET: JP33.1, R16.1, U1.4
RESET1: JP7.1, R19.1, U2.4
RGB_B: NUCLEO_MAIN.PA12, UI.3
RGB_B1: NUCLEO_MAIN1.PA12, UI1.3
RGB_G: NUCLEO_MAIN.PA8, UI.2
RGB_G1: NUCLEO_MAIN1.PA8, UI1.2
RGB_R: NUCLEO_MAIN.PC9, UI.1
RGB_R1: NUCLEO_MAIN1.PC9, UI1.1
SCL: CHK1.1, J1.2, NUCLEO_MAIN.PB8, R6.1, UI.7
SCL1: CHK3.1, J2.2, NUCLEO_MAIN1.PB8, R14.1, UI1.7
SCL2: SCL.1, U1.29
SCL3: SCL1.1, U2.29
SDA: CHK1.2, J1.1, NUCLEO_MAIN.PB9, R5.1, UI.8
SDA1: CHK3.2, J2.1, NUCLEO_MAIN1.PB9, R13.1, UI1.8
SDA2: SDA.1, U1.30
SDA3: SDA1.1, U2.30
SERIAL1RX: CAM.3, NUCLEO_MAIN.PA10
SERIAL1RX1: CAM1.3, NUCLEO_MAIN1.PA10
SERIAL1TX: CAM.4, NUCLEO_MAIN.PA9
SERIAL1TX1: CAM1.4, NUCLEO_MAIN1.PA9
SERIAL3RX: NUCLEO_MAIN.PC11, UART3.4
SERIAL3RX1: NUCLEO_MAIN1.PC11, SERIAL3.4
SERIAL3TX: NUCLEO_MAIN.PC10, UART3.3
SERIAL3TX1: NUCLEO_MAIN1.PC10, SERIAL3.3
SERIAL4RX: NUCLEO_MAIN.PA1, UART4.4
SERIAL4RX1: NUCLEO_MAIN1.PA1, SERIAL4.4
SERIAL4TX: NUCLEO_MAIN.PA0, UART4.3
SERIAL4TX1: NUCLEO_MAIN1.PA0, SERIAL4.3
SERIAL5RX: NUCLEO_MAIN.PD2, UART5.4
SERIAL5RX1: NUCLEO_MAIN1.PD2, SERIAL6.4
SERIAL5TX: NUCLEO_MAIN.PC12, UART5.3
SERIAL5TX1: NUCLEO_MAIN1.PC12, SERIAL6.3
SERIAL6RX: NUCLEO_MAIN.PC7, UART6.4
SERIAL6RX1: NUCLEO_MAIN1.PC7, SERIAL5.4
SERIAL6TX: NUCLEO_MAIN.PC6, UART6.3
SERIAL6TX1: NUCLEO_MAIN1.PC6, SERIAL5.3
SLEEP: MD_A.6, NUCLEO_MAIN.PB7
SLEEP1: MD_A1.6, NUCLEO_MAIN1.PB7
SP: D1.C, R9.2, SP.1
SP1: D2.C, R12.2, SP1.1
SW: S1.4, U1.21
SW1: S2.4, U2.21
SWCLK: NUCLEO_MAIN.PA14, STLINK.4
SWCLK1: NUCLEO_MAIN1.PA14, STLINK1.4
SWCLK2: JP31.1, U1.24
SWCLK3: JP5.1, U2.24
SWDIO: NUCLEO_MAIN.PA13, STLINK.3
SWDIO1: NUCLEO_MAIN1.PA13, STLINK1.3
SWDIO2: JP32.1, U1.23
SWDIO3: JP6.1, U2.23
TX1: OUTPUT.4, U1.19
TX2: OUTPUT1.4, U2.19
USBTX: NUCLEO_MAIN.PA2, STLINK.1
USBTX1: NUCLEO_MAIN1.PA2, STLINK1.1
USBTX2: JP34.1, U1.8
USBTX3: JP8.1, U2.8
VCAP: C8.1, NUCLEO_MAIN.VCAP_1
VCAP1: C46.1, NUCLEO_MAIN1.VCAP_1
VCC: AN1.2, AN2.2, AN3.2, AN4.2, BEAD.2, BEAD1.2, C1.1, C3.2, C4.1, C5.2, C7.1, C9.1, C10.2, C11.2, C12.1, C13.1, C14.1, C15.1, C16.1, C17.1, C18.1, C19.1, C20.1, C21.1, C22.1, C23.1, C24.1, C25.1, C26.1, C27.1, C28.1, C29.1, C30.2, C31.1, C33.1, C34.1, C35.1, C36.1, C37.1, C38.1, C39.1, C40.2, C41.1, C42.1, C43.2, C45.1, C47.1, C48.2, C49.2, C50.2, CHK.1, CHK2.1, CN1.2, CN2.2, CN3.2, CN4.2, DRIB.2, DRIB1.2, IR.4, IR1.4, J1.4, J2.4, LINE.8, LINE.9, LINE1.8, LINE1.9, NUCLEO_MAIN.VBAT, NUCLEO_MAIN.VDD, NUCLEO_MAIN.VDD1, NUCLEO_MAIN.VDD2, NUCLEO_MAIN.VDD3, NUCLEO_MAIN1.VBAT, NUCLEO_MAIN1.VDD, NUCLEO_MAIN1.VDD1, NUCLEO_MAIN1.VDD2, NUCLEO_MAIN1.VDD3, R1.2, R5.2, R6.2, R7.2, R13.2, R14.2, SERIAL3.2, SERIAL4.2, SERIAL5.2, SERIAL6.2, STLINK.5, STLINK1.5, SUPPLY.2, SUPPLY1.2, UART3.2, UART4.2, UART5.2, UART6.2, UI.9, UI.10, UI1.9, UI1.10
VDDA: BEAD.1, NUCLEO_MAIN.VREF+
VDDA1: BEAD1.1, NUCLEO_MAIN1.VREF+
VSS: AN1.1, AN2.1, AN3.1, AN4.1, C1.2, C2.2, C3.1, C4.2, C5.1, C6.1, C7.2, C8.2, C9.2, C10.1, C11.1, C12.2, C13.2, C14.2, C15.2, C16.2, C17.2, C18.2, C19.2, C20.2, C21.2, C22.2, C23.2, C24.2, C25.2, C26.2, C27.2, C28.2, C29.2, C30.1, C31.2, C32.2, C33.2, C34.2, C35.2, C36.2, C37.2, C38.2, C39.2, C40.1, C41.2, C42.2, C43.1, C44.1, C45.2, C46.2, C47.2, C48.1, C49.1, C50.1, CAM.1, CAM1.1, CHK.2, CHK2.2, CN1.1, CN2.1, CN3.1, CN4.1, D1.A, D2.A, DRIB.1, DRIB1.1, IR.3, IR1.3, J1.3, J2.3, LINE.10, LINE.11, LINE.12, LINE1.10, LINE1.11, LINE1.12, MD_A.1, MD_A1.1, NUCLEO_MAIN.VREF-, NUCLEO_MAIN.VSS, NUCLEO_MAIN.VSS1, NUCLEO_MAIN.VSS2, NUCLEO_MAIN.VSS3, NUCLEO_MAIN1.VREF-, NUCLEO_MAIN1.VSS, NUCLEO_MAIN1.VSS1, NUCLEO_MAIN1.VSS2, NUCLEO_MAIN1.VSS3, PILOT.C, PILOT1.C, R2.2, R3.1, R4.2, R8.2, R10.1, R11.2, SERIAL3.1, SERIAL4.1, SERIAL5.1, SERIAL6.1, SP.2, SP1.2, STLINK.6, STLINK1.6, SUPPLY.1, SUPPLY1.1, UART3.1, UART4.1, UART5.1, UART6.1, UI.11, UI.12, UI1.11, UI1.12
