TomiXRM/LEGEND_RCJ/RoboCup-LEGEND2021/program/main1_mbedOS_updated/include/pinDefs.h

#pragma once
//LED
#define LED1 PH_1
#define LED2 PH_0
// #define LED3 PF_13

//LINE Sensor
#define LINE_SIG PB_1
#define LINE_A0 PB_12
#define LINE_A1 PB_13
#define LINE_A2 PB_14
#define LINE_A3 PB_15
#define LINE_A4 PC_8
#define LINE_PWM PB_2

//Button
#define BUTTON_LEFT PC_15
#define BUTTON_CENTRE PC_14
#define BUTTON_RIGHT PC_13

//Buzzer
#define BUZZER PA_11

//Dribbler
#define DRIB_PWM PB_10

//Kicker
#define KICKER_PHOTO1 PC_2
#define KICKER_PHOTO2 PC_1
#define KICKER_KICK PC_0

//I2C (FREE)
// #define I2C_SDA PF_15
// #define I2C_SCL PF_14

//CN (ADC)
#define CN3 PC_2
#define CN4 PC_3

// #define CN1 PF_3
// #define CN2 PF_4
// #define CN3 PF_5
// #define CN4 PF_6
// #define CN5 PF_7
// #define CN6 PF_8
// #define CN7 PF_9
// #define CN8 PF_10
// #define CN9 PC_0
// #define CN10 PC_1
// #define CN11 PC_2

//Bridge
// #define BRIDGE_TX PA_9
// #define BRIDGE_RX PA_10
// #define BRIDGE_IO1 PA_4
// #define BRIDGE_IO2 PA_5

//UART
#define UART_3_TX PC_10
#define UART_3_RX PC_11

#define UART_4_TX PA_0
#define UART_4_RX PA_1

#define UART_5_TX PC_12
#define UART_5_RX PD_2

#define UART_6_TX PC_6
#define UART_6_RX PC_7
// //IMU
// #define IMU_TX PC_10
// #define IMU_RX PC_11

//MOUSE
#define MOUSE_TX PC_10
#define MOUSE_RX PC_11

//CAM
#define CAM_TX PA_9
#define CAM_RX PA_10

//PC&IR
#define PC_TX PA_2
#define IR_RX PA_3
// #define IR_INT PE_15

//RGB
#define RGB_R PC_9
#define RGB_G PA_8
#define RGB_B PA_12

//DIPSW
// #define DIPSW1 PF_11
// #define DIPSW2 PF_12
// #define DIPSW3 PG_0
// #define DIPSW4 PG_1

//Motor
#define MD_SLP PB_7
//[A]
#define MD_1 PB_4
#define MD_2 PB_3
#define MD_3 PB_6
#define MD_4 PB_5

// //[B]dedeed
// #define MD_B_EN1 PE_13
// #define MD_B_PH1 PE_14
// #define MD_B_EN2 PB_10
// #define MD_B_PH2 PB_11

//SPI
// #define SPI_SCK PB_3
// #define SPI_MISO PB_4
// #define SPI_MOSI PB_5
