TomiXRM/LEGEND_RCJ/RoboCup2019_Optimized/Program/Robot/Slave/Bridge/src/SysDefs.hpp

#ifndef _SYS_DEFS_HPP_
#define _SYS_DEFS_HPP_

#include "mbed.h"
#define USB_TX PA_2
#define USB_RX PA_3
#define SPPTX PA_10
#define SPPRX PA_9

#define GPIO1 PB_6
#define GPIO2 PB_5
#define GPIO3 PB_4
#define GPIO4 PB_3

#define DUMMY_DIO PB_0

#define MOSI PA_7
#define MISO PA_6
#define SCLK PA_5
#define SS PA_4


#define LED1 PA_15
#define LED2 PA_8

#endif
