TomiXRM/LEGEND_RCJ/RoboCup-LEGEND2021/program/main1_mbedOS_updated/include/modes/ballMode.h

#ifndef _BALLMODE_H_
#define _BALLMODE_H_
#include "setup.h"

void before_Ball() {
    // ボールモニタ初期化処理
    pc.printf("start Ball mode!\r\n");
    //   LCD.menuText("Ball now\r\n");
}

void body_Ball() {
    // ボールモニタ表示処理
    sensors.irRecieved = IR.data;  // 取得開始
    sensors.irDeg = IR.getDir();   // 角度代入
    sensors.irDist = IR.getDist(); // 距離代

    uint8_t dist = sensors.irDist;

    LCD.Ballrt(dist, sensors.irDeg);
    pc.printf("irRecieved:%d\t irDeg:%d\t irDist:%d\t ", sensors.irRecieved, sensors.irDeg, sensors.irDist);
    pc.printf("PhotoF:%d\t PhotB:%d\r\n", (uint16_t)(Photo1.read_u16() / 65.535), (uint16_t)(Photo2.read_u16() / 65.535));

    wait_us(5000);
}

void after_Ball() {
    // ボールモニタ終了処理
    pc.printf("After Ball\r\n");
}

const LG_mode_t ballMode = {name : "Ball", before : callback(before_Ball), body : callback(body_Ball), after : callback(after_Ball), modeColor : red};
#endif
