TomiXRM/LEGEND_RCJ/RoboCup2019_Optimized/Program/Robot/Main/Main LEGEND/include/BallProcess.hpp

#include "setup_com.h"
#include "setup.h"

extern LGUI ui;
extern RawSerial pc;
extern LGball IR;
extern AnalogIn Photo;

void Body_Ball();

void initBallProcess(){
        ui.Entry(BALL,DONOTHING,callback(&Body_Ball),DONOTHING);
}
void Body_Ball(){
        IR.get();
        wait_ms(10);
        ui.putc('H');
        ui.putc(IR.data % 256);
        ui.putc(IR.data / 256);
        pc.printf("received:%d \tdegree;:%d \tdistance:%d \t Photo:%d\r\n",IR.data,IR.dir,IR.dist,Photo.read_u16());
}
