TomiXRM/LEGEND_RCJ/RoboCup2019_Optimized/Program/Robot/Slave/Bridge/src/CodeBody.hpp

#ifndef _CODEBODY_HPP_
#define _CODEBODY_HPP_
#include "SysDefs.hpp"
#include "SPP.hpp"
#include "sys.hpp"
#include "SPILib.hpp"
//Mode 1 runner
void BTMaster();
//Mode 2 runner
void BTSlave();
//Mode 3 runner
void BTConfig();
//Mode 4 runner
void Debug();

#endif
