TomiXRM/LEGEND_RCJ/(commit log)

2023-12-11 add all files
    [2021.dxf, 2段目外形.dxf, 3号機.dxf, 3号機3段目.dxf, 3号機オムニバンパー.dxf, 3号機ボールセンサアダプタ.dxf, 3号機十字.dxf, 3号機十字World.dxf]
2024-01-07 🍣京滋奈ブロック2024でmbedOSをアップデートした物を追加
