TomiXRM/LEGEND_RCJ/(notices)

Notices in the files:
parts and their libraries:
SparkFun-Capacitors: Licensing: Creative Commons ShareAlike 4.0 International - https://creativecommons.org/licenses/by-sa/4.0
cap-pan40: Copyright (C) 2004, Bob Starr
inductor-sumida: Copyright (C) 2008, Bob Starr
