TomiXRM/LEGEND_RCJ/MyRobots/MyRobots4.JPG

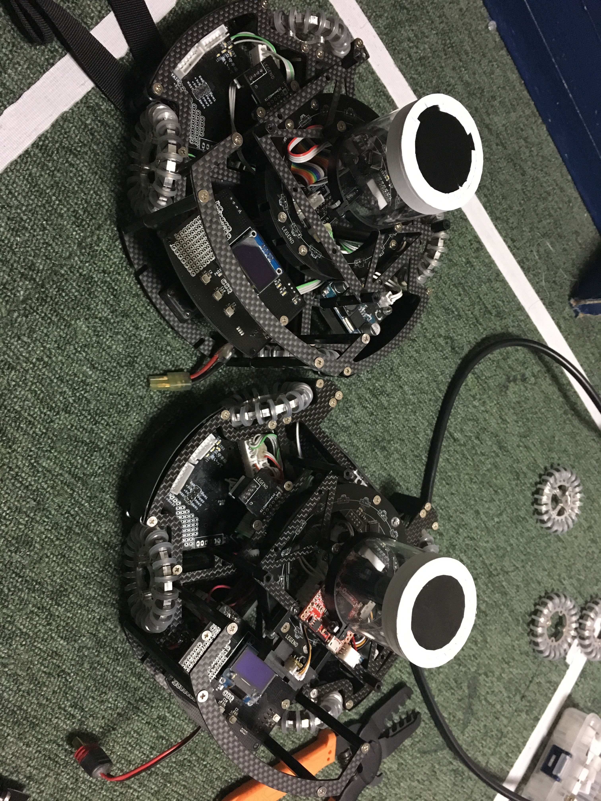
MyRobots/MyRobots4.JPG
